aolofsson/oh/emesh/README.md

EMESH: Various emesh interface circuits
==========================================
