aolofsson/oh/parallella/README.md

PARALLELLA: FPGA logic for the parallella boards
=================================================
