aolofsson/oh/emailbox/README.md

The embox is a fifo style mailbox with an interrupt output signal
