aolofsson/oh/elink/docs/elink.pdf

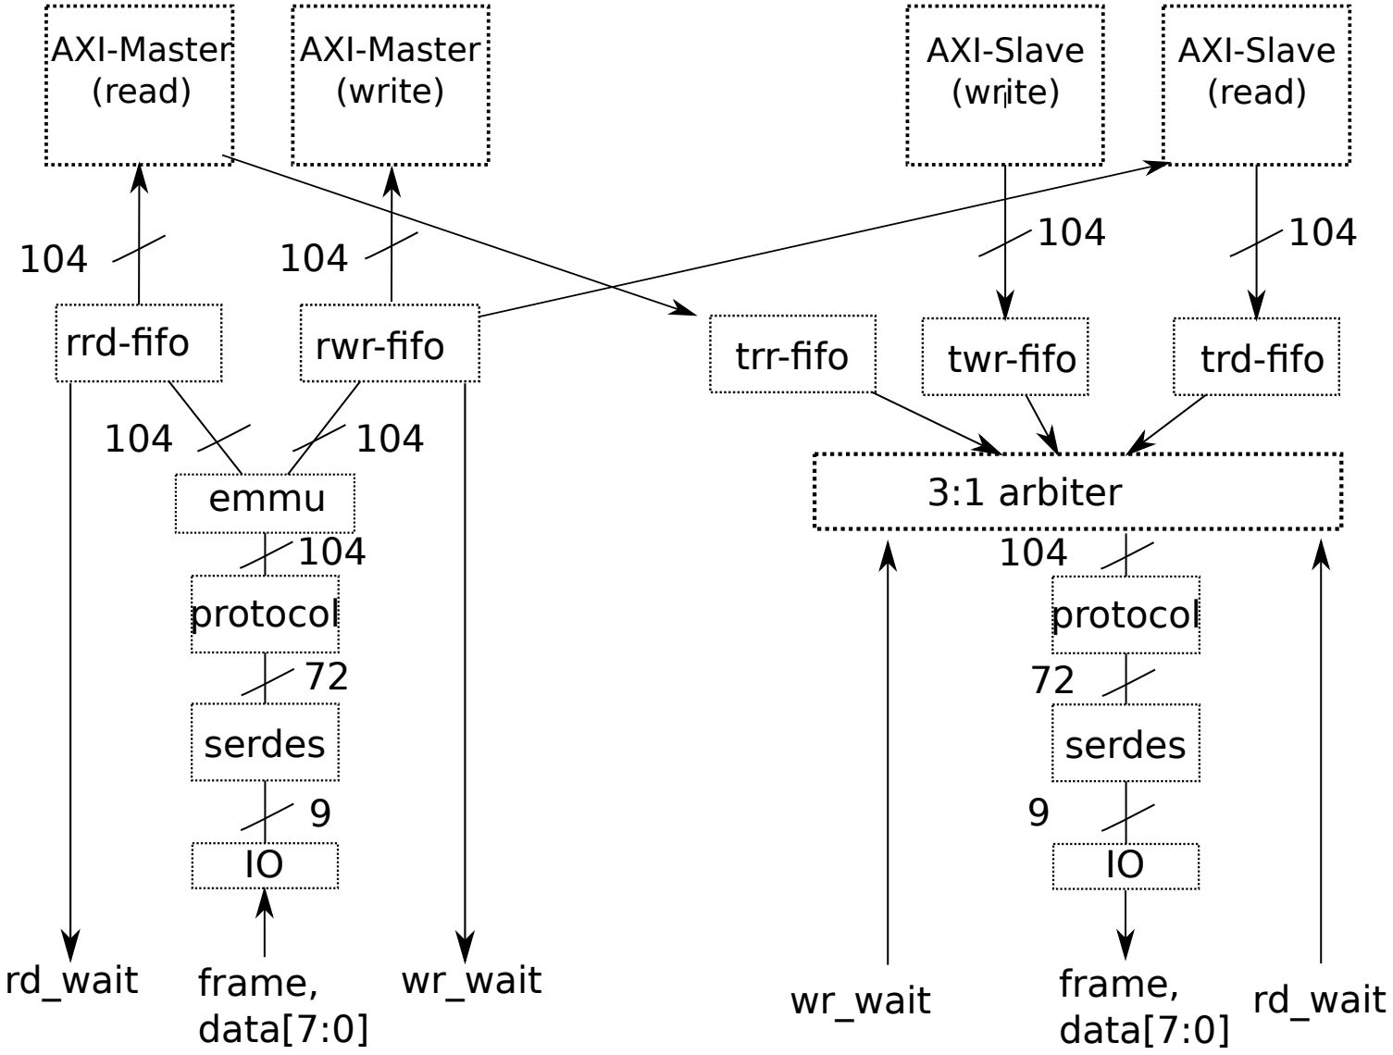
[picture p2: figure]
rrd-fifo; rwr-fifo; AXI-Master (write); AXI-Master (read); rd_wait; frame,; wr_wait; data[7:0]; serdes; protocol; emmu; AXI-Slave (write); AXI-Slave (read); frame, data[7:0]; 3:1 arbiter; trr-fifo; twr-fifo; trd-fifo

RX | TX
