aolofsson/oh/elink/docs/clocking.pdf

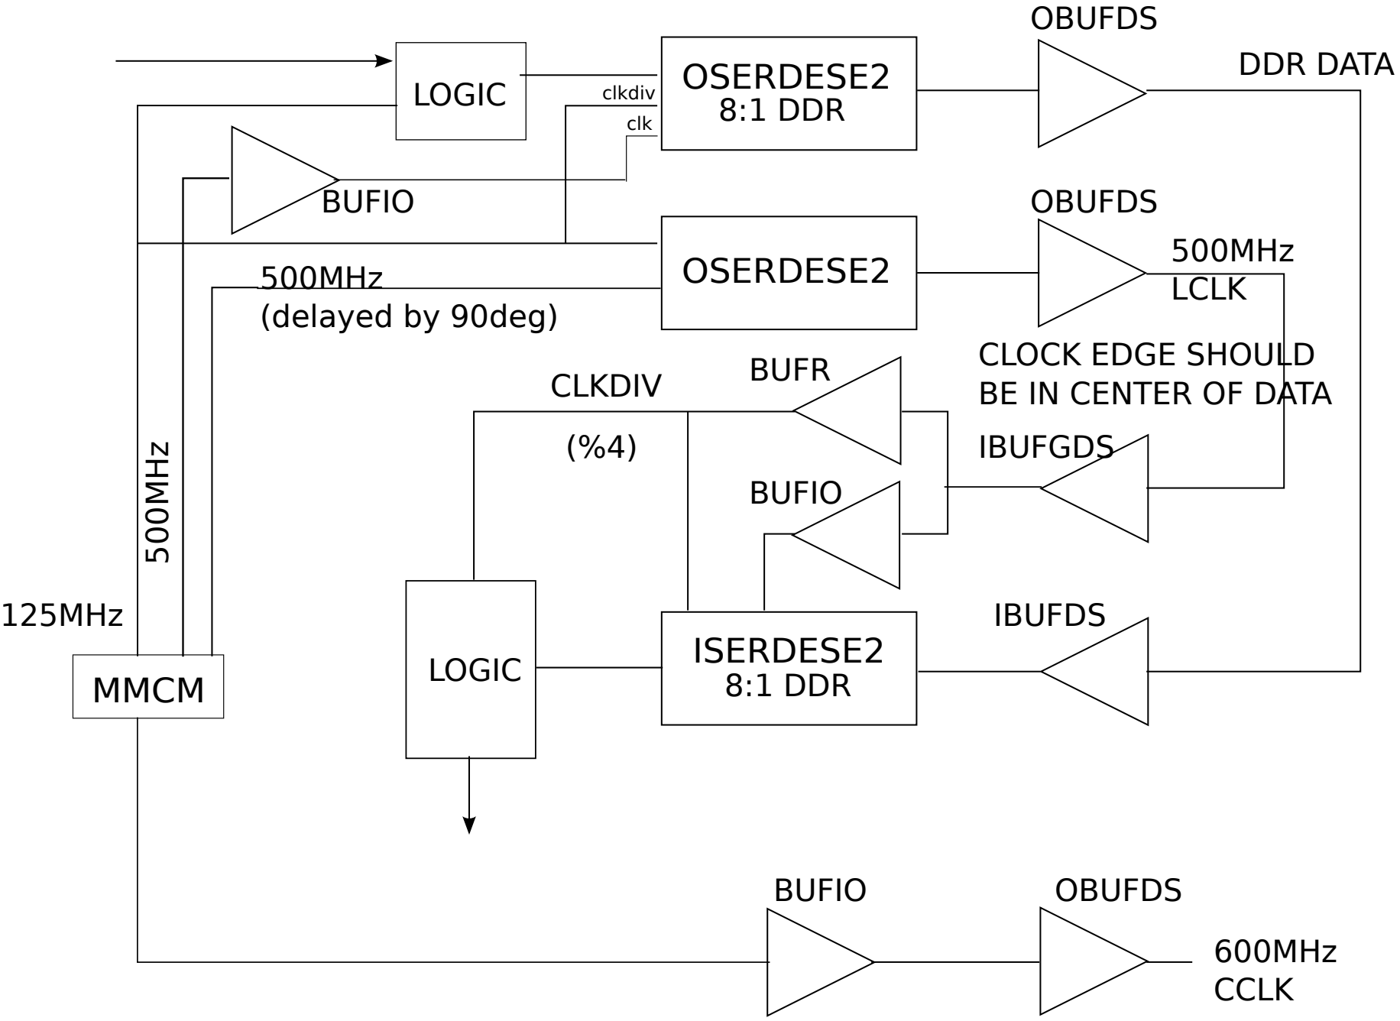
[picture p6: figure]
8:1 DDR; OSERDESE2; ISERDESE2; MMCM; 500MHz LCLK; 600MHz CCLK; OBUFDS; CLOCK EDGE SHOULD BE IN CENTER OF DATA; BUFIO; LOGIC; BUFR; CLKDIV; DDR DATA; 125MHz; 500MHz; clkdiv clk; IBUFGDS; IBUFDS; 500MHz (delayed by 90deg)
