aolofsson/oh/elink/sw/mailbox-test2/README.md

# mailbox tests

Requires the devel version of the redesigned epiphany driver, which can be
found on this branch:

https://github.com/parallella/parallella-linux/tree/ola-devel
