aolofsson/oh/(threads)

Thread 18 (2015-11-11):

streaming and dma doesn't work

olajep, 2015-11-11:
as per fred-test

olajep, 2015-11-11:
Both tests write and read from external ram, i.e., they need remapping to work.

aolofsson, 2015-12-04:
Working

Closed 2015-12-04.

Thread 19 (2015-11-11):

writes to fpga regs during reset can get lost

olajep, 2015-11-11:
1. assert reset bit
2. deassert reset bit
3. write something to RXCFG register
= write gets lost ( RXCFG = 0)

1. assert reset bit
2. deassert reset bit
3. usleep(1000)
4. write something to RXCFG register
= write gets through

Isn't there a AXI wait signal (WREADY?) we can use?

Alternatively can we do a read loop in sw over the reset register until the reset bit reads back as de-asserted?

or make it mandatory to sleep after the reset bit has been deasserted

aolofsson, 2015-11-11:
There is a tx_active signal. Let's see if we can tie this back to make write wait....
In the meantime, usleep(1000)..

olajep, 2015-11-11:
Posting again as github screwed up the formatting in the first try.

#### Case 1
1. assert reset bit
2. deassert reset bit
3. write something to RXCFG register

= write gets lost ( RXCFG = 0)

#### Case 2
1. assert reset bit
2. deassert reset bit
3. usleep(1000)
4. write something to RXCFG register

= write gets through

Isn't there a AXI wait signal (WREADY?) we can use?

Alternatively can we do a read loop in sw over the reset register until the reset bit reads back as de-asserted?

or make it mandatory to sleep after the reset bit has been deasserted

Thread 20 (2015-11-15):

mailbox read timing issue

peteasa, 2015-11-15:
I created an axi mailbox dut and tried out the same read test I tried earlier and still found the same problems
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

Description:  erx_cfgif raises mi_match correctly and mi_cfg_en is raised so that the mailbox read cycle is started, however the mailbox fifo only outputs the data on the rising edge of erx_mailbox.rd_clk and at the same time the erx_mailbox.mailbox_fifo_data with the old content gets sampled and sent to mi_dout.  This can be seen in the attached diagram because the mailbox_fifo_data to the left of the marker gets sampled in the rising edge of the clock and output on mi_dout, however on the next clock cycle the correct data is available on mailbox_fifo_data.

Potential fix is to create a erx_mailbox valid signal emailbox_access_out that must then delay erx_cfgif.access_out so that the correct mailbox data gets delivered to the rxrr fifo.  Last time I tried this fix the simulations failed because changing ecfg_if to take account of the emailbox_access_out affects the etx_cfgif block also. So it is a large change.  Perhaps now it is time to introduce this valid signal for all the ecfg_if.mi_doutX channels?

peteasa, 2015-11-15:
provided pull request that creates what might turn out to be a quick fix.  worried about the delays introduced by the various mux components in the timing chain.. may not work after synthesis

peteasa, 2015-11-28:
Now that the fpga can be loaded into the parallella board I have been trying to continue to get the mailbox working with little success so far.  I will go back to simulation in a while.. but perhaps you can tell me if I am wrong with the following:

I have an e_mailbox.c file that gets built and loaded onto the Epiphany cores.  Just like the Hello_World example.  In the Epiphany I think that I should be able to read the axi_elink registers using:

```C
#define ELINK_BASE	0x81000000
#define E_MAILBOXLO	0xF0310
...
	// Write coreid to the mailbox
	e_coreid_t * dst;
	dst = (e_coreid_t *)(ELINK_BASE | E_MAILBOXLO);
	*dst = coreid;
```
From Epiphany I should be able to read the ERX_CFG register and others as well.

This does not seem to work just yet.

Oh the host side I should be able to read the ELINK_MAILBOXHI, then the ELINK_MAILBOXLO should contain the value I stored in the Epiphany code
```C
	unsigned int mailboxEntry;
	e_debug_read(ELINK_MAILBOXHI, &mailboxEntry);
	printf("HI: 0x%x: 0x%x;  ", ELINK_MAILBOXHI, mailboxEntry);
	e_debug_read(ELINK_MAILBOXLO, &mailboxEntry);
	printf("LO: 0x%x: 0x%x\n", ELINK_MAILBOXLO, mailboxEntry);
```

I can read the registers on the host side and for example I can read the TXCFG register and get 0x1 but when I read this from the Epiphany side I just get 0x0...

Is there something wrong with my software?

aolofsson, 2015-11-29:
Sorry, you can't read the ELINK registers from the Epiphany. They are only accessible from the host. Only the mailbox is writeable (but not readable) from the  Epiphany.

It would have complicated the design and I felt that it wasn't a must have feature.

aolofsson, 2015-11-29:
Fixed the zero order bug on the readback. Once everything else is working, this is a quick fix. (fix is very similiar to 2nd pull request you made). I did not take the pull request as is for style reasons. Hope that's OK, it's just a few lines of code.

Also, there is a silly conceptual bug that I missed. (realized it when I started testing). There is no way to reach 810f0310 from the Epiphany (since this would be routing to the west). I will fix this tomorrow.

peteasa, 2015-11-29:
Not very interested in mailbox readback from epiphany core.

Sounds like my software should have worked so I will try it out with the latest mailbox hdl later this week.  I put the example software in https://github.com/peteasa/examples/tree/parallella-oh/epiphany/mailbox only slight change from the hello world code for now.  But I am guessing that e-lib will change at some point to add specific api for access to the mailbox, plus some small changes to the epiphany driver code to add interrupt handling.

It was fun to see the hello_world test working with the new oh fpga.

peteasa, 2015-11-29:
Puzzled about the comment about routing to the west...  If the Node address is 0x808 ie col 8 row 32 and the destination is 0x810 ie col 16 row 32 then I would have expected routing east to get closer to the higher col number....  back to the typo in the architecture spec.. I believe the diagrams not the words or the table.

aolofsson, 2015-11-29:
Sorry about confusion. Was tired last night...the problem was in the remap
circuit. About to check in working mailbox..reads have been verified.
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

peteasa, 2015-11-30:
It works a treat for me also!  Well done!  Each core is reporting its ID via the mailbox with my test app...
# /usr/epiphany/bin/mailbox
main: rows,cols: ( 4, 4)
main:   0: Message from eCore 0x808 ( 0, 0): main: Error in e_load 37056
"Hello World from core 0x808!"
PRE_STAT=00000001 POST_STAT=00000000 LO=00000808 HI=810f0320
PRE_STAT=00000000 POST_STAT=00000000 LO=00000808 HI=810f0320
main:   1: Message from eCore 0x809 ( 0, 1): main: Error in e_load 37056
"Hello World from core 0x809!"
PRE_STAT=00000001 POST_STAT=00000000 LO=00000809 HI=810f0320
PRE_STAT=00000000 POST_STAT=00000000 LO=00000809 HI=810f0320
main:   2: Message from eCore 0x80a ( 0, 2): main: Error in e_load 37056
"Hello World from core 0x80a!"
PRE_STAT=00000001 POST_STAT=00000000 LO=0000080a HI=810f0320
PRE_STAT=00000000 POST_STAT=00000000 LO=0000080a HI=810f0320

Closed 2015-11-30.

Thread 23 (2015-11-29):

System hangs when mailbox interrupt is enabled

aolofsson, 2015-11-29:
I have wired up the mailbox interrupt to the PS system to core0_nFIQ, but when I enable the interrupt he system hangs. To enable the interrupt, set bit [28] of RXCFG to 1. Assuming that we have to install an ISR in calling software from host or something?

An example of mailbox (with polling) can be found in elink/sw/mailbox

Would love to see this work finally:-))

cc @olajep  @peteasa

peteasa, 2015-12-12:
Proof that the system works with interrupts (apart from the slight problem of having to reset the epiphany after each interrupt!)

```
# /usr/epiphany/bin/mailbox
InitialEpiphany(): rows,cols: ( 4, 4)
main(): devfd 6, epollfd 5, kernelEventfd 7, cancelfd 8
RunTest():   0: Message from eCore 0x808 ( 0, 0): "Hello World from core 0x808!"
main(): PRE_STAT=00000001 POST_STAT=00000000 LO=00000808 HI=810f0320
RunTest():   1: Message from eCore 0x809 ( 0, 1): "Hello World from core 0x809!"
main(): PRE_STAT=00000001 POST_STAT=00000000 LO=00000809 HI=810f0320
RunTest():   2: Message from eCore 0x80a ( 0, 2): "Hello World from core 0x80a!"
main(): PRE_STAT=00000001 POST_STAT=00000000 LO=0000080a HI=810f0320
RunTest():   3: Message from eCore 0x80b ( 0, 3): "Hello World from core 0x80b!"
main(): PRE_STAT=00000001 POST_STAT=00000000 LO=0000080b HI=810f0320
RunTest():   4: Message from eCore 0x848 ( 1, 0): "Hello World from core 0x848!"
main(): PRE_STAT=00000001 POST_STAT=00000000 LO=00000848 HI=810f0320
RunTest():   5: Message from eCore 0x849 ( 1, 1): "Hello World from core 0x849!"
main(): PRE_STAT=00000001 POST_STAT=00000000 LO=00000849 HI=810f0320
RunTest():   6: Message from eCore 0x84a ( 1, 2): "Hello World from core 0x84a!"
main(): PRE_STAT=00000001 POST_STAT=00000000 LO=0000084a HI=810f0320
RunTest():   7: Message from eCore 0x84b ( 1, 3): "Hello World from core 0x84b!"
main(): PRE_STAT=00000001 POST_STAT=00000000 LO=0000084b HI=810f0320
RunTest():   8: Message from eCore 0x888 ( 2, 0): "Hello World from core 0x888!"
main(): PRE_STAT=00000001 POST_STAT=00000000 LO=00000888 HI=810f0320
RunTest():   9: Message from eCore 0x889 ( 2, 1): "Hello World from core 0x889!"
main(): PRE_STAT=00000001 POST_STAT=00000000 LO=00000889 HI=810f0320
RunTest():  10: Message from eCore 0x88a ( 2, 2): "Hello World from core 0x88a!"
main(): PRE_STAT=00000001 POST_STAT=00000000 LO=0000088a HI=810f0320
RunTest():  11: Message from eCore 0x88b ( 2, 3): "Hello World from core 0x88b!"
main(): PRE_STAT=00000001 POST_STAT=00000000 LO=0000088b HI=810f0320
RunTest():  12: Message from eCore 0x8c8 ( 3, 0): "Hello World from core 0x8c8!"
main(): PRE_STAT=00000001 POST_STAT=00000000 LO=000008c8 HI=810f0320
RunTest():  13: Message from eCore 0x8c9 ( 3, 1): "Hello World from core 0x8c9!"
main(): PRE_STAT=00000001 POST_STAT=00000000 LO=000008c9 HI=810f0320
RunTest():  14: Message from eCore 0x8ca ( 3, 2): "Hello World from core 0x8ca!"
main(): PRE_STAT=00000001 POST_STAT=00000000 LO=000008ca HI=810f0320
RunTest():  15: Message from eCore 0x8cb ( 3, 3): "Hello World from core 0x8cb!"
main(): PRE_STAT=00000001 POST_STAT=00000000 LO=000008cb HI=810f0320
main(): wait for SleepThenCancel thread to terminate
```

Closed 2016-01-25.

Thread 24 (2015-12-03):

latest fails to build

peteasa, 2015-12-03:
ERROR: [Synth 8-439] module 'dsync' not found - sources_1/ipshared/www.parallella.org/parallella_base_v1_0/258848fc/src/emaxi.v:424]
ERROR: [Synth 8-285] failed synthesizing module 'emaxi'
ERROR: [Synth 8-285] failed synthesizing module 'axi_elink'
ERROR: [Synth 8-285] failed synthesizing module 'parallella_base'
ERROR: [Synth 8-285] failed synthesizing module 'system_parallella_base_0_0'
ERROR: [Synth 8-285] failed synthesizing module 'system'
ERROR: [Synth 8-285] failed synthesizing module 'system_wrapper'

aolofsson, 2015-12-04:
I am not seeing that? (even did a clean co to verify).  However, I did just check in a couple of small fixes that popped up. (I am using the "common" folder for some other stuff, and managed to break something). Changes settling down this week...

peteasa, 2015-12-04:
synth working again with latest catchup.

./build.sh works with latest catchup

./build_axi_elink.sh fails:

./build_axi_elink.sh
../../axi/hdl/esaxi.v:21: warning: macro EGROUP_RR undefined (and assumed null) at this point.
../../axi/hdl/esaxi.v:21: syntax error
../../axi/hdl/esaxi.v:21: error: syntax error in parameter list.
../../axi/hdl/esaxi.v:449: error: Unable to bind wire/reg/memory `RETURN_ADDR' in `dv_top.dut.elink1.esaxi'
../../axi/hdl/esaxi.v:449: error: Unable to bind wire/reg/memory `RETURN_ADDR' in `dv_top.dut.esaxi'
2 error(s) during elaboration.

different issue so I will close this

Closed 2015-12-04.

Thread 25 (2015-12-06):

interrupt handling

peteasa, 2015-12-06:
Ok I know this is not likely to be hardware ... but I now have an updated epiphany driver running in my kernel that handles the interrupts from the mailbox.  https://github.com/peteasa/examples/tree/parallella-oh/epiphany/mailbox

Right now I have a strange problem when using it:
I visit each core in the Epiphany chip and from that core write to the mailbox the core id of the core.
In the driver I map the ERX_CFG registers with devm_ioremap_resource() and in the interrupt handler I simply disable the interrupt in ERX_CFG.  In the near future I would like a sysfile with the number of messages pending, but for now I keep it simple and from the command line monitor how many interrupts I have seen using the contents of /proc/interrupts.
Before visiting each core I enable the interrupt in the host application using a new ioctl call to the driver.  After the core has sent the message back via the mailbox I read the number of messages with a call to ee_read_esys() and read the message to clear the source of the interrupt.
After the first core it seems that something goes wrong with the loading of the epiphany code.  So I stopped reading the messages till the end of the run and this is what I get:
```C
			int mbox_lo     = ee_read_esys(ELINK_MAILBOXLO);
			int mbox_hi     = ee_read_esys(ELINK_MAILBOXHI);
			int post_stat   = ee_read_esys(ELINK_MAILBOXSTAT);
			printf ("main(): PRE_STAT=%08x POST_STAT=%08x LO=%08x HI=%08x\n", pre_stat, post_stat, mbox_lo, mbox_hi);
```
/usr/epiphany/bin/mailbox
main: rows,cols: ( 4, 4)
main:   0: Message from eCore 0x808 ( 0, 0): main: Error in e_load 35476
"Hello World from core 0x808!"
main:   1: Message from eCore 0x809 ( 0, 1): main: Error in e_load 35476
"Hello World from core 0x809!"
main:   2: Message from eCore 0x80a ( 0, 2): main: Error in e_load 35476
...
main(): PRE_STAT=00000001 POST_STAT=00000001 LO=00000808 HI=810f0320
main(): PRE_STAT=00000001 POST_STAT=00000001 LO=00000809 HI=810f0320
main(): PRE_STAT=00000001 POST_STAT=00000001 LO=0000080a HI=810f0320
main(): PRE_STAT=00000001 POST_STAT=00000001 LO=0000080b HI=810f0320
main(): PRE_STAT=00000001 POST_STAT=00000001 LO=00000848 HI=810f0320
main(): PRE_STAT=00000001 POST_STAT=00000001 LO=00000849 HI=810f0320
main(): PRE_STAT=00000001 POST_STAT=00000001 LO=0000084a HI=810f0320
main(): PRE_STAT=00000001 POST_STAT=00000001 LO=0000084b HI=810f0320
...

So for each of the cores I get a message via the mailbox and I also get a good collection of interrupts (actually 17 because I enable the interrupt before checking if I have visited each core)

So this proves that the interrupt handler correctly disables the interrupt and does not affect the user side memory mapping used to read the messages from the cores.

Not sure why when attempting to read the mailbox inside the loop after visiting each core results in failure:

/usr/epiphany/bin/mailbox
main: rows,cols: ( 4, 4)
main(): About to enable interrupt, RxCFG=03e0fe04
[   95.915738] enable mailbox irq
[   95.918780] enable_mailbox_irq: state: 0 rxcfg: 3e0fe04
[   95.924109] enable_mailbox_irq: state: 0 rxcfg after: 13e0fe04
main(): After enable RxCFG=13e0fe04
main:   0: Message from eCore 0x808 ( 0, 0): "Hello World from core 0x808!"
main(): After Interrupt RxCFG=03e0fe04
main(): PRE_STAT=00000001 POST_STAT=00000000 LO=00000808 HI=810f0320
main(): Abo[   96.109023] enable mailbox irq
ut to enable interrupt, RxCFG=03e0fe0c
[   96.117587] enable_mailbox_irq: state: 0 rxcfg: 3e0fe0c
[   96.126361] enable_mailbox_irq: state: 0 rxcfg after: 13e0fe0c
main(): After enable RxCFG=13e0fe0c
main:   1: Message from eCore 0x809 ( 0, 1): ""
main(): After Interrupt RxCFG=13e0fe0c
main(): ERROR: mailbox txfer stopped!

Notice that for some reason I dont get the error in e_load, but also the second e_load does not seem to work because the second core 0x809 does not get a chance to send a mailbox message...  The only thing changed between these two runs is adding the ee_read_esys() for Mailbox Lo and Mailbox Hi at the end after all cores have been visited or after visiting each core.

Just to show how odd this problem is I have created a second version of the mailbox host program using ee_read_esys / ee_write_esys to enable the interrupts and now I get two complete cycles of my hello world loop before the e_load fails:

/usr/epiphany/bin/mailbox
main: rows,cols: ( 4, 4)
main:   0: Message from eCore 0x808 ( 0, 0): "Hello World from core 0x808!"
main(): PRE_STAT=00000001 POST_STAT=00000000 LO=00000808 HI=810f0320
main:   1: Message from eCore 0x809 ( 0, 1): "Hello World from core 0x809!"
main(): PRE_STAT=00000001 POST_STAT=00000000 LO=00000809 HI=810f0320
main:   2: Message from eCore 0x80a ( 0, 2): ""
main(): ERROR: mailbox txfer stopped!

Any ideas welcome!

peteasa, 2015-12-06:
By the way the number of messages in the mailbox queue might be of use.

aolofsson, 2015-12-06:
From the printout it seems that all the cores are printing back Hello
World. Is the concern "Error in e_load 35476"?
Can you send a pointer to the example code?

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

--
----------------------------------------------------------------
Andreas Olofsson, CEO/Founder at Adapteva
Cell: +1 781 325 6688
Twitter: @adapteva
Web: adapteva.com
Linkedin: linkedin.com/in/andreasolofsson
----------------------------------------------------------------
<http://www.adapteva.com/>

peteasa, 2015-12-07:
All code is avialable at https://github.com/peteasa/examples/tree/parallella-oh/epiphany/mailbox
New driver see - https://github.com/peteasa/examples/blob/parallella-oh/epiphany/mailbox/kernel/epiphany.c

I guess this driver already answers the earlier issue you have about crashing when the interrupts are switched on!

New test code see - https://github.com/peteasa/examples/blob/parallella-oh/epiphany/mailbox/host/mailbox.c

I am not too worried about the Error in e_load.. more about the failure of the sequence:
```
ee_write_esys(ELINK_RXCFG, rxcfg | (0x1 << 28))
e_load("/usr/epiphany/bin/e_mailbox.srec", &dev, 0, 0, E_TRUE);
** interrupt occurs and in the handler - cfg = reg_read(&mailbox, ERX_CFG); 	reg_write(&mailbox, ERX_CFG, cfg & ~MAILBOX_ENABLE);
int items = ee_read_esys(ELINK_MAILBOXSTAT);
ee_read_esys(ELINK_MAILBOXLO);
ee_write_esys(ELINK_RXCFG, rxcfg | (0x1 << 28))
e_load("/usr/epiphany/bin/e_mailbox.srec", &dev, 0, 0, E_TRUE);
***** Hmm.. the core load seems to fail at this point ******
***** so no interrupt and no data ****
xx int items = ee_read_esys(ELINK_MAILBOXSTAT);
xx ee_read_esys(ELINK_MAILBOXLO);
```
The following sequence works just fine:
```
ee_write_esys(ELINK_RXCFG, rxcfg | (0x1 << 28))
e_load("/usr/epiphany/bin/e_mailbox.srec", &dev, 0, 0, E_TRUE);
** interrupt occurs and in the handler - cfg = reg_read(&mailbox, ERX_CFG); 	reg_write(&mailbox, ERX_CFG, cfg & ~MAILBOX_ENABLE);
e_load("/usr/epiphany/bin/e_mailbox.srec", &dev, 0, 0, E_TRUE);
ee_write_esys(ELINK_RXCFG, rxcfg | (0x1 << 28))
e_load("/usr/epiphany/bin/e_mailbox.srec", &dev, 0, 0, E_TRUE);
** interrupt occurs and in the handler - cfg = reg_read(&mailbox, ERX_CFG); 	reg_write(&mailbox, ERX_CFG, cfg & ~MAILBOX_ENABLE);
e_load("/usr/epiphany/bin/e_mailbox.srec", &dev, 0, 0, E_TRUE);
....
int items = ee_read_esys(ELINK_MAILBOXSTAT);
ee_read_esys(ELINK_MAILBOXLO);
```

aolofsson, 2015-12-09:
Just to make sure..the MAILBOXSTAT currently only returns not_empty. I see that you read it into "items". The indicator is binary, you will have to poll between every read to see if it's empty. We can change this. Just wanted to make sure there is no spec confusion.

peteasa, 2015-12-09:
That realization led me to comment "By the way the number of messages in the mailbox queue might be of use."  Anyway I have almost got the epoll event thing working now and I dont think that it depends on a change in entry.  What should happen is that epoll_wait returns when it sees that there is a chance to read a new entry... not sure if it works yet but if not there is a way because commands like tail -f /var/log/messages keep printing the new stuff just added at the end of a file.. same mechanism will allow user side code to see when the interrupt handler has updated the new sysfs file /sys/class/epiphany/epiphany/mailbox_state... more once I have got this going.

aolofsson, 2015-12-10:
Yes, the concept of having fifo count as a readable quantity is great. Less interrupts to service from host side means more messages / sec once we have this working.:-)

peteasa, 2015-12-12:
My driver is now working well and the interrupt from the kernel is working... but I still cant get the e_load to work after the mailbox register has been read.  For now I have commented out the code in the interrupt handler that reads the mailbox.. that way, provided you dont read the mailbox on the user side at least you get the interrupt.  The mailbox host program demos the most odd case:
```
e_load,
enable interrupt,
interrupt
disable interrupt,
read lo / hi
e_load
enable interrupt,
interrupt
disable interrupt,
read lo / hi
e_load .... at this point e_load does not seem to work!!
enable interrupt...
timeout.
```

```
# /usr/epiphany/bin/mailbox
InitialEpiphany(): rows,cols: ( 4, 4)
main(): devfd 6, epollfd 5, kernelEventfd 7, cancelfd 8
RunTest():   0: Message from eCore 0x808 ( 0, 0): RunTest(): pre_stat: 1
RunTest(): mbox_lo: 808
RunTest(): mbox_hi: 810f0320
RunTest(): post_stat: 0
"Hello World from core 0x808!"
RunTest():   1: Message from eCore 0x809 ( 0, 1): RunTest(): pre_stat: 1
RunTest(): mbox_lo: 809
RunTest(): mbox_hi: 810f0320
RunTest(): post_stat: 0
"Hello World from core 0x809!"
RunTest():   2: Message from eCore 0x80a ( 0, 2): RunTest(): pre_stat: 0
RunTest(): mbox_lo: 809
RunTest(): mbox_hi: 810f0320
RunTest(): post_stat: 0

INFO: SleepThenCancel(): Cancelling!
```

peteasa, 2015-12-12:
And I have just found a work round!... Not very pleasant but it works
```
e_reset_system()
e_load,
enable interrupt,
interrupt
disable interrupt,
read lo / hi
e_reset_system()
e_load
enable interrupt,
interrupt
disable interrupt,
read lo / hi
e_reset_system()
e_load .. it continues to work
enable interrupt...
timeout.
```

Not good to have to reset the system but at least it works!

peteasa, 2015-12-12:
And now that I am looking at the hdl I find a potential issue....
```
# /usr/epiphany/bin/mailbox
InitialEpiphany(): rows,cols: ( 4, 4)
main(): devfd 6, epollfd 5, kernelEventfd 7, cancelfd 8
RunTest():   0: Message from eCore 0x808 ( 0, 0): "Hello World from core 0x808!"
RunTest(): PRE_STAT=00000001 POST_STAT=00000000 LO=00000808 HI=810f0320
RunTest(): etx_status: f8, erx_status: 808
RunTest():   1: Message from eCore 0x809 ( 0, 1): "Hello World from core 0x809!"
RunTest(): PRE_STAT=00000001 POST_STAT=00000000 LO=00000809 HI=810f0320
RunTest(): etx_status: f8, erx_status: 809
RunTest():   2: Message from eCore 0x80a ( 0, 2):
INFO: SleepThenCancel(): Cancelling!
INFO: WaitForMailboxNotifier(): Cancelled!
""
RunTest(): etx_status: f8, erx_status: 809
```

In my failing case I find that erx_status is 0x809 ie rxwr_wait is active.. not that can not be good!  This seems to be why I have to reset the system to get things going again.

peteasa, 2015-12-12:
Now instead of resetting the system I set the first value I read
```
ee_write_esys(ELINK_RXCFG, 0x3e0fe04))
```
and it all works!

So this does seem to be a problem where the ERX_CFG register gets corrupted..

```
# /usr/epiphany/bin/mailbox
InitialEpiphany(): rows,cols: ( 4, 4)
main(): devfd 6, epollfd 5, kernelEventfd 7, cancelfd 8
RunTest(): rxcfg register 0x3e0fe04 0x3e0fe04 0x3e0fe04
RunTest():   0: Message from eCore 0x808 ( 0, 0): "Hello World from core 0x808!"
RunTest(): PRE_STAT=00000001 POST_STAT=00000000 LO=00000808 HI=810f0320
RunTest(): etx_status: 0xf8, etx_config: 0x1, erx_status: 0x808, erx_config: 0x3e0fe0c
RunTest(): rxcfg register 0x3e0fe0c 0x3e0fe0c 0x3e0fe0c
RunTest():   1: Message from eCore 0x809 ( 0, 1): "Hello World from core 0x809!"
RunTest(): PRE_STAT=00000001 POST_STAT=00000000 LO=00000809 HI=810f0320
RunTest(): etx_status: 0xf8, etx_config: 0x1, erx_status: 0x809, erx_config: 0x3e0fe0d
RunTest(): rxcfg register 0x3e0fe0d 0x3e0fe0d 0x3e0fe0d
RunTest():   2: Message from eCore 0x80a ( 0, 2): "Hello World from core 0x80a!"
RunTest(): PRE_STAT=00000001 POST_STAT=00000000 LO=0000080a HI=810f0320
RunTest(): etx_status: 0xf8, etx_config: 0x1, erx_status: 0x80a, erx_config: 0x3e0fe0f
RunTest(): rxcfg register 0x3e0fe0f 0x3e0fe0e 0x3e0fe0e
RunTest():   3: Message from eCore 0x80b ( 0, 3): "Hello World from core 0x80b!"
RunTest(): PRE_STAT=00000001 POST_STAT=00000000 LO=0000080b HI=810f0320
RunTest(): etx_status: 0xf8, etx_config: 0x1, erx_status: 0x80b, erx_config: 0x3e0fe0f
RunTest(): rxcfg register 0x3e0fe0f 0x3e0fe0f 0x3e0fe0f
RunTest():   4: Message from eCore 0x848 ( 1, 0): "Hello World from core 0x848!"
RunTest(): PRE_STAT=00000001 POST_STAT=00000000 LO=00000848 HI=810f0320
RunTest(): etx_status: 0xf8, etx_config: 0x1, erx_status: 0x848, erx_config: 0x3e0fe4f
RunTest(): rxcfg register 0x3e0fe4f 0x3e0fe4c 0x3e0fe4c
RunTest():   5: Message from eCore 0x849 ( 1, 1): "Hello World from core 0x849!"
RunTest(): PRE_STAT=00000001 POST_STAT=00000000 LO=00000849 HI=810f0320
RunTest(): etx_status: 0xf8, etx_config: 0x1, erx_status: 0x849, erx_config: 0x3e0fe4d
RunTest(): rxcfg register 0x3e0fe4d 0x3e0fe4d 0x3e0fe4d
RunTest():   6: Message from eCore 0x84a ( 1, 2): "Hello World from core 0x84a!"
RunTest(): PRE_STAT=00000001 POST_STAT=00000000 LO=0000084a HI=810f0320
RunTest(): etx_status: 0xf8, etx_config: 0x1, erx_status: 0x84a, erx_config: 0x3e0fe4f
RunTest(): rxcfg register 0x3e0fe4f 0x3e0fe4e 0x3e0fe4e
RunTest():   7: Message from eCore 0x84b ( 1, 3): "Hello World from core 0x84b!"
RunTest(): PRE_STAT=00000001 POST_STAT=00000000 LO=0000084b HI=810f0320
RunTest(): etx_status: 0xf8, etx_config: 0x1, erx_status: 0x84b, erx_config: 0x3e0fe4f
RunTest(): rxcfg register 0x3e0fe4f 0x3e0fe4f 0x3e0fe4f
RunTest():   8: Message from eCore 0x888 ( 2, 0): "Hello World from core 0x888!"
RunTest(): PRE_STAT=00000001 POST_STAT=00000000 LO=00000888 HI=810f0320
RunTest(): etx_status: 0xf8, etx_config: 0x1, erx_status: 0x888, erx_config: 0x3e0fecf
RunTest(): rxcfg register 0x3e0fecf 0x3e0fe8c 0x3e0fe8c
RunTest():   9: Message from eCore 0x889 ( 2, 1): "Hello World from core 0x889!"
RunTest(): PRE_STAT=00000001 POST_STAT=00000000 LO=00000889 HI=810f0320
RunTest(): etx_status: 0xf8, etx_config: 0x1, erx_status: 0x889, erx_config: 0x3e0fe8d
RunTest(): rxcfg register 0x3e0fe8d 0x3e0fe8d 0x3e0fe8d
RunTest():  10: Message from eCore 0x88a ( 2, 2): "Hello World from core 0x88a!"
RunTest(): PRE_STAT=00000001 POST_STAT=00000000 LO=0000088a HI=810f0320
RunTest(): etx_status: 0xf8, etx_config: 0x1, erx_status: 0x88a, erx_config: 0x3e0fe8f
RunTest(): rxcfg register 0x3e0fe8f 0x3e0fe8e 0x3e0fe8e
RunTest():  11: Message from eCore 0x88b ( 2, 3): "Hello World from core 0x88b!"
RunTest(): PRE_STAT=00000001 POST_STAT=00000000 LO=0000088b HI=810f0320
RunTest(): etx_status: 0xf8, etx_config: 0x1, erx_status: 0x88b, erx_config: 0x3e0fe8f
RunTest(): rxcfg register 0x3e0fe8f 0x3e0fe8f 0x3e0fe8f
RunTest():  12: Message from eCore 0x8c8 ( 3, 0): "Hello World from core 0x8c8!"
RunTest(): PRE_STAT=00000001 POST_STAT=00000000 LO=000008c8 HI=810f0320
RunTest(): etx_status: 0xf8, etx_config: 0x1, erx_status: 0x8c8, erx_config: 0x3e0fecf
RunTest(): rxcfg register 0x3e0fecf 0x3e0fecc 0x3e0fecc
RunTest():  13: Message from eCore 0x8c9 ( 3, 1): "Hello World from core 0x8c9!"
RunTest(): PRE_STAT=00000001 POST_STAT=00000000 LO=000008c9 HI=810f0320
RunTest(): etx_status: 0xf8, etx_config: 0x1, erx_status: 0x8c9, erx_config: 0x3e0fecd
RunTest(): rxcfg register 0x3e0fecd 0x3e0fecd 0x3e0fecd
RunTest():  14: Message from eCore 0x8ca ( 3, 2): "Hello World from core 0x8ca!"
RunTest(): PRE_STAT=00000001 POST_STAT=00000000 LO=000008ca HI=810f0320
RunTest(): etx_status: 0xf8, etx_config: 0x1, erx_status: 0x8ca, erx_config: 0x3e0fecf
RunTest(): rxcfg register 0x3e0fecf 0x3e0fece 0x3e0fece
RunTest():  15: Message from eCore 0x8cb ( 3, 3): "Hello World from core 0x8cb!"
RunTest(): PRE_STAT=00000001 POST_STAT=00000000 LO=000008cb HI=810f0320
RunTest(): etx_status: 0xf8, etx_config: 0x1, erx_status: 0x8cb, erx_config: 0x3e0fecf
RunTest(): rxcfg register 0x3e0fecf 0x3e0fecf 0x3e0fecf
main(): wait for SleepThenCancel thread to terminate
```

peteasa, 2015-12-19:
Ok so I have created a pull request for you to consider.  I have simulated this and will now try it out on hardware, but the logic is sound.  You may have an alternative way of providing a fix so I have created the pull request now for you to have a look at the proposed fix.

Notice that the OR of 000008cb | 0x3e0fe04 == 0x3e0fecf.. ie both config and emailbox data are active in the ecfg_if.v mi_dout_mux...  My fix filters out the mailbox data thus in the simulation at least fixing the apparent corruption in the register read.

The kernel driver that I have written uses the config register read to do a read modify write to enable / disable the interrupts.  Thus with this bug my kernel driver reads the wrong value from the config register and then writes this whenever the enable / disable of the interrupt is attempted.  This then causes the whole interface to stop functioning... oops!

peteasa, 2015-12-19:
This fix works with hardware also...  I have now found the next issue to investigate.. The new problem occurs without interrupts.  I made a slight modification to your mailbox test where I loop round multiple times rather than just load one core.  In this problem the e-loader fails during e_start(dev, irow, icol).  The board just locks up and no access is possible.. more later when I have had time to investigate this different problem.

aolofsson, 2015-12-19:
Thats great! I will review pr tonight. In regards to lockup, just want to
make sure we are in sync on reser sequence. In order to get thw rx readback
to work reliably, you have yo set the idelay to 7. I dont think this is is
in the regular elib yet. I will send an example.
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

peteasa, 2015-12-20:
Added a pull request with my changes to the elink/sw/mailbox test.  Also added the driver that I am using today so that anyone can try this out.  The e-main.c file will compile and run with or without the interrupt enabled kernel changes.  The new failure occurs with or without the new interrupt enabled kernel.  To enable interrupts replace the kernel epiphany.c / epiphany.h and rebuild, make sure epiphany.h is in the include path for the e-main.c build and build but change UseInterrupts = 1 in e-main.c and the test will not use a usleep delay but will use interrupts. .. hmm also the device tree needs update adding
<pre>
		elink2_esaxi_0: esaxi@80000000 {
			compatible = "xlnx,parallella-base-1.0";
			interrupt-parent = <&ps7_scugic_0>;
			interrupts = <0 57 4>;
			reg = <0x80000000 0x40000000>;
			xlnx,read-tag-addr = <0x810>;
</pre>

peteasa, 2015-12-21:
closing this issue because it is fixed and the new problem is unrelated to the fix or this issue.

Closed 2015-12-21.

Thread 28 (2015-12-21):

messages from epiphany -> mailbox are limited.

peteasa, 2015-12-21:
This is the new issue that I am hoping to sort.  Very odd because even without interrupts enabled the number of messages back from a core seem to be limited.  I changed the e-task.c file:
<pre>
int main(void){
  int *mailbox= (int *) MAILBOX_ADDR;
  long long message = 0xfedcba9876543210;
  e_memcopy(mailbox, &message, sizeof(message))
  message++;
  e_memcopy(mailbox, &message, sizeof(message));
}
</pre>
and the e-main process hangs after about 5 loops, with only one write the e-main process hangs after about 9 loops.  I looked again at the simulations of the emailbox and can not see why this might happen.  It is also possible to run as many other non-mailbox tests between the mailbox test runs.. still you get the same behaviour where on about the 8 or 9th mailbox write from the epiphany core the linux system just hangs with no additional log output and only reboot will fix.
<pre> ./test.sh
INFO: loopcount: 0, row: 0, col: 0
main(0,0): Load core
main(0,0): Core Loaded
PRE_STAT=00000001 POST_STAT=00000001 LO=76543210 HI=fedcba98
PRE_STAT=00000001 POST_STAT=00000000 LO=76543211 HI=fedcba98
INFO: etx_status: 0xf8, etx_config: 0x1, erx_status: 0x8, erx_config: 0x300f004
INFO: erx_idelay0: 0x0, erx_idelay1: 0x0
/home/root/sw/mailbox/test.sh PASSED

 ./test.sh
INFO: loopcount: 0, row: 0, col: 0
main(0,0): Load core
main(0,0): Core Loaded
PRE_STAT=00000001 POST_STAT=00000001 LO=76543210 HI=fedcba98
PRE_STAT=00000001 POST_STAT=00000000 LO=76543211 HI=fedcba98
INFO: etx_status: 0xf8, etx_config: 0x1, erx_status: 0x8, erx_config: 0x300f004
INFO: erx_idelay0: 0x0, erx_idelay1: 0x0
/home/root/sw/mailbox/test.sh PASSED
</pre>
... two more times then on the fifth run ->
<pre>
./test.sh
INFO: loopcount: 0, row: 0, col: 0
main(0,0): Load core
main(0,0): Core Loaded
PRE_STAT=00000001 POST_STAT=00000001 LO=76543210 HI=fedcba98
PRE_STAT=00000001 POST_STAT=00000000 LO=76543211 HI=fedcba98
INFO: etx_status: 0xf8, etx_config: 0x1, erx_status: 0x8, erx_config: 0x300f004
INFO: erx_idelay0: 0x0, erx_idelay1: 0x0
/home/root/sw/mailbox/test.sh PASSED
root@parallella-hdmi:~/sw/mailbox# ./test.sh
INFO: loopcount: 0, row: 0, col: 0
main(0,0): Load core
</pre>
it hangs up... reboot needed to recover

Tried sending two messages from each of 5 cores and the same behaviour occurs when the 5th core is loaded the system hangs with no log messages and you have to reboot to recover.

As mentioned running any of the tests (hello_world, idelay etc) after the 4th run has no effect.  Next time you run the mailbox test and send messages from any core to the mailbox the system hangs up.

peteasa, 2015-12-23:
This problem seems to have been introduced in commit ddfeebd33ff8e6c72bf7a313b146fa45d5a88510 - Cleaning up read response logic

peteasa, 2016-01-03:
Updated the test code to use WAIT and can see several places where the access freeze can occur.  One has been committed that makes a lot of difference to this issue.  https://github.com/parallella/oh/pull/30

peteasa, 2016-01-09:
Well the simulations work ok now, but the latest simulation fix is not good enough to fix the fpga.  Still works with simple hello world but as soon as you start to use the mailbox the receive config register gets corrupted, every now an then, with what appears to be contents of the mailbox... odd because this also occurs when not using the interrupt and just polling for messages... about 20% of the time my test runs without any problems and completes without any bus errors and all memory checks seem to work... but about 10% of the time I get the hanging problem and 70% of the time the test runs and you get a bus error.  The bus error is best because then you can read the registers with simple memory accesses and each time I see the contents of the mailbox in the config register. When the test hangs there is nothing to do but reboot the board so you loose any logging or chance of investigation.

peteasa, 2016-01-10:
I sorted out the mess in #30 and created a single simple pull request for the fixes so far for this issue.  See https://github.com/parallella/oh/pull/32.  This new pull request replaces https://github.com/parallella/oh/pull/30 that ended up as a bit of a mess because it was always work in progress!

The comments in the hdl and the commit should explain the fixes.  As far as I can tell this is complete and should stop corruption during and after applying wait.... except that somehow my software test of the fpga still results in ERX_CFG getting corrupted about 70% of the time.  Now looking else where for corruption and or using the onboard logic analyser to see exactly what is happening in the fpga when corruption occurs!

peteasa, 2016-01-24:
Just tried out the very latest and it seems like this is now working.  I have not tried out all the tests yet but so far so good!  Well done!

Closed 2016-01-24.

Thread 35 (2016-01-18):

ELINK_MAILBOXSTAT always zero

olajep, 2016-01-18:
not empty flag is never updated

aolofsson, 2016-01-18:
How do you know if the register readback is broken/times out?

On Mon, Jan 18, 2016 at 8:57 AM, Ola Jeppsson <notifications@github.com>
wrote:

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

--
----------------------------------------------------------------
Andreas Olofsson, CEO/Founder at Adapteva
Cell: +1 781 325 6688
Twitter: @adapteva
Web: adapteva.com
Linkedin: linkedin.com/in/andreasolofsson
----------------------------------------------------------------
<http://www.adapteva.com/>

olajep, 2016-01-18:
```
$ dmesg
...
Unhandled fault: external abort on non-linefetch (0x1018) at 0xb6984210
```

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

--
Phone: +46.733208642
Skype: olajep
Email: ola@adapteva.com

olajep, 2016-01-18:
... and the program gets aborted with a  bus error signal

olajep, 2016-01-18:
Might be a hint:

https://github.com/parallella/oh/blob/master/emailbox/hdl/emailbox.v#L125
```verilog
//TODO: check that high bits stay high
```

aolofsson, 2016-01-18:
My point was that if the readback is broken, then everything is broken
(including readback from mailbox).

On Mon, Jan 18, 2016 at 9:30 AM, Ola Jeppsson <notifications@github.com>
wrote:

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

--
----------------------------------------------------------------
Andreas Olofsson, CEO/Founder at Adapteva
Cell: +1 781 325 6688
Twitter: @adapteva
Web: adapteva.com
Linkedin: linkedin.com/in/andreasolofsson
----------------------------------------------------------------
<http://www.adapteva.com/>

olajep, 2016-01-18:
I can do a 64-bit write to E_MAILBOXLO from Epiphany and then read out the value from ARM via E_MAILBOXLO / E_MAILBOXHI.

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

--
Phone: +46.733208642
Skype: olajep
Email: ola@adapteva.com

aolofsson, 2016-01-18:
That seems very unlikely based on current bug...but I will keep checking.

On Mon, Jan 18, 2016 at 9:46 AM, Ola Jeppsson <notifications@github.com>
wrote:

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

--
----------------------------------------------------------------
Andreas Olofsson, CEO/Founder at Adapteva
Cell: +1 781 325 6688
Twitter: @adapteva
Web: adapteva.com
Linkedin: linkedin.com/in/andreasolofsson
----------------------------------------------------------------
<http://www.adapteva.com/>

aolofsson, 2016-01-24:
fixed

Closed 2016-01-24.

Thread 37 (2016-01-19):

mailbox: Writes dissapear

olajep, 2016-01-19:
I need to insert nops between writes to the mailbox from Epiphany.

aolofsson, 2016-01-19:
Can you try the following:
-run two scenarios, one with 0 noops inserted and one with 16 nops inserted
-for each scenario, try twoo addresses, 1.) write to mailboxlo, 2) write to
some address in memory

what do you get?

On Tue, Jan 19, 2016 at 2:27 PM, Ola Jeppsson <notifications@github.com>
wrote:

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

--
----------------------------------------------------------------
Andreas Olofsson, CEO/Founder at Adapteva
Cell: +1 781 325 6688
Twitter: @adapteva
Web: adapteva.com
Linkedin: linkedin.com/in/andreasolofsson
----------------------------------------------------------------
<http://www.adapteva.com/>

olajep, 2016-01-19:
Do you want:
1) Write to mailbox
2) Write to DRAM
3) nops / no nops

or

1) Write to mailbox
2) nops / no nops
3) Write to DRAM
4) nops / no nops

// Ola

aolofsson, 2016-01-19:
I want to see what happens with the exact same Epiphany code with the only
difference being the addressing being written to. My theory is that you
happened on a corner case that affects all writes from Epiphany to FPGA.
The reason we may not have see this is that you wrote a tight assembly
loop. Our other tests either use DMA (streaming) or slow C code loops. (in
other words our elink test regression still needs major work!) Would ftest,
matmul, etc code have the same sequence that you wrote in assembly for
mailbox test?

(a fix has tested and checked in)

On Tue, Jan 19, 2016 at 3:57 PM, Ola Jeppsson <notifications@github.com>
wrote:

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

--
----------------------------------------------------------------
Andreas Olofsson, CEO/Founder at Adapteva
Cell: +1 781 325 6688
Twitter: @adapteva
Web: adapteva.com
Linkedin: linkedin.com/in/andreasolofsson
----------------------------------------------------------------
<http://www.adapteva.com/>

olajep, 2016-01-19:
Without nops but with an added `str` to 0x8f100000 all ten writes to the mailbox arrives. The ARM side reads until  E_MAILBOXSTATUS == 0.

```asm
00000660 <_main>:
 660:   4a0b 0552       mov r2,0x5550
 664:   754b 0aa2       mov r3,0xaaaa
 668:   060b 4072       mov r16,0x730
 66c:   4aab 1552       movt r2,0x5555
 670:   754b 1aa2       movt r3,0xaaaa
 674:   01eb 5812       movt r16,0x810f
 678:   200b 0002       mov r1,0x0
 67c:   800b 2502       mov r12,0x5000
 680:   407c 0800       strd r2,[r16]
 684:   220b 18f2       movt r1,0x8f10
 688:   954b 3aa2       movt r12,0xaaaa
 68c:   845c 2000       str r12,[r1]
 690:   407c 0800       strd r2,[r16]
 694:   845c 2000       str r12,[r1]
 698:   407c 0800       strd r2,[r16]
 69c:   845c 2000       str r12,[r1]
 6a0:   407c 0800       strd r2,[r16]
 6a4:   845c 2000       str r12,[r1]
 6a8:   407c 0800       strd r2,[r16]
 6ac:   845c 2000       str r12,[r1]
 6b0:   407c 0800       strd r2,[r16]
 6b4:   845c 2000       str r12,[r1]
 6b8:   407c 0800       strd r2,[r16]
 6bc:   845c 2000       str r12,[r1]
 6c0:   407c 0800       strd r2,[r16]
 6c4:   845c 2000       str r12,[r1]
 6c8:   407c 0800       strd r2,[r16]
 6cc:   845c 2000       str r12,[r1]
 6d0:   407c 0800       strd r2,[r16]
 6d4:   845c 2000       str r12,[r1]
 6d8:   194f 0402       rts
 6dc:   0000            beq 6dc <_main+0x7c>
        ...
```

olajep, 2016-01-19:
Bug is still present in e86567241deabc8f070b61becf07be175394a980
Running through epiphany examples now ...

olajep, 2016-01-19:
(examples still work)

The magic number with e865672 is 10 cycles (no stalls AFAIK) between each `strd`

I.e., this works:
```asm
00000660 <_main>:
 660:   0a0b 0552       mov r0,0x5550
 664:   354b 0aa2       mov r1,0xaaaa
 668:   460b 0072       mov r2,0x730
 66c:   0aab 1552       movt r0,0x5555
 670:   354b 1aa2       movt r1,0xaaaa
 674:   41eb 1812       movt r2,0x810f
 678:   0874            strd r0,[r2]
 67a:   01a2            nop
 67c:   01a2            nop
 67e:   01a2            nop
 680:   01a2            nop
 682:   01a2            nop
 684:   01a2            nop
 686:   0a0b 0552       mov r0,0x5550
 68a:   354b 0aa2       mov r1,0xaaaa
 68e:   0aab 1552       movt r0,0x5555
 692:   354b 1aa2       movt r1,0xaaaa
 696:   0874            strd r0,[r2]
 698:   01a2            nop
...
```
Remove one nop and things break (only 6 entries in fifo)

olajep, 2016-01-19:
@aolofsson

Which are the right values for ELINK_RXDELAY0 and ELINK_RXDELAY1 ?

aolofsson, 2016-01-19:
The following should work:

idelay0=0xaaaaaaaa
idleya1=0x0000000a

On Tue, Jan 19, 2016 at 5:00 PM, Ola Jeppsson <notifications@github.com>
wrote:

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

--
----------------------------------------------------------------
Andreas Olofsson, CEO/Founder at Adapteva
Cell: +1 781 325 6688
Twitter: @adapteva
Web: adapteva.com
Linkedin: linkedin.com/in/andreasolofsson
----------------------------------------------------------------
<http://www.adapteva.com/>

olajep, 2016-01-19:
thanks, as expected it doesn't fix this issue but I had to test

// Ola

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

aolofsson, 2016-01-19:
Does the following break?

00000660 <_main>:
 660:   0a0b 0552       mov r0,0x5550
 664:   354b 0aa2       mov r1,0xaaaa
* 668:   460b 0072       mov r2,0x0000*
 66c:   0aab 1552       movt r0,0x5555
 670:   354b 1aa2       movt r1,0xaaaa
* 674:   41eb 1812       movt r2,0x8f10*
 678:   0874            strd r0,[r2]
 67a:   01a2            nop
 67c:   01a2            nop
 67e:   01a2            nop
 680:   01a2            nop
 682:   01a2            nop
 684:   01a2            nop
 686:   0a0b 0552       mov r0,0x5550
 68a:   354b 0aa2       mov r1,0xaaaa
 68e:   0aab 1552       movt r0,0x5555
 692:   354b 1aa2       movt r1,0xaaaa
 696:   0874            strd r0,[r2]
 698:   01a2            nop
...

On Tue, Jan 19, 2016 at 6:13 PM, Ola Jeppsson <notifications@github.com>
wrote:

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

--
----------------------------------------------------------------
Andreas Olofsson, CEO/Founder at Adapteva
Cell: +1 781 325 6688
Twitter: @adapteva
Web: adapteva.com
Linkedin: linkedin.com/in/andreasolofsson
----------------------------------------------------------------
<http://www.adapteva.com/>

olajep, 2016-01-19:
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

This works (will check in complete test tomorrow)
```asm
FUNC(etest)
.global SYM(etest)
.align 3
SYM(etest):
	mov	r20, %low(EXPECTED_0)
	movt	r20, %high(EXPECTED_0)
	mov	r21, %low(EXPECTED_1)
	movt	r21, %high(EXPECTED_1)
	mov	r22, %low(EXPECTED_2)
	movt	r22, %high(EXPECTED_2)
	mov	r23, %low(EXPECTED_3)
	movt	r23, %high(EXPECTED_3)
	mov	r24, %low(EXPECTED_4)
	movt	r24, %high(EXPECTED_4)
	mov	r25, %low(EXPECTED_5)
	movt	r25, %high(EXPECTED_5)
	mov	r26, %low(EXPECTED_6)
	movt	r26, %high(EXPECTED_6)
	mov	r27, %low(EXPECTED_7)
	movt	r27, %high(EXPECTED_7)

	mov	r30, %low(RESULT_ADDR)
	movt	r30, %high(RESULT_ADDR)

	str	r20,[r30],+1
	str	r21,[r30],+1
	str	r22,[r30],+1
	str	r23,[r30],+1
	str	r24,[r30],+1
	str	r25,[r30],+1
	str	r26,[r30],+1
	str	r27,[r30],+1

	;; repeat w/ 64-bit writes
	strd	r20,[r30],+1
	strd	r22,[r30],+1
	strd	r24,[r30],+1
	strd	r26,[r30],+1

	rts
```

olajep, 2016-01-19:
(result_addr is in DRAM)

aolofsson, 2016-01-20:
Found the bug!! NASTY!!!!!

Remembered that we have a long forgotten mode in the epiphany chip elink
(not impemented in the fpga elink) that creates bursts when you write
doubles to the same address. (F**K!)
So the writes were likely coming in as bursts.
Looks like the mailbox works fine when you write in "int"s (I tested it on
the board with consecutive)
(see "mailbox_test" in elink/sw0)

Should not be a big deal to implement burst with increment set to 0 instead
of 8, for now let's work with ints.

Please verify.

On Tue, Jan 19, 2016 at 6:38 PM, Ola Jeppsson <notifications@github.com>
wrote:

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

--
----------------------------------------------------------------
Andreas Olofsson, CEO/Founder at Adapteva
Cell: +1 781 325 6688
Twitter: @adapteva
Web: adapteva.com
Linkedin: linkedin.com/in/andreasolofsson
----------------------------------------------------------------
<http://www.adapteva.com/>

olajep, 2016-01-20:
32-bit (str) writes work with 1f42630f1cf0a17fe14e9f847669598a8734fa79

Thread 38 (2016-01-20):

mailbox: Drop writes when FIFO is full

olajep, 2016-01-20:
(read on github)

Writes to mailbox when mailbox is full is destructive. Internal write pointer overflows?
I suggest we just drop writes to the mailbox when `mailbox_full` is asserted (that signal seems to work). Add a sticky (write to clear) overflow bit to `E_MAILBOXSTATUS` to detect. Might also need a `mailbox_half_full` interrupt. Driver can maintain a larger FIFO in RAM (if we need it).

FIFO depth = 32

Ignore 'hi'

32 x `str` = 32 entries can be read back from mailbox until `status.not_empty == 0`
As expected.
```
status: 0x00000003 lo: 00000000 hi: 0x00000660
status: 0x00000001 lo: 0x00000001 hi: 0x810f0730
status: 0x00000001 lo: 0x00000002 hi: 0x00007ff0
status: 0x00000001 lo: 0x00000003 hi: 0x00000003
...
status: 0x00000001 lo: 0x0000001e hi: 0x5555001e
status: 0x00000001 lo: 0x0000001f hi: 0x810f0730
```

33 x `str` = 33 entries read back from mailbox until `status.not_empty == 0`
As can be seen first entry (`lo: 0x00000000`) is overwritten by the last write. Also mailbox_full bit in status is set **after** first readout.
```
status: 0x00000001 lo: 0x00000020 hi: 0x810f0730
status: 0x00000003 lo: 0x00000001 hi: 0xffffffe0
status: 0x00000001 lo: 0x00000002 hi: 0x00000002
status: 0x00000001 lo: 0x00000003 hi: 0x00007ff0
status: 0x00000001 lo: 0x00000004 hi: 0x00000019
status: 0x00000001 lo: 0x00000005 hi: 0x00000005
status: 0x00000001 lo: 0x00000006 hi: 0x00000007
status: 0x00000001 lo: 0x00000007 hi: 0x00000007
status: 0x00000001 lo: 0x00000008 hi: 0x810f0730
status: 0x00000001 lo: 0x00000009 hi: 0xffffffe8
status: 0x00000001 lo: 0x0000000a hi: 0x0000000a
status: 0x00000001 lo: 0x0000000b hi: 0x00007ff0
status: 0x00000001 lo: 0x0000000c hi: 0x00000005
status: 0x00000001 lo: 0x0000000d hi: 0x0000000d
status: 0x00000001 lo: 0x0000000e hi: 0x0000000f
status: 0x00000001 lo: 0x0000000f hi: 0x0000000f
status: 0x00000001 lo: 0x00000010 hi: 0x810f0730
status: 0x00000001 lo: 0x00000011 hi: 0xfffffff0
status: 0x00000001 lo: 0x00000012 hi: 0x00000012
status: 0x00000001 lo: 0x00000013 hi: 0x00007ff0
status: 0x00000001 lo: 0x00000014 hi: 0x0000000d
status: 0x00000001 lo: 0x00000015 hi: 0x00000015
status: 0x00000001 lo: 0x00000016 hi: 0x00000017
status: 0x00000001 lo: 0x00000017 hi: 0x00000017
status: 0x00000001 lo: 0x00000018 hi: 0x810f0730
status: 0x00000001 lo: 0x00000019 hi: 0xfffffff8
status: 0x00000001 lo: 0x0000001a hi: 0x0000001a
status: 0x00000001 lo: 0x0000001b hi: 0x00007ff0
status: 0x00000001 lo: 0x0000001c hi: 0x00000015
status: 0x00000001 lo: 0x0000001d hi: 0x0000001d
status: 0x00000001 lo: 0x0000001e hi: 0x0000001f
status: 0x00000001 lo: 0x0000001f hi: 0x0000001f
status: 0x00000001 lo: 0x00000020 hi: 0x810f0730
```

63 x `str` = 63 entries read back from mailbox until `status.not_empty == 0`
First 31 entries (0x0-0x1e) is overwritten by the last 31 writes (0x20-0x3e)
```
status: 0x00000001 lo: 0x00000020 hi: 0x00000020
status: 0x00000001 lo: 0x00000021 hi: 0x00007ff0
status: 0x00000001 lo: 0x00000022 hi: 0x00000022
status: 0x00000001 lo: 0x00000023 hi: 0x0000001a
status: 0x00000001 lo: 0x00000024 hi: 0x00000024
status: 0x00000001 lo: 0x00000025 hi: 0x0000001c
status: 0x00000001 lo: 0x00000026 hi: 0x00000026
status: 0x00000001 lo: 0x00000027 hi: 0x0000001e
status: 0x00000001 lo: 0x00000028 hi: 0x00000028
status: 0x00000001 lo: 0x00000029 hi: 0x0000002a
status: 0x00000001 lo: 0x0000002a hi: 0x0000002a
status: 0x00000001 lo: 0x0000002b hi: 0x00007ff0
status: 0x00000001 lo: 0x0000002c hi: 0x0000002c
status: 0x00000001 lo: 0x0000002d hi: 0x00000024
status: 0x00000001 lo: 0x0000002e hi: 0x0000002e
status: 0x00000001 lo: 0x0000002f hi: 0x00000026
status: 0x00000001 lo: 0x00000030 hi: 0x00000030
status: 0x00000001 lo: 0x00000031 hi: 0x00000028
status: 0x00000001 lo: 0x00000032 hi: 0x00000032
status: 0x00000001 lo: 0x00000033 hi: 0x00000034
status: 0x00000001 lo: 0x00000034 hi: 0x00000034
status: 0x00000001 lo: 0x00000035 hi: 0x00007ff0
status: 0x00000001 lo: 0x00000036 hi: 0x00000036
status: 0x00000001 lo: 0x00000037 hi: 0x0000002e
status: 0x00000001 lo: 0x00000038 hi: 0x00000038
status: 0x00000001 lo: 0x00000039 hi: 0x00000030
status: 0x00000001 lo: 0x0000003a hi: 0x0000003a
status: 0x00000001 lo: 0x0000003b hi: 0x00000032
status: 0x00000001 lo: 0x0000003c hi: 0x0000003c
status: 0x00000001 lo: 0x0000003d hi: 0x0000003e
status: 0x00000001 lo: 0x0000003e hi: 0x0000003e
status: 0x00000003 lo: 0x0000001f hi: 0x00000020
status: 0x00000001 lo: 0x00000020 hi: 0x00000020
status: 0x00000001 lo: 0x00000021 hi: 0x00007ff0
status: 0x00000001 lo: 0x00000022 hi: 0x00000022
status: 0x00000001 lo: 0x00000023 hi: 0x0000001a
status: 0x00000001 lo: 0x00000024 hi: 0x00000024
status: 0x00000001 lo: 0x00000025 hi: 0x0000001c
status: 0x00000001 lo: 0x00000026 hi: 0x00000026
status: 0x00000001 lo: 0x00000027 hi: 0x0000001e
status: 0x00000001 lo: 0x00000028 hi: 0x00000028
status: 0x00000001 lo: 0x00000029 hi: 0x0000002a
status: 0x00000001 lo: 0x0000002a hi: 0x0000002a
status: 0x00000001 lo: 0x0000002b hi: 0x00007ff0
status: 0x00000001 lo: 0x0000002c hi: 0x0000002c
status: 0x00000001 lo: 0x0000002d hi: 0x00000024
status: 0x00000001 lo: 0x0000002e hi: 0x0000002e
status: 0x00000001 lo: 0x0000002f hi: 0x00000026
status: 0x00000001 lo: 0x00000030 hi: 0x00000030
status: 0x00000001 lo: 0x00000031 hi: 0x00000028
status: 0x00000001 lo: 0x00000032 hi: 0x00000032
status: 0x00000001 lo: 0x00000033 hi: 0x00000034
status: 0x00000001 lo: 0x00000034 hi: 0x00000034
status: 0x00000001 lo: 0x00000035 hi: 0x00007ff0
status: 0x00000001 lo: 0x00000036 hi: 0x00000036
status: 0x00000001 lo: 0x00000037 hi: 0x0000002e
status: 0x00000001 lo: 0x00000038 hi: 0x00000038
status: 0x00000001 lo: 0x00000039 hi: 0x00000030
status: 0x00000001 lo: 0x0000003a hi: 0x0000003a
status: 0x00000001 lo: 0x0000003b hi: 0x00000032
status: 0x00000001 lo: 0x0000003c hi: 0x0000003c
status: 0x00000001 lo: 0x0000003d hi: 0x0000003e
status: 0x00000001 lo: 0x0000003e hi: 0x0000003e
```

64 x `str` = 0 entries read back from mailbox until `status.not_empty == 0`
96 x `str` = 32 entries (0x40-0x5f) read back from mailbox until `status.not_empty == 0`
...

aolofsson, 2016-01-20:
Yes, will add a safeguard on full and agree in regards to making prog_full another possible interrupt_source, but this still needs to be solved in HW by some agreement/API at the end of the day.
(unless I am missing something).

Initial thought was to have one entry per core and then have dual sided communication whereby the host would send an ACK (through e_write) back to each core it received a message from. The core ID would be embedded in the message received by the host. The core would not be allowed to send another message until it has received an ACK from host that message has received.

So yes, having fifo full stopping writes is nice, but it doesn't solve the problem.

If we add pushback on fifo full, then yes we could keep pushing data, but if not properly used, this would flood the network quickly....will implement that now.

aolofsson, 2016-01-24:
implemented

Closed 2016-01-24.

Thread 45 (2016-01-30):

fpga for 7010 device may need reworking

peteasa, 2016-01-30:
ERROR: [Place 30-640] Place Check : This design requires more MMCME2_ADV cells than are available in the target device. This design requires 3 of such cell types but only 2 compatible sites are available in the target device. Please analyze your synthesis results and constraints to ensure the design is mapped to Xilinx primitives as expected. If so, please consider targeting a larger device.

The above error was seen when attempting to build the hdmi version of the fpga for the xc7z010clg400-1 part.  Note I have added in the ADI hdmi modules so this error is unlikely to be seen when building a headless version.

peteasa, 2016-01-31:
Just to let you know I have just completed a quick test, using hdmi to display a good image on the screen, running the speaker-test to listen to a rather high pitched left / right speaker test PLUS running my interrupt driven emailbox / memory test...

and it all works (kind of).. the corruption on the sound is no doubt because I am using the wrong reference clock speed.  I will experiment a bit but it looks good on a xc7z020clg400-1 part and I have every hope that the xc7z010clg400-1 will also work.

The following output shows the interrupts  f8003000.ps7-dma is I guess sound, 80000000.esaxi is the elink mailbox, hdmi interrupt although wired in is not in the device tree and seems not be be used by the ADI drivers at present and I am not sure why the video dma interrupt is not showing  count but then perhaps I have got something else not quite right or perhaps it is only used with video rather than still images.. anyway a bit of a success thanks to your hard work!

<pre>cat /proc/interrupts
           CPU0       CPU1
 16:          0          0       GIC  27  gt
 17:      13249       8061       GIC  29  twd
 18:          0          0       GIC  43  ttc_clockevent
 22:          0          0       GIC  35  f800c000.ps7-ocmc
 25:          0          0       GIC  45  f8003000.ps7-dma
 26:         37          0       GIC  46  f8003000.ps7-dma
 27:          0          0       GIC  47  f8003000.ps7-dma
 28:          0          0       GIC  48  f8003000.ps7-dma
 29:          0          0       GIC  49  f8003000.ps7-dma
 30:          0          0       GIC  72  f8003000.ps7-dma
 31:          0          0       GIC  73  f8003000.ps7-dma
 32:          0          0       GIC  74  f8003000.ps7-dma
 33:          0          0       GIC  75  f8003000.ps7-dma
 34:          0          0       GIC  40  f8007000.ps7-dev-cfg
 35:      29942          0       GIC  54  eth0
160:       7776          0       GIC  79  mmc0
167:        989          0       GIC  82  xuartps
168:        445          0       GIC  57  cdns-i2c
172:        167          0       GIC  53  e0002000.ps7-usb
174:         43          0       GIC  39  f8007100.ps7-xadc
175:          0          0       GIC  91  xilinx-dma-controller
176:        100          0       GIC  89  80000000.esaxi
IPI1:          0          0  Timer broadcast interrupts
IPI2:       3661       9596  Rescheduling interrupts
IPI3:          0          0  Function call interrupts
IPI4:         24         30  Single function call interrupts
IPI5:          0          0  CPU stop interrupts
IPI6:          0          0  IRQ work interrupts
IPI7:          0          0  completion interrupts
Err:          0
</pre>

aolofsson, 2016-02-01:
Very cool! I am looking into clocking to see if we can use 1 less pll.
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

peteasa, 2016-02-05:
Perhaps scarce resource should be outside the main block so that a user may use other outputs from the same clocking source?

peteasa, 2016-02-07:
Sound on 7010 - Snookered!  I dont want to change the boot loader so I am stuck with the FSBL configured clock speeds.  Never mind.  At least the 7010 board hdmi has a chance of working now that the oh fpga builds for that.

Thread 47 (2016-02-02):

RX: Dynamic mapping issues

olajep, 2016-02-02:
With this commit:
https://github.com/parallella/oh/commit/5dc9375ebb5f41a890e10d23dbe25ec4ccc6c85e

### Setup

```
ELINK_RXCFG = { .mmu_enable = 1, .remap_mode = 2} = 0xA
```

Memory mappings written to :ELINK_RXMMU table
```

ERAM [0x8e000000-90000000] --> [0x3e000000-0x40000000]
addr=0x810ec700 val=0x000003e0
addr=0x810ec704 val=0x00000000
addr=0x810ec708 val=0x000003e1
addr=0x810ec70c val=0x00000000
addr=0x810ec710 val=0x000003e2
addr=0x810ec714 val=0x00000000
...
addr=0x810ec7f0 val=0x000003fe
addr=0x810ec7f4 val=0x00000000
addr=0x810ec7f8 val=0x000003ff
addr=0x810ec7fc val=0x00000000

FPGA ELINK (so Epiphany can access mailbox regs)
addr=0x810ec080 val=0x00000810
addr=0x810ec084 val=0x00000000
```

### What happens

Writes from Epiphany to ERAM does not work.
Reads from Epiphany to ERAM returns something (not random, different value from different addresses), but the wrong data.
Writes to ELINK_MAILBOXLO does work, **iff** the FPGA elink is present in the RX MMU table. In fact if I change the FPGA elink entry in the MMU table to an ERAM address then writes from Epiphany to ELINK_MAILBOXLO.is written to ERAM
NB: Entries in ELINK_RXMMU not cleared on reset via ELINK_RESET (which is fine, can do that in S/W)

olajep, 2016-02-03:
Ok found it, guess I should read the RTFM first!
https://github.com/parallella/oh/blob/master/elink/hdl/erx_remap.v#L55-L58
```verilog
   //more complex compresssed map
   assign dynamic_remap[31:0] = addr_in[31:0]    //input
			     - (colid << 20)     //subtracing elink (start at 0)
			     + remap_base[31:0]  //adding back base
                             - (addr_in[31:26]<<$clog2(colid));
```
... and then this is fed into erx_mmu.

But please explain what's the idea here, don't get it?

aolofsson, 2016-02-03:
What does this have to do with the MMU?

On Tue, Feb 2, 2016 at 7:08 PM, Ola Jeppsson <notifications@github.com>
wrote:

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

--
----------------------------------------------------------------
Andreas Olofsson, CEO/Founder at Adapteva
Cell: +1 781 325 6688
Twitter: @adapteva
Web: adapteva.com
Linkedin: linkedin.com/in/andreasolofsson
----------------------------------------------------------------
<http://www.adapteva.com/>

olajep, 2016-02-03:
emesh_remap_packet is input to erx_mmu
https://github.com/parallella/oh/blob/master/elink/hdl/erx_core.v#L163

olajep, 2016-02-03:
Wrong:
ELINK_RXCFG = { .mmu_enable = 1, .remap_mode = 2} = 0xA

Right
ELINK_RXCFG = { .mmu_enable = 1, .remap_mode = 0} = 0X2

Ok, got it

olajep, 2016-02-04:
Seems to work :) . Switched to mmu mapping on my driver devel branch.

Closed 2016-02-04.

Thread 48 (2016-02-12):

txmmu/rxmmu: Need valid bit in page table entries

olajep, 2016-02-12:
After I switched RX path to MMU from static remap, I started to see sporadic external fetch abort errors when running the mailbox test. (The only test that requires reading from the FPGA elink regs)
I think one error source was a flaky VDD_DSP so I took a step back and left the regulator always on, but there were still issues.
I've been all over the place but in the end I think it boils down to this one **stupid** line in the mailbox example. DOH!
Running exhaust test now, knock on wood.

```c
e_open(&dev, 0, 0, platform.rows, platform.cols);
e_load_group("emain.elf", &dev, 0, 0, 1, 1, E_FALSE);
e_start_group(&dev);
```

```c
e_open(&dev, 0, 0, 1, 1);
e_load_group("emain.elf", &dev, 0, 0, 1, 1, E_FALSE);
e_start_group(&dev);
```

So I loaded the program to core (0,0), but started all cores. Random SRAM data == random instructions == random off-chip access to an invalid address that causes the AXI slave to time out.
This wasn't visible with static remapping since all accesses was forced to [0x8e000000-0x90000000] by the mask.

At any rate, an invalid off-chip access from Epiphany should never bring down the entire system. It's an easy programming error, even I can do it ;)
("External Fetch Abort" in kernel when locks are held requires reboot)

// Ola

Thread 66 (2016-04-15):

master branch parallella bitstreams broken

olajep, 2016-04-15:
Tested with this commit:
53dea826bc6813ee5e2c400dee93a012f03100c0

At least Epiphany DMA read from ERAM seems broken. Seems to get stuck and then if ARM reads from Epiphany the timeout circuitry kicks in and kills the program with an external abort exception.

Thread 84 (2016-05-24):

spi: master doesn't transfer 2 MSB in data byte

olajep, 2016-05-24:
Test case:
fclk0 = 25 MHz clkdiv=254 sclk = 100 kHz
1. Master writes 0xff to SPI_USER0
2. Master reads data from SPI_USER0

As seen in the waveform capture master does not transfer the two most significant bits in the data byte.
This does not seem to happen in simulation.

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

[waveform.vcd.txt](https://github.com/parallella/oh/files/280196/waveform.vcd.txt)

olajep, 2016-05-24:
It also drops the 2 MSB in the command byte.

Thread 103 (2017-04-28):

Error when building accelerator example

KukyNekoi, 2017-04-28:
Vivado version: 2015.4
Branch used: stable (the error persists on master)
OS: Centos 7.2

Details: When running the file `oh/accelerator/fpga/build.sh` a fatal error occurs whenthe command `vivado -mode batch -source run.tcl` is executed. As far as I know, `system_i` causes the error since vivado assumes that it is a blackbox.

I'm new to FPGAs and to Vivado SDK so I don't know what to do to reference that source and get rid of the error.

The error:
```
*** Running vivado
    with args -log system_wrapper.vdi -applog -m64 -messageDb vivado.pb -mode batch -source system_wrapper.tcl -notrace

****** Vivado v2015.4 (64-bit)
  **** SW Build 1412921 on Wed Nov 18 09:44:32 MST 2015
  **** IP Build 1412160 on Tue Nov 17 13:47:24 MST 2015
    ** Copyright 1986-2015 Xilinx, Inc. All Rights Reserved.

source system_wrapper.tcl -notrace
Design is defaulting to srcset: sources_1
Design is defaulting to constrset: constrs_1
INFO: [Project 1-479] Netlist was created with Vivado 2015.4
INFO: [Device 21-403] Loading part xc7z020clg400-1
INFO: [Project 1-570] Preparing netlist for logic optimization
INFO: [Opt 31-138] Pushed 0 inverter(s) to 0 load pin(s).
CRITICAL WARNING: [Project 1-486] Could not resolve non-primitive black box cell 'system' instantiated as 'system_i' [/home/kuky_nekoi/Desktop/oh/accelerator/fpga/system.srcs/sources_1/bd/system/hdl/system_wrapper.v:16]
INFO: [Project 1-111] Unisim Transformation Summary:
No Unisim elements were transformed.

link_design: Time (s): cpu = 00:00:06 ; elapsed = 00:00:06 . Memory (MB): peak = 1215.844 ; gain = 214.250 ; free physical = 675 ; free virtual = 12216
Command: opt_design
Attempting to get a license for feature 'Implementation' and/or device 'xc7z020'
INFO: [Common 17-349] Got license for feature 'Implementation' and/or device 'xc7z020'
Running DRC as a precondition to command opt_design

Starting DRC Task
INFO: [DRC 23-27] Running DRC with 2 threads
ERROR: [DRC 23-20] Rule violation (INBB-3) Black Box Instances - Cell 'system_i' of type 'system_i/system' has undefined contents and is considered a black box.  The contents of this cell must be defined for opt_design to complete successfully.
INFO: [Project 1-461] DRC finished with 1 Errors
INFO: [Project 1-462] Please refer to the DRC report (report_drc) for more information.
ERROR: [Vivado_Tcl 4-78] Error(s) found during DRC. Opt_design not run.

Time (s): cpu = 00:00:00.08 ; elapsed = 00:00:00.09 . Memory (MB): peak = 1245.855 ; gain = 22.008 ; free physical = 669 ; free virtual = 12210
INFO: [Common 17-83] Releasing license: Implementation
10 Infos, 0 Warnings, 1 Critical Warnings and 2 Errors encountered.
opt_design failed
ERROR: [Common 17-39] 'opt_design' failed due to earlier errors.

INFO: [Common 17-206] Exiting Vivado at Mon May  8 17:47:04 2017...
[Mon May  8 17:47:08 2017] impl_1 finished
wait_on_run: Time (s): cpu = 00:00:00.18 ; elapsed = 00:00:22 . Memory (MB): peak = 1101.141 ; gain = 0.000 ; free physical = 1032 ; free virtual = 12572
## launch_runs impl_1 -to_step write_bitstream
[Mon May  8 17:47:08 2017] Launched impl_1...
Run output will be captured here: /home/kuky_nekoi/Desktop/oh/accelerator/fpga/system.runs/impl_1/runme.log
## wait_on_run impl_1
[Mon May  8 17:47:08 2017] Waiting for impl_1 to finish...
[Mon May  8 17:47:08 2017] impl_1 finished
INFO: [Common 17-206] Exiting Vivado at Mon May  8 17:47:08 2017...
[ERROR]  : Bitstream parsing error !!!           Unsupported BIT file
```

KukyNekoi, 2017-04-30:
Forget it, I managed to make it work by doing the following

1. Cloning the stable branch.
2. Find all references to vivado version and updating them to the version that I was using. (you can use `find . | grep system_bd.tcl` to find such files and then change the line `set scripts_vivado_version 2015.2` accordingly. This is needed to create the nets (idk why).
3. Use the instructions provided here https://github.com/parallella/oh/tree/stable/accelerator (note that the `./run.sh tests/hello.emf` file is actually `./run.sh tests/hello_world.emf`

I didn't managed to make the master version to work. 😢

Closed 2017-04-30.
