aolofsson/oh/elink/dv/elink_e16_model.v

`define CFG_FAKECLK   1      /*stupid verilator doesn't get clock gating*/
`define CFG_MDW       32     /*Width of mesh network*/
`define CFG_DW        32     /*Width of datapath*/
`define CFG_AW        32     /*Width of address space*/
`define CFG_LW        8      /*Link port width*/
`define CFG_NW        13     /*Number of bytes in the transmission*/


module e16_arbiter_priority(/*AUTOARG*/
   // Outputs
   grant, arb_wait,
   // Inputs
   clk, clk_en, reset, hold, request
   );
   
   parameter ARW=99;
   
   input            clk;
   input            clk_en;
   input            reset;

   input            hold;      
   input  [ARW-1:0] request;

   output [ARW-1:0] grant;
   output [ARW-1:0] arb_wait;


   //wires
   wire [ARW-1:0] grant_mask;
   wire [ARW-1:0] request_mask;
   
   //regs
   reg [ARW-1:0]  grant_hold;

   //hold circuit
   always @ (posedge clk or posedge reset)
     if(reset)
       grant_hold[ARW-1:0] <= {(ARW){1'b0}};
     else if(clk_en)       
       grant_hold[ARW-1:0] <= grant[ARW-1:0] & {(ARW){hold}};

   //request blocking based on held previous requests
   genvar i;
   generate              
      for(i=0;i<ARW-1;i=i+1) begin : gen_block
         assign request_mask[i]=request[i] & ~(|grant_hold[ARW-1:i+1]);	 
      end
      assign request_mask[ARW-1]=request[ARW-1];//awlays on, loses on priority 
   endgenerate
   
   genvar j;
   assign grant_mask[0]   = 1'b0;   
   generate for (j=ARW-1; j>=1; j=j-1) begin : gen_arbiter     
      assign grant_mask[j] = |request_mask[j-1:0];
   end
   endgenerate
        
   //grant circuit
   assign grant[ARW-1:0] = request_mask[ARW-1:0] & ~grant_mask[ARW-1:0];

   //wait circuit  
   assign arb_wait[ARW-1:0] = request[ARW-1:0] & ({(ARW){hold}} | ~grant[ARW-1:0]);


   //makes sure we hold request one cycle after wait is gone!!!
   // synthesis translate_off
   always @*
     if((|(grant_hold[ARW-1:0] & ~request[ARW-1:0])) & ~reset  & $time> 0)
       begin
	  $display("ERROR>>Request not held steady in cell %m at time %0d", $time);
       end
   // synthesis translate_on
   
endmodule // arbiter_priority

   
     
module e16_arbiter_roundrobin(/*AUTOARG*/
   // Outputs
   grants,
   // Inputs
   clk, clk_en, reset, en_rotate, requests
   );

   /************************************************************/
   /*PARAMETERS                                                */
   /************************************************************/   
   parameter ARW  = 5;


   /************************************************************/
   /*BASIC INTERFACE                                           */
   /****I*******************************************************/
   input            clk;
   input            clk_en;  //2nd level manual clock gater   
   input            reset;

   /************************************************************/
   /*ARBITRATION INTERFACE                                     */
   /****I*******************************************************/
   input            en_rotate;//enable mask rotation, makes arbiter more flexible
                              //in mesh there should be a way to control freq of rotation 

   input  [ARW-1:0] requests; 
   output [ARW-1:0] grants;   

   //loop variable
   integer m;    

   //Masks
   reg  [ARW-1:0]   request_mask; //rotating mask


   //Wires
   reg [2*ARW-1:0]  grants_rotate_buffer;   
   reg [ARW-1:0]    grants;         //output grants      
   wire [ARW-1:0]   shifted_requests[ARW-1:0];
   wire [ARW-1:0]   shifted_grants[ARW-1:0];
   wire [2*ARW-1:0] requests_rotate_buffer;
   
   /********************************************************************/
   /*Rotating Mask Pointer On Every Clock Cycle                        */
   /********************************************************************/
   //request vector[7:0]-->regular
   //hold vector[7:0]   -->sets the priority to the request when it wins
   //                      there can be multiple bits set
   //                      the only one active is the one where the
   //                      mask is currently located.
   //                      en_rotate=~(hold_vec[7:0] & requeste_mask[7:0])

   //every request should also be able to send a "start/stop" signal
   //instead of having an en_rotate signal, we have
   //if then en-rotate signal is low
  
   always @ ( posedge clk or posedge reset)
     if(reset)
       request_mask[ARW-1:0] <= {{(ARW-1){1'b0}},1'b1};   
     else if(clk_en)
       if(en_rotate)
	 request_mask[ARW-1:0] <= {request_mask[ARW-2:0],request_mask[ARW-1]};
   
   /********************************************************************/
   /*Creating Shifted Request Vectors                                  */
   /********************************************************************/
   assign requests_rotate_buffer[2*ARW-1:0]={requests[ARW-1:0],requests[ARW-1:0]};

   genvar i;
   generate
      for (i=0;i<ARW;i=i+1) begin: gen_requests	
	 assign shifted_requests[i]=requests_rotate_buffer[ARW-1+i:i];      
      end
   endgenerate

   /********************************************************************/
   /*Priority Encoders For Each Vector                                 */
   /********************************************************************/
   //Priority Encoders For Each Vector   
   genvar k;   
   generate
      for (k=0;k<ARW;k=k+1) begin: gen_arbiter
	   e16_arbiter_priority #(.ARW(ARW)) simple_arbiter(
                                                        .clk       (clk),
					                .clk_en    (clk_en),
					                .reset     (reset),                                     
					                .hold      (1'b0),				 
					                .request   (shifted_requests[k]),                         
                                                        .arb_wait  (),
					                .grant     (shifted_grants[k])
					                );      
      end
   endgenerate   

   /********************************************************************/
   /*One Hot Mux                                                       */
   /********************************************************************/
   //Note that grants have to be rotate back to their right positiona again.
   always @*
     begin	
	grants[ARW-1:0]      = {(ARW){1'b0}};
	for(m=0;m<ARW;m=m+1)
	  begin
	     grants_rotate_buffer[2*ARW-1:0]={shifted_grants[m],shifted_grants[m]};	
	     grants[ARW-1:0]                =grants[ARW-1:0] |
	                                     ({(ARW){request_mask[m]}} & 
					      grants_rotate_buffer[2*ARW-1-m-:ARW]
					      );
	  end
     end
     
   /********************************************************************/
   /*Checkers                                                          */
   /********************************************************************/
/*
   
   // synthesis translate_off
   always @*     
     begin
	if((|(grants[ARW-1:0]&~requests[ARW-1:0])) & $time>0)
	  $display("ERROR>>Grant granted with out request in cell %m at time %0d",$time);
	if((~(|grants[ARW-1:0]) & (|requests[ARW-1:0])) & $time>0)
	  $display("ERROR>>Zero granted when there was a request in cell %m at time %0d",$time);	
     end   
   // synthesis translate_on
*/
   	    
endmodule // arbiter_roundrobin
// ###############################################################
// # FUNCTION: Synchronous clock divider that divides by integer
// #  NOTE:     Combinatorial output becomes new clock
// ############################################################### 

module e16_clock_divider(/*AUTOARG*/
   // Outputs
   clk_out, clk_out90,
   // Inputs
   clk_in, reset, div_cfg
   );


   input       clk_in;    // Input clock
   input       reset;
   input [3:0] div_cfg;   // Divide factor
   
   output      clk_out;   // Divided clock phase aligned with clk_in 
   output      clk_out90; // Divided clock with 90deg phase shift with clk_out


   reg        clk_out_reg;
   //reg        clk_out90_reg;
   //reg        clk90_div2_reg;
   reg [5:0]  counter;   
   reg [5:0]  div_cfg_dec;

   wire div2_sel;   
   wire posedge_match;
   wire negedge_match;  
   wire posedge90_match;
   wire negedge90_match; 
    
   wire clk_out90_div2;
   wire clk_out90_div4;
   wire clk_out90_div2_in;
   wire clk_out90_div4_in;
   // ###################
   // # Decode div_cfg
   // ###################

   always @ (div_cfg[3:0])
     begin
	casez (div_cfg[3:0])
	  4'b0000 : div_cfg_dec[5:0] = 6'b000010;  // Divide by 2
	  4'b0001 : div_cfg_dec[5:0] = 6'b000100;  // Divide by 4
	  4'b0010 : div_cfg_dec[5:0] = 6'b001000;  // Divide by 8
	  4'b0011 : div_cfg_dec[5:0] = 6'b010000;  // Divide by 16
	  4'b01?? : div_cfg_dec[5:0] = 6'b100000;  // A lof of different ratios
          4'b1??? : div_cfg_dec[5:0] = 6'b100000;  // Divide by 32
	  default : div_cfg_dec[5:0] = 6'b000000;
	endcase // casez (div_cfg[3:0])
     end // always @ (div_cfg[3:0])

   assign div2_sel = div_cfg[3:0]==4'b0;
    

   //Counter For Generating Toggling Edges
   //always @ (posedge clk_in or posedge reset)
   //if(reset)
   //counter[5:0] <= 6'b000001;// Reset value

   always @ (posedge clk_in or posedge reset)
     if (reset)
       counter[5:0] <= 6'b000001;   
     else if(posedge_match)
       counter[5:0] <= 6'b000001;// Self resetting
     else
       counter[5:0] <= (counter[5:0]+6'b000001);
   
   assign posedge_match    = (counter[5:0]==div_cfg_dec[5:0]);
   assign negedge_match    = (counter[5:0]=={1'b0,div_cfg_dec[5:1]}); 
   assign posedge90_match  = (counter[5:0]==({2'b00,div_cfg_dec[5:2]}));
   assign negedge90_match  = (counter[5:0]==({2'b00,div_cfg_dec[5:2]}+{1'b0,div_cfg_dec[5:1]})); 
			      
   //Divided clock
   //always @ (posedge clk_in or posedge reset)
   //if(reset)
   //clk_out_reg <= 1'b0;   
   always @ (posedge clk_in)
     if(posedge_match)
       clk_out_reg <= 1'b1;
     else if(negedge_match)
       clk_out_reg <= 1'b0;
  
   assign clk_out    = clk_out_reg;

   /**********************************************************************/
   /*Divide by 2 Clock
   /**********************************************************************/
   //always @ (posedge clk_in or posedge reset)     
   //if(reset)
   //clk_out90_reg <= 1'b0;   
   //always @ (posedge clk_in)     
   //  if(posedge90_match)
   //    clk_out90_reg <= 1'b1;
   //  else if(negedge90_match)
   //    clk_out90_reg <= 1'b0;

   assign clk_out90_div4_in = posedge90_match ? 1'b1 :
                              negedge90_match ? 1'b0 :
			                        clk_out90_div4;

   DFFQX4A12TR clk90_flop     (.CK(clk_in), 
			       .D(clk_out90_div4_in), 
			       .Q(clk_out90_div4) 
			       );
   
   //always @ (negedge clk_in)
   //  if(negedge_match)
   //    clk90_div2_reg <= 1'b1;
   //  else if(posedge_match)
   //    clk90_div2_reg <= 1'b0;

   assign clk_out90_div2_in = negedge_match ? 1'b1 :
                              posedge_match ? 1'b0 :
			                      clk_out90_div2;
   
  
   
   DFFNQX3A12TR clk90_div2_flop (.CKN(clk_in), 
	 			 .D(clk_out90_div2_in), 
				 .Q(clk_out90_div2) 
				);
   

   //assign clk_out90  = div2_sel ? clk90_div2_reg : clk_out90_reg;
   MX2X4A12TR clk90_mux2      (.A(clk_out90_div4), 
			       .B(clk_out90_div2), 
			       .S0(div2_sel),
			       .Y(clk_out90)
			       );


   
   
endmodule // clock_divider



     
module e16_mesh_interface(/*AUTOARG*/
   // Outputs
   wait_out, access_out, write_out, datamode_out, ctrlmode_out,
   data_out, dstaddr_out, srcaddr_out, access_reg, write_reg,
   datamode_reg, ctrlmode_reg, data_reg, dstaddr_reg, srcaddr_reg,
   // Inputs
   clk, clk_en, reset, wait_in, access_in, write_in, datamode_in,
   ctrlmode_in, data_in, dstaddr_in, srcaddr_in, wait_int, access,
   write, datamode, ctrlmode, data, dstaddr, srcaddr
   );

   parameter DW = `CFG_DW;
   parameter AW = `CFG_AW;
   
   //###########
   //# INPUTS
   //###########
   input            clk;
   input            clk_en;  //2nd level manual clock gater   
   input 	    reset;  

   //# from the mesh
   input 	    wait_in;
   input 	    access_in;
   input 	    write_in;
   input [1:0]      datamode_in;
   input [3:0]      ctrlmode_in;   		    
   input [DW-1:0]   data_in;
   input [AW-1:0]   dstaddr_in;
   input [AW-1:0]   srcaddr_in;   

   //# from the internal control
   input 	    wait_int;
   input 	    access;
   input 	    write;
   input [1:0]      datamode;
   input [3:0]      ctrlmode;   		    
   input [DW-1:0]   data;
   input [AW-1:0]   dstaddr;
   input [AW-1:0]   srcaddr;   

   //###########
   //# OUTPUTS
   //###########

   //# to the mesh
   output 	    wait_out;
   output 	    access_out;
   output 	    write_out;
   output [1:0]     datamode_out;
   output [3:0]     ctrlmode_out;   		    
   output [DW-1:0]  data_out;
   output [AW-1:0]  dstaddr_out;
   output [AW-1:0]  srcaddr_out;  

   //# to the internal control
   output 	    access_reg;
   output 	    write_reg;
   output [1:0]     datamode_reg;
   output [3:0]     ctrlmode_reg;   		    
   output [DW-1:0]  data_reg;
   output [AW-1:0]  dstaddr_reg;
   output [AW-1:0]  srcaddr_reg;  

   /*AUTOINPUT*/
   /*AUTOWIRE*/

   //#########
   //# REGS
   //#########
   reg          wait_out;
   reg 		access_out;
   reg 		write_out;
   reg [1:0] 	datamode_out;
   reg [3:0] 	ctrlmode_out;   		    
   reg [DW-1:0] data_out;
   reg [AW-1:0] dstaddr_out;
   reg [AW-1:0] srcaddr_out;  

   reg 		access_reg;
   reg 		write_reg;
   reg [1:0] 	datamode_reg;
   reg [3:0] 	ctrlmode_reg;   		    
   reg [DW-1:0] data_reg;
   reg [AW-1:0] dstaddr_reg;
   reg [AW-1:0] srcaddr_reg;  

   //#########
   //# WIRES
   //#########

   //##########################
   //# mesh input busses
   //##########################

   always @ (posedge clk or posedge reset)
     if(reset)
       access_reg <= 1'b0;
     else if(clk_en)
       if(~wait_int)
	 access_reg <= access_in;
      
   always @ (posedge clk)
     if(clk_en)
       if(~wait_int & access_in)
	 begin
	    write_reg           <= write_in;
	    datamode_reg[1:0]   <= datamode_in[1:0];
	    ctrlmode_reg[3:0]   <= ctrlmode_in[3:0];
	    data_reg[DW-1:0]    <= data_in[DW-1:0];
	    dstaddr_reg[AW-1:0] <= dstaddr_in[AW-1:0];
	    srcaddr_reg[AW-1:0] <= srcaddr_in[AW-1:0];
	 end

   //##########################
   //# mesh output busses  
   //##########################

   always @ (posedge clk or posedge reset)
     if(reset)
       access_out <= 1'b0;
     else if(clk_en)
       if(!wait_in)
	 access_out <= access;

   always @ (posedge clk)
     if (clk_en)
       if(!wait_in & access)
	 begin
	    srcaddr_out[AW-1:0] <= srcaddr[AW-1:0];
	    data_out[DW-1:0]    <= data[DW-1:0];
	    write_out           <= write;
	    datamode_out[1:0]   <= datamode[1:0]; 
	    dstaddr_out[AW-1:0] <= dstaddr[AW-1:0];
	    ctrlmode_out[3:0]   <= ctrlmode[3:0];
	 end
 
   //#####################
   //# Wait out control
   //#####################
   always @ (posedge clk or posedge reset)
     if(reset)
       wait_out <= 1'b0;
     else if(clk_en)
       wait_out <= wait_int;
   
endmodule // mesh_interface



module e16_mux7(/*AUTOARG*/
   // Outputs
   out,
   // Inputs
   in0, in1, in2, in3, in4, in5, in6, sel0, sel1, sel2, sel3, sel4,
   sel5, sel6
   );

   parameter DW=99;
   

   //data inputs
   input [DW-1:0]  in0;
   input [DW-1:0]  in1;
   input [DW-1:0]  in2;
   input [DW-1:0]  in3;
   input [DW-1:0]  in4;
   input [DW-1:0]  in5;
   input [DW-1:0]  in6;
   
   //select inputs
   input 	   sel0;
   input 	   sel1;
   input 	   sel2;
   input 	   sel3;
   input 	   sel4;
   input 	   sel5;
   input 	   sel6;


   output [DW-1:0] out;
   
  
   assign out[DW-1:0] = ({(DW){sel0}} & in0[DW-1:0] |
			 {(DW){sel1}} & in1[DW-1:0] |
			 {(DW){sel2}} & in2[DW-1:0] |
			 {(DW){sel3}} & in3[DW-1:0] |
			 {(DW){sel4}} & in4[DW-1:0] |
			 {(DW){sel5}} & in5[DW-1:0] |
			 {(DW){sel6}} & in6[DW-1:0]);
   

   // synthesis translate_off
   always @*
     if((sel0+sel1+sel2+sel3+sel4+sel5+sel6>1) & $time>0)
       $display("ERROR>>Arbitration failure in cell %m");
   // synthesis translate_on
   
   
endmodule // mux7

module e16_pulse2pulse(/*AUTOARG*/
   // Outputs
   out,
   // Inputs
   inclk, outclk, in, reset
   );

   
   //clocks
   input  inclk; 
   input  outclk;  

   
   input  in;   
   output out;

   //reset
   input  reset;  //do we need this???



   wire   intoggle;
   wire   insync;
   
   
   //pulse to toggle
   pulse2toggle    pulse2toggle(
				// Outputs
				.out		(intoggle),
				// Inputs
				.clk		(inclk),
				.in		(in),
				.reset		(reset));
   
   //metastability synchronizer
   synchronizer #(1) synchronizer(
				  // Outputs
				  .out			(insync),
				  // Inputs
				  .in			(intoggle),
				  .clk			(outclk),
				  .reset		(reset));
   
   
   //toogle to pulse
   toggle2pulse toggle2pulse(
			     // Outputs
			     .out		(out),
			     // Inputs
			     .clk		(outclk),
			     .in		(insync),
			     .reset		(reset));
   

   
endmodule // pulse2pulse



module e16_pulse2toggle(/*AUTOARG*/
   // Outputs
   out,
   // Inputs
   clk, in, reset
   );

   
   //clocks
   input  clk; 
   
   input  in;   
   output out;

   //reset
   input  reset;  //do we need this???


   reg 	  out;
   wire   toggle;
   
   //if input goes high, toggle output
   //note1: input can only be high for one clock cycle
   //note2: be careful with clock gating

   assign toggle = in ? ~out :
		         out;
   

   always @ (posedge clk or posedge reset)
     if(reset)
       out <= 1'b0;
     else
       out <= toggle;
   
endmodule // pulse2toggle




module e16_synchronizer #(parameter DW=32) (/*AUTOARG*/
   // Outputs
   out,
   // Inputs
   in, clk, reset
   );


   //Input Side   
   input  [DW-1:0] in;   
   input           clk;      
   input           reset;//asynchronous signal
   
   
   //Output Side
   output [DW-1:0] out;

   reg [DW-1:0] sync_reg0;
   reg [DW-1:0] sync_reg1;
   reg [DW-1:0] out;
     
   //Synchronization between clock domain
   //We use two flip-flops for metastability improvement
   always @ (posedge clk or posedge reset)
     if(reset)
       begin
	  sync_reg0[DW-1:0] <= {(DW){1'b0}};
	  sync_reg1[DW-1:0] <= {(DW){1'b0}};
	  out[DW-1:0]       <= {(DW){1'b0}};
       end
     else
       begin
	  sync_reg0[DW-1:0] <= in[DW-1:0];
	  sync_reg1[DW-1:0] <= sync_reg0[DW-1:0];
	  out[DW-1:0]       <= sync_reg1[DW-1:0];
       end
   


   
   
     

endmodule // clock_synchronizer

//goes high for one clock cycle on every input transition
module e16_toggle2pulse(/*AUTOARG*/
   // Outputs
   out,
   // Inputs
   clk, in, reset
   );

   
   //clocks
   input  clk; 
   
   input  in;   
   output out;

   //reset
   input  reset;
   reg 	  out_reg;
         
   always @ (posedge clk or posedge reset)
     if(reset)
       out_reg <= 1'b0;
     else
       out_reg <= in;
      
   assign out = in ^ out_reg;

endmodule 





module elink_e16 (/*AUTOARG*/
   // Outputs
   rxi_rd_wait, rxi_wr_wait, txo_data, txo_lclk, txo_frame,
   c0_mesh_access_out, c0_mesh_write_out, c0_mesh_dstaddr_out,
   c0_mesh_srcaddr_out, c0_mesh_data_out, c0_mesh_datamode_out,
   c0_mesh_ctrlmode_out, c0_emesh_wait_out, c0_mesh_wait_out,
   // Inputs
   reset, c0_clk_in, c1_clk_in, c2_clk_in, c3_clk_in, rxi_data,
   rxi_lclk, rxi_frame, txo_rd_wait, txo_wr_wait, c0_mesh_access_in,
   c0_mesh_write_in, c0_mesh_dstaddr_in, c0_mesh_srcaddr_in,
   c0_mesh_data_in, c0_mesh_datamode_in, c0_mesh_ctrlmode_in,
   c0_mesh_wait_in
   );
   
   parameter DW   = `CFG_DW  ;//data width  
   parameter AW   = `CFG_AW  ;//address width
   parameter LW   = `CFG_LW  ;//lvds tranceiver pairs per side

 
   
   //Reset/core clock
   input             reset; 
   input 	     c0_clk_in;
   input 	     c1_clk_in;
   input 	     c2_clk_in;
   input 	     c3_clk_in;
   

   // # IO Signals
   input   [LW-1:0]  rxi_data;      // Byte word
   input             rxi_lclk;      // receive clock (adjusted)
   input             rxi_frame;     // indicates new transmission
   input             txo_rd_wait;   // wait indicator on read transactions   
   input             txo_wr_wait;   // wait indicator on write transactions  
   output 	     rxi_rd_wait;   // wait indicator on read transaction  
   output 	     rxi_wr_wait;   // wait indicator on write transaction  
   output  [LW-1:0]  txo_data;      // Byte word
   output            txo_lclk;      // transmit clock
   output            txo_frame;     // indicates new transmission 

   

   // # MESH 
   // # core0 (external corners and multicast)
   input 	    c0_mesh_access_in;  // access control from the mesh
   input 	    c0_mesh_write_in;   // write control from the mesh
   input [AW-1:0]   c0_mesh_dstaddr_in; // destination address from the mesh
   input [AW-1:0]   c0_mesh_srcaddr_in; // source address from the mesh
   input [DW-1:0]   c0_mesh_data_in;    // data from the mesh
   input [1:0] 	    c0_mesh_datamode_in;// data mode from the mesh 
   input [3:0] 	    c0_mesh_ctrlmode_in;// ctrl mode from the mesh
   input 	    c0_mesh_wait_in;   // wait



   // ##############
   // # Outputs
   // ##############

   
   // # MESH (write transactions internal and external corners)
   // # core0 
   output 	     c0_mesh_access_out;  // access control to the mesh
   output 	     c0_mesh_write_out;   // write control to the mesh
   output [AW-1:0]   c0_mesh_dstaddr_out; // destination address to the mesh
   output [AW-1:0]   c0_mesh_srcaddr_out; // source address to the mesh
   output [DW-1:0]   c0_mesh_data_out;    // data to the mesh
   output [1:0]      c0_mesh_datamode_out;// data mode to the mesh 
   output [3:0]      c0_mesh_ctrlmode_out;// ctrl mode to the mesh
  

   // # Waits
   output 	     c0_emesh_wait_out; // wait to the emesh   
   output 	     c0_mesh_wait_out;  // wait to the mesh 


   //TODO: NOTRE FIXED COORDINATE
   wire [3:0] 	     ext_yid_k=4'h8;   
   wire [3:0] 	     ext_xid_k=4'h2;   
   wire 	     vertical_k=1'b1; // specifies if block is vertical or horizontal
   wire [3:0] 	     who_am_i=4'b0100;   // (north,east,south,west)
   wire 	     cfg_extcomp_dis=1'b0;// Disable external coordinates comparison

   /*AUTOINPUT*/
   /*AUTOWIRE*/
   // Beginning of automatic wires (for undeclared instantiated-module outputs)
   wire			c0_emesh_frame_out;	// From link_port of link_port.v
   wire [2*LW-1:0]	c0_emesh_tran_out;	// From link_port of link_port.v
   wire			c0_rdmesh_frame_out;	// From link_port of link_port.v
   wire [2*LW-1:0]	c0_rdmesh_tran_out;	// From link_port of link_port.v
   wire			c0_rdmesh_wait_out;	// From link_port of link_port.v
   wire			c1_emesh_wait_out;	// From link_port of link_port.v
   wire			c1_rdmesh_frame_out;	// From link_port of link_port.v
   wire [2*LW-1:0]	c1_rdmesh_tran_out;	// From link_port of link_port.v
   wire			c1_rdmesh_wait_out;	// From link_port of link_port.v
   wire			c2_emesh_wait_out;	// From link_port of link_port.v
   wire			c2_rdmesh_frame_out;	// From link_port of link_port.v
   wire [2*LW-1:0]	c2_rdmesh_tran_out;	// From link_port of link_port.v
   wire			c2_rdmesh_wait_out;	// From link_port of link_port.v
   wire			c3_emesh_frame_out;	// From link_port of link_port.v
   wire [2*LW-1:0]	c3_emesh_tran_out;	// From link_port of link_port.v
   wire			c3_emesh_wait_out;	// From link_port of link_port.v
   wire			c3_mesh_access_out;	// From link_port of link_port.v
   wire [3:0]		c3_mesh_ctrlmode_out;	// From link_port of link_port.v
   wire [DW-1:0]	c3_mesh_data_out;	// From link_port of link_port.v
   wire [1:0]		c3_mesh_datamode_out;	// From link_port of link_port.v
   wire [AW-1:0]	c3_mesh_dstaddr_out;	// From link_port of link_port.v
   wire [AW-1:0]	c3_mesh_srcaddr_out;	// From link_port of link_port.v
   wire			c3_mesh_wait_out;	// From link_port of link_port.v
   wire			c3_mesh_write_out;	// From link_port of link_port.v
   wire			c3_rdmesh_frame_out;	// From link_port of link_port.v
   wire [2*LW-1:0]	c3_rdmesh_tran_out;	// From link_port of link_port.v
   wire			c3_rdmesh_wait_out;	// From link_port of link_port.v
   // End of automatics

   /* link_port AUTO_TEMPLATE  (.\(.*\)_rdmesh_tran_in (16'b0),
                                .\(.*\)_rdmesh_frame_in (1'b0),
                                .\(.*\)_emesh_tran_in (16'b0),
                                .\(.*\)_emesh_frame_in (1'b0),
    );
    */
   

   wire		c0_emesh_wait_in=1'b0;
   wire		c0_rdmesh_wait_in=1'b0;
   wire		c1_rdmesh_wait_in=1'b0;
   wire		c2_rdmesh_wait_in=1'b0;
   wire		c3_emesh_wait_in=1'b0;
   wire		c3_mesh_wait_in=1'b0;
   wire		c3_rdmesh_wait_in=1'b0;
   wire [5:0] 	txo_cfg_reg=6'b0;
   

   link_port link_port (.c3_mesh_access_in(1'b0),
			.c3_mesh_write_in(1'b0),
			.c3_mesh_dstaddr_in(32'b0),
			.c3_mesh_srcaddr_in(32'b0),
			.c3_mesh_data_in(32'b0),
			.c3_mesh_datamode_in(2'b0),
			.c3_mesh_ctrlmode_in(4'b0),
			/*AUTOINST*/
			// Outputs
			.rxi_rd_wait	(rxi_rd_wait),
			.rxi_wr_wait	(rxi_wr_wait),
			.txo_data	(txo_data[LW-1:0]),
			.txo_lclk	(txo_lclk),
			.txo_frame	(txo_frame),
			.c0_emesh_frame_out(c0_emesh_frame_out),
			.c0_emesh_tran_out(c0_emesh_tran_out[2*LW-1:0]),
			.c3_emesh_frame_out(c3_emesh_frame_out),
			.c3_emesh_tran_out(c3_emesh_tran_out[2*LW-1:0]),
			.c0_rdmesh_frame_out(c0_rdmesh_frame_out),
			.c0_rdmesh_tran_out(c0_rdmesh_tran_out[2*LW-1:0]),
			.c1_rdmesh_frame_out(c1_rdmesh_frame_out),
			.c1_rdmesh_tran_out(c1_rdmesh_tran_out[2*LW-1:0]),
			.c2_rdmesh_frame_out(c2_rdmesh_frame_out),
			.c2_rdmesh_tran_out(c2_rdmesh_tran_out[2*LW-1:0]),
			.c3_rdmesh_frame_out(c3_rdmesh_frame_out),
			.c3_rdmesh_tran_out(c3_rdmesh_tran_out[2*LW-1:0]),
			.c0_mesh_access_out(c0_mesh_access_out),
			.c0_mesh_write_out(c0_mesh_write_out),
			.c0_mesh_dstaddr_out(c0_mesh_dstaddr_out[AW-1:0]),
			.c0_mesh_srcaddr_out(c0_mesh_srcaddr_out[AW-1:0]),
			.c0_mesh_data_out(c0_mesh_data_out[DW-1:0]),
			.c0_mesh_datamode_out(c0_mesh_datamode_out[1:0]),
			.c0_mesh_ctrlmode_out(c0_mesh_ctrlmode_out[3:0]),
			.c3_mesh_access_out(c3_mesh_access_out),
			.c3_mesh_write_out(c3_mesh_write_out),
			.c3_mesh_dstaddr_out(c3_mesh_dstaddr_out[AW-1:0]),
			.c3_mesh_srcaddr_out(c3_mesh_srcaddr_out[AW-1:0]),
			.c3_mesh_data_out(c3_mesh_data_out[DW-1:0]),
			.c3_mesh_datamode_out(c3_mesh_datamode_out[1:0]),
			.c3_mesh_ctrlmode_out(c3_mesh_ctrlmode_out[3:0]),
			.c0_emesh_wait_out(c0_emesh_wait_out),
			.c1_emesh_wait_out(c1_emesh_wait_out),
			.c2_emesh_wait_out(c2_emesh_wait_out),
			.c3_emesh_wait_out(c3_emesh_wait_out),
			.c0_rdmesh_wait_out(c0_rdmesh_wait_out),
			.c1_rdmesh_wait_out(c1_rdmesh_wait_out),
			.c2_rdmesh_wait_out(c2_rdmesh_wait_out),
			.c3_rdmesh_wait_out(c3_rdmesh_wait_out),
			.c0_mesh_wait_out(c0_mesh_wait_out),
			.c3_mesh_wait_out(c3_mesh_wait_out),
			// Inputs
			.reset		(reset),
			.ext_yid_k	(ext_yid_k[3:0]),
			.ext_xid_k	(ext_xid_k[3:0]),
			.txo_cfg_reg	(txo_cfg_reg[5:0]),
			.vertical_k	(vertical_k),
			.who_am_i	(who_am_i[3:0]),
			.cfg_extcomp_dis(cfg_extcomp_dis),
			.rxi_data	(rxi_data[LW-1:0]),
			.rxi_lclk	(rxi_lclk),
			.rxi_frame	(rxi_frame),
			.txo_rd_wait	(txo_rd_wait),
			.txo_wr_wait	(txo_wr_wait),
			.c0_clk_in	(c0_clk_in),
			.c1_clk_in	(c1_clk_in),
			.c2_clk_in	(c2_clk_in),
			.c3_clk_in	(c3_clk_in),
			.c0_emesh_tran_in(16'b0),		 // Templated
			.c0_emesh_frame_in(1'b0),		 // Templated
			.c1_emesh_tran_in(16'b0),		 // Templated
			.c1_emesh_frame_in(1'b0),		 // Templated
			.c2_emesh_tran_in(16'b0),		 // Templated
			.c2_emesh_frame_in(1'b0),		 // Templated
			.c3_emesh_tran_in(16'b0),		 // Templated
			.c3_emesh_frame_in(1'b0),		 // Templated
			.c0_rdmesh_tran_in(16'b0),		 // Templated
			.c0_rdmesh_frame_in(1'b0),		 // Templated
			.c1_rdmesh_tran_in(16'b0),		 // Templated
			.c1_rdmesh_frame_in(1'b0),		 // Templated
			.c2_rdmesh_tran_in(16'b0),		 // Templated
			.c2_rdmesh_frame_in(1'b0),		 // Templated
			.c3_rdmesh_tran_in(16'b0),		 // Templated
			.c3_rdmesh_frame_in(1'b0),		 // Templated
			.c0_mesh_access_in(c0_mesh_access_in),
			.c0_mesh_write_in(c0_mesh_write_in),
			.c0_mesh_dstaddr_in(c0_mesh_dstaddr_in[AW-1:0]),
			.c0_mesh_srcaddr_in(c0_mesh_srcaddr_in[AW-1:0]),
			.c0_mesh_data_in(c0_mesh_data_in[DW-1:0]),
			.c0_mesh_datamode_in(c0_mesh_datamode_in[1:0]),
			.c0_mesh_ctrlmode_in(c0_mesh_ctrlmode_in[3:0]),
			.c0_emesh_wait_in(c0_emesh_wait_in),
			.c3_emesh_wait_in(c3_emesh_wait_in),
			.c0_mesh_wait_in(c0_mesh_wait_in),
			.c3_mesh_wait_in(c3_mesh_wait_in),
			.c0_rdmesh_wait_in(c0_rdmesh_wait_in),
			.c1_rdmesh_wait_in(c1_rdmesh_wait_in),
			.c2_rdmesh_wait_in(c2_rdmesh_wait_in),
			.c3_rdmesh_wait_in(c3_rdmesh_wait_in));
      
endmodule // elink_e16

module link_port(/*AUTOARG*/
   // Outputs
   rxi_rd_wait, rxi_wr_wait, txo_data, txo_lclk, txo_frame,
   c0_emesh_frame_out, c0_emesh_tran_out, c3_emesh_frame_out,
   c3_emesh_tran_out, c0_rdmesh_frame_out, c0_rdmesh_tran_out,
   c1_rdmesh_frame_out, c1_rdmesh_tran_out, c2_rdmesh_frame_out,
   c2_rdmesh_tran_out, c3_rdmesh_frame_out, c3_rdmesh_tran_out,
   c0_mesh_access_out, c0_mesh_write_out, c0_mesh_dstaddr_out,
   c0_mesh_srcaddr_out, c0_mesh_data_out, c0_mesh_datamode_out,
   c0_mesh_ctrlmode_out, c3_mesh_access_out, c3_mesh_write_out,
   c3_mesh_dstaddr_out, c3_mesh_srcaddr_out, c3_mesh_data_out,
   c3_mesh_datamode_out, c3_mesh_ctrlmode_out, c0_emesh_wait_out,
   c1_emesh_wait_out, c2_emesh_wait_out, c3_emesh_wait_out,
   c0_rdmesh_wait_out, c1_rdmesh_wait_out, c2_rdmesh_wait_out,
   c3_rdmesh_wait_out, c0_mesh_wait_out, c3_mesh_wait_out,
   // Inputs
   reset, ext_yid_k, ext_xid_k, txo_cfg_reg, vertical_k, who_am_i,
   cfg_extcomp_dis, rxi_data, rxi_lclk, rxi_frame, txo_rd_wait,
   txo_wr_wait, c0_clk_in, c1_clk_in, c2_clk_in, c3_clk_in,
   c0_emesh_tran_in, c0_emesh_frame_in, c1_emesh_tran_in,
   c1_emesh_frame_in, c2_emesh_tran_in, c2_emesh_frame_in,
   c3_emesh_tran_in, c3_emesh_frame_in, c0_rdmesh_tran_in,
   c0_rdmesh_frame_in, c1_rdmesh_tran_in, c1_rdmesh_frame_in,
   c2_rdmesh_tran_in, c2_rdmesh_frame_in, c3_rdmesh_tran_in,
   c3_rdmesh_frame_in, c0_mesh_access_in, c0_mesh_write_in,
   c0_mesh_dstaddr_in, c0_mesh_srcaddr_in, c0_mesh_data_in,
   c0_mesh_datamode_in, c0_mesh_ctrlmode_in, c3_mesh_access_in,
   c3_mesh_write_in, c3_mesh_dstaddr_in, c3_mesh_srcaddr_in,
   c3_mesh_data_in, c3_mesh_datamode_in, c3_mesh_ctrlmode_in,
   c0_emesh_wait_in, c3_emesh_wait_in, c0_mesh_wait_in,
   c3_mesh_wait_in, c0_rdmesh_wait_in, c1_rdmesh_wait_in,
   c2_rdmesh_wait_in, c3_rdmesh_wait_in
   );

   parameter DW   = `CFG_DW  ;//data width  
   parameter AW   = `CFG_AW  ;//address width
   parameter LW   = `CFG_LW  ;//lvds tranceiver pairs per side

   // #########
   // # Inputs
   // #########
   
   input             reset;     //reset input
   input [3:0] 	     ext_yid_k; //external y-id 
   input [3:0] 	     ext_xid_k; //external x-id

   input [5:0] 	     txo_cfg_reg;// Link configuration register
   input             vertical_k; // specifies if block is vertical or horizontal
   input [3:0] 	     who_am_i;   // specifies what link is that (north,east,south,west)
   input 	     cfg_extcomp_dis;// Disable external coordinates comparison
                                     // Every input transaction is received by the chip
   // # Vertical_k usage:
   // # West/East link port is "vertical", i.e. sends transactions to the cores
   // # horizontally, according to the row_k[2:0] index
   // # North/South link port is "horizontal", i.e. sends transactions to the cores
   // # vertically, according to the col_k[2:0] index
   // # In order to distinguish between West/East and North/South,
   // # vertical_k index is used.

   // # Receiver
   input   [LW-1:0]  rxi_data;        // Byte word
   input             rxi_lclk;        // receive clock (adjusted to the frame/data)
   input             rxi_frame;       // indicates new transmission

   // # Transmitter
   input             txo_rd_wait;     // wait indicator on read transactions   
   input             txo_wr_wait;     // wait indicator on write transactions  

   // # Clocks
   input 	    c0_clk_in;         // clock of the core  
   input 	    c1_clk_in;         // clock of the core  
   input 	    c2_clk_in;         // clock of the core  
   input 	    c3_clk_in;         // clock of the core  

   // # EMESH
   input [2*LW-1:0] c0_emesh_tran_in;  // serialized transaction
   input 	    c0_emesh_frame_in; // transaction frame
   input [2*LW-1:0] c1_emesh_tran_in;  // serialized transaction
   input 	    c1_emesh_frame_in; // transaction frame
   input [2*LW-1:0] c2_emesh_tran_in;  // serialized transaction
   input 	    c2_emesh_frame_in; // transaction frame
   input [2*LW-1:0] c3_emesh_tran_in;  // serialized transaction
   input 	    c3_emesh_frame_in; // transaction frame
   // # RDMESH
   input [2*LW-1:0] c0_rdmesh_tran_in;  // serialized transaction
   input 	    c0_rdmesh_frame_in; // transaction frame
   input [2*LW-1:0] c1_rdmesh_tran_in;  // serialized transaction
   input 	    c1_rdmesh_frame_in; // transaction frame
   input [2*LW-1:0] c2_rdmesh_tran_in;  // serialized transaction
   input 	    c2_rdmesh_frame_in; // transaction frame
   input [2*LW-1:0] c3_rdmesh_tran_in;  // serialized transaction
   input 	    c3_rdmesh_frame_in; // transaction frame
   // # MESH 
   // # core0 (external corners and multicast)
   input 	    c0_mesh_access_in;  // access control from the mesh
   input 	    c0_mesh_write_in;   // write control from the mesh
   input [AW-1:0]   c0_mesh_dstaddr_in; // destination address from the mesh
   input [AW-1:0]   c0_mesh_srcaddr_in; // source address from the mesh
   input [DW-1:0]   c0_mesh_data_in;    // data from the mesh
   input [1:0] 	    c0_mesh_datamode_in;// data mode from the mesh 
   input [3:0] 	    c0_mesh_ctrlmode_in;// ctrl mode from the mesh
   // # core3 (external corners only)
   input 	    c3_mesh_access_in;  // access control from the mesh
   input 	    c3_mesh_write_in;   // write control from the mesh
   input [AW-1:0]   c3_mesh_dstaddr_in; // destination address from the mesh
   input [AW-1:0]   c3_mesh_srcaddr_in; // source address from the mesh
   input [DW-1:0]   c3_mesh_data_in;    // data from the mesh
   input [1:0] 	    c3_mesh_datamode_in;// data mode from the mesh 
   input [3:0] 	    c3_mesh_ctrlmode_in;// ctrl mode from the mesh

   //# Waits
   input 	    c0_emesh_wait_in;  // wait
   input 	    c3_emesh_wait_in;  // wait
   input 	    c0_mesh_wait_in;   // wait
   input 	    c3_mesh_wait_in;   // wait
   input 	    c0_rdmesh_wait_in; // wait
   input 	    c1_rdmesh_wait_in; // wait
   input 	    c2_rdmesh_wait_in; // wait
   input 	    c3_rdmesh_wait_in; // wait

   // ##############
   // # Outputs
   // ##############

   // # Receiver
   output 	     rxi_rd_wait;      // wait indicator on read transaction  
   output 	     rxi_wr_wait;      // wait indicator on write transaction  

   // # Transmitter
   output  [LW-1:0]  txo_data;      // Byte word
   output            txo_lclk;      // transmit clock (adjusted to the frame/data)
   output            txo_frame;     // indicates new transmission 

   //# EMESH (write transactions with the off chip destination)
   output            c0_emesh_frame_out; // transaction frame
   output [2*LW-1:0] c0_emesh_tran_out;  // serialized transaction
   output            c3_emesh_frame_out; // transaction frame
   output [2*LW-1:0] c3_emesh_tran_out;  // serialized transaction
   // # RDMESH (any read transaction)
   output            c0_rdmesh_frame_out; // transaction frame
   output [2*LW-1:0] c0_rdmesh_tran_out;  // serialized transaction
   output            c1_rdmesh_frame_out; // transaction frame
   output [2*LW-1:0] c1_rdmesh_tran_out;  // serialized transaction
   output            c2_rdmesh_frame_out; // transaction frame
   output [2*LW-1:0] c2_rdmesh_tran_out;  // serialized transaction
   output            c3_rdmesh_frame_out; // transaction frame
   output [2*LW-1:0] c3_rdmesh_tran_out;  // serialized transaction
   // # MESH (write transactions internal and external corners)
   // # core0 
   output 	     c0_mesh_access_out;  // access control to the mesh
   output 	     c0_mesh_write_out;   // write control to the mesh
   output [AW-1:0]   c0_mesh_dstaddr_out; // destination address to the mesh
   output [AW-1:0]   c0_mesh_srcaddr_out; // source address to the mesh
   output [DW-1:0]   c0_mesh_data_out;    // data to the mesh
   output [1:0]      c0_mesh_datamode_out;// data mode to the mesh 
   output [3:0]      c0_mesh_ctrlmode_out;// ctrl mode to the mesh
   // # core3 
   output 	     c3_mesh_access_out;  // access control to the mesh
   output 	     c3_mesh_write_out;   // write control to the mesh
   output [AW-1:0]   c3_mesh_dstaddr_out; // destination address to the mesh
   output [AW-1:0]   c3_mesh_srcaddr_out; // source address to the mesh
   output [DW-1:0]   c3_mesh_data_out;    // data to the mesh
   output [1:0]      c3_mesh_datamode_out;// data mode to the mesh 
   output [3:0]      c3_mesh_ctrlmode_out;// ctrl mode to the mesh

   // # Waits
   output 	     c0_emesh_wait_out; // wait to the emesh   
   output 	     c1_emesh_wait_out; // wait to the emesh   
   output 	     c2_emesh_wait_out; // wait to the emesh   
   output 	     c3_emesh_wait_out; // wait to the emesh   

   output 	     c0_rdmesh_wait_out; // wait to the rdmesh   
   output 	     c1_rdmesh_wait_out; // wait to the rdmesh   
   output 	     c2_rdmesh_wait_out; // wait to the rdmesh   
   output 	     c3_rdmesh_wait_out; // wait to the rdmesh   

   output 	     c0_mesh_wait_out;  // wait to the mesh 
   output 	     c3_mesh_wait_out;  // wait to the mesh 
     
   /*AUTOINPUT*/
   /*AUTOWIRE*/
 
   // #########################
   // # Receiver instantiation
   // #########################
  
   link_receiver  link_receiver(/*AUTOINST*/
				// Outputs
				.rxi_wr_wait	(rxi_wr_wait),
				.rxi_rd_wait	(rxi_rd_wait),
				.c0_emesh_frame_out(c0_emesh_frame_out),
				.c0_emesh_tran_out(c0_emesh_tran_out[2*LW-1:0]),
				.c3_emesh_frame_out(c3_emesh_frame_out),
				.c3_emesh_tran_out(c3_emesh_tran_out[2*LW-1:0]),
				.c0_rdmesh_frame_out(c0_rdmesh_frame_out),
				.c0_rdmesh_tran_out(c0_rdmesh_tran_out[2*LW-1:0]),
				.c1_rdmesh_frame_out(c1_rdmesh_frame_out),
				.c1_rdmesh_tran_out(c1_rdmesh_tran_out[2*LW-1:0]),
				.c2_rdmesh_frame_out(c2_rdmesh_frame_out),
				.c2_rdmesh_tran_out(c2_rdmesh_tran_out[2*LW-1:0]),
				.c3_rdmesh_frame_out(c3_rdmesh_frame_out),
				.c3_rdmesh_tran_out(c3_rdmesh_tran_out[2*LW-1:0]),
				.c0_mesh_access_out(c0_mesh_access_out),
				.c0_mesh_write_out(c0_mesh_write_out),
				.c0_mesh_dstaddr_out(c0_mesh_dstaddr_out[AW-1:0]),
				.c0_mesh_srcaddr_out(c0_mesh_srcaddr_out[AW-1:0]),
				.c0_mesh_data_out(c0_mesh_data_out[DW-1:0]),
				.c0_mesh_datamode_out(c0_mesh_datamode_out[1:0]),
				.c0_mesh_ctrlmode_out(c0_mesh_ctrlmode_out[3:0]),
				.c3_mesh_access_out(c3_mesh_access_out),
				.c3_mesh_write_out(c3_mesh_write_out),
				.c3_mesh_dstaddr_out(c3_mesh_dstaddr_out[AW-1:0]),
				.c3_mesh_srcaddr_out(c3_mesh_srcaddr_out[AW-1:0]),
				.c3_mesh_data_out(c3_mesh_data_out[DW-1:0]),
				.c3_mesh_datamode_out(c3_mesh_datamode_out[1:0]),
				.c3_mesh_ctrlmode_out(c3_mesh_ctrlmode_out[3:0]),
				// Inputs
				.reset		(reset),
				.ext_yid_k	(ext_yid_k[3:0]),
				.ext_xid_k	(ext_xid_k[3:0]),
				.vertical_k	(vertical_k),
				.who_am_i	(who_am_i[3:0]),
				.cfg_extcomp_dis(cfg_extcomp_dis),
				.rxi_data	(rxi_data[LW-1:0]),
				.rxi_lclk	(rxi_lclk),
				.rxi_frame	(rxi_frame),
				.c0_clk_in	(c0_clk_in),
				.c1_clk_in	(c1_clk_in),
				.c2_clk_in	(c2_clk_in),
				.c3_clk_in	(c3_clk_in),
				.c0_emesh_wait_in(c0_emesh_wait_in),
				.c3_emesh_wait_in(c3_emesh_wait_in),
				.c0_mesh_wait_in(c0_mesh_wait_in),
				.c3_mesh_wait_in(c3_mesh_wait_in),
				.c0_rdmesh_wait_in(c0_rdmesh_wait_in),
				.c1_rdmesh_wait_in(c1_rdmesh_wait_in),
				.c2_rdmesh_wait_in(c2_rdmesh_wait_in),
				.c3_rdmesh_wait_in(c3_rdmesh_wait_in));
   

   // ############################
   // # Transmitter instantiation
   // ############################

   link_transmitter  link_transmitter(.txo_lclk90	(txo_lclk),
				      /*AUTOINST*/
				      // Outputs
				      .txo_data		(txo_data[LW-1:0]),
				      .txo_frame	(txo_frame),
				      .c0_emesh_wait_out(c0_emesh_wait_out),
				      .c1_emesh_wait_out(c1_emesh_wait_out),
				      .c2_emesh_wait_out(c2_emesh_wait_out),
				      .c3_emesh_wait_out(c3_emesh_wait_out),
				      .c0_rdmesh_wait_out(c0_rdmesh_wait_out),
				      .c1_rdmesh_wait_out(c1_rdmesh_wait_out),
				      .c2_rdmesh_wait_out(c2_rdmesh_wait_out),
				      .c3_rdmesh_wait_out(c3_rdmesh_wait_out),
				      .c0_mesh_wait_out	(c0_mesh_wait_out),
				      .c3_mesh_wait_out	(c3_mesh_wait_out),
				      // Inputs
				      .reset		(reset),
				      .ext_yid_k	(ext_yid_k[3:0]),
				      .ext_xid_k	(ext_xid_k[3:0]),
				      .who_am_i		(who_am_i[3:0]),
				      .txo_cfg_reg	(txo_cfg_reg[5:0]),
				      .txo_wr_wait	(txo_wr_wait),
				      .txo_rd_wait	(txo_rd_wait),
				      .c0_clk_in	(c0_clk_in),
				      .c1_clk_in	(c1_clk_in),
				      .c2_clk_in	(c2_clk_in),
				      .c3_clk_in	(c3_clk_in),
				      .c0_mesh_access_in(c0_mesh_access_in),
				      .c0_mesh_write_in	(c0_mesh_write_in),
				      .c0_mesh_dstaddr_in(c0_mesh_dstaddr_in[AW-1:0]),
				      .c0_mesh_srcaddr_in(c0_mesh_srcaddr_in[AW-1:0]),
				      .c0_mesh_data_in	(c0_mesh_data_in[DW-1:0]),
				      .c0_mesh_datamode_in(c0_mesh_datamode_in[1:0]),
				      .c0_mesh_ctrlmode_in(c0_mesh_ctrlmode_in[3:0]),
				      .c3_mesh_access_in(c3_mesh_access_in),
				      .c3_mesh_write_in	(c3_mesh_write_in),
				      .c3_mesh_dstaddr_in(c3_mesh_dstaddr_in[AW-1:0]),
				      .c3_mesh_srcaddr_in(c3_mesh_srcaddr_in[AW-1:0]),
				      .c3_mesh_data_in	(c3_mesh_data_in[DW-1:0]),
				      .c3_mesh_datamode_in(c3_mesh_datamode_in[1:0]),
				      .c3_mesh_ctrlmode_in(c3_mesh_ctrlmode_in[3:0]));
      
endmodule // link_port


module link_receiver(/*AUTOARG*/
   // Outputs
   rxi_wr_wait, rxi_rd_wait, c0_emesh_frame_out, c0_emesh_tran_out,
   c3_emesh_frame_out, c3_emesh_tran_out, c0_rdmesh_frame_out,
   c0_rdmesh_tran_out, c1_rdmesh_frame_out, c1_rdmesh_tran_out,
   c2_rdmesh_frame_out, c2_rdmesh_tran_out, c3_rdmesh_frame_out,
   c3_rdmesh_tran_out, c0_mesh_access_out, c0_mesh_write_out,
   c0_mesh_dstaddr_out, c0_mesh_srcaddr_out, c0_mesh_data_out,
   c0_mesh_datamode_out, c0_mesh_ctrlmode_out, c3_mesh_access_out,
   c3_mesh_write_out, c3_mesh_dstaddr_out, c3_mesh_srcaddr_out,
   c3_mesh_data_out, c3_mesh_datamode_out, c3_mesh_ctrlmode_out,
   // Inputs
   reset, ext_yid_k, ext_xid_k, vertical_k, who_am_i, cfg_extcomp_dis,
   rxi_data, rxi_lclk, rxi_frame, c0_clk_in, c1_clk_in, c2_clk_in,
   c3_clk_in, c0_emesh_wait_in, c3_emesh_wait_in, c0_mesh_wait_in,
   c3_mesh_wait_in, c0_rdmesh_wait_in, c1_rdmesh_wait_in,
   c2_rdmesh_wait_in, c3_rdmesh_wait_in
   );

   parameter LW   = `CFG_LW;//lvds tranceiver pairs per side
   parameter DW   = `CFG_DW;//data width  
   parameter AW   = `CFG_AW;//address width
		     
   // #########
   // # Inputs
   // #########

   input             reset;     // reset input
   input [3:0] 	     ext_yid_k; // external y-id 
   input [3:0] 	     ext_xid_k; // external x-id
   input             vertical_k;// specifies if block is vertical or horizontal
   input [3:0] 	     who_am_i;  // specifies what link is that (north,east,south,west)
   input 	     cfg_extcomp_dis;// Disable external coordinates comparison
                                     // Every input transaction is received by the chip
  
   input [LW-1:0]    rxi_data;  // Byte word
   input             rxi_lclk;  // receive clock (adjusted to the frame/data)
   input             rxi_frame; // indicates new transmission

   // # Sync clocks
   input             c0_clk_in; // clock of the core
   input             c1_clk_in; // clock of the core
   input             c2_clk_in; // clock of the core
   input             c3_clk_in; // clock of the core

   // # Wait indicators
   input             c0_emesh_wait_in;  // wait
   input             c3_emesh_wait_in;  // wait
   input 	     c0_mesh_wait_in;   // wait
   input 	     c3_mesh_wait_in;   // wait
   input             c0_rdmesh_wait_in; // wait
   input             c1_rdmesh_wait_in; // wait
   input             c2_rdmesh_wait_in; // wait
   input             c3_rdmesh_wait_in; // wait

   // ##########
   // # Outputs
   // ##########

   output 	     rxi_wr_wait;  //wait indicator for write transactions
   output 	     rxi_rd_wait;  //wait indicator for read transactions 

   //# EMESH (write transactions with the off chip destination)
   output            c0_emesh_frame_out; // transaction frame
   output [2*LW-1:0] c0_emesh_tran_out;  // serialized transaction
   output            c3_emesh_frame_out; // transaction frame
   output [2*LW-1:0] c3_emesh_tran_out;  // serialized transaction
   // # RDMESH (any read transaction)
   output            c0_rdmesh_frame_out; // transaction frame
   output [2*LW-1:0] c0_rdmesh_tran_out;  // serialized transaction
   output            c1_rdmesh_frame_out; // transaction frame
   output [2*LW-1:0] c1_rdmesh_tran_out;  // serialized transaction
   output            c2_rdmesh_frame_out; // transaction frame
   output [2*LW-1:0] c2_rdmesh_tran_out;  // serialized transaction
   output            c3_rdmesh_frame_out; // transaction frame
   output [2*LW-1:0] c3_rdmesh_tran_out;  // serialized transaction
   // # MESH (write transactions internal and external corners)
   // # core0 
   output 	     c0_mesh_access_out;  // access control to the mesh
   output 	     c0_mesh_write_out;   // write control to the mesh
   output [AW-1:0]   c0_mesh_dstaddr_out; // destination address to the mesh
   output [AW-1:0]   c0_mesh_srcaddr_out; // source address to the mesh
   output [DW-1:0]   c0_mesh_data_out;    // data to the mesh
   output [1:0]      c0_mesh_datamode_out;// data mode to the mesh 
   output [3:0]      c0_mesh_ctrlmode_out;// ctrl mode to the mesh
   // # core3 
   output 	     c3_mesh_access_out;  // access control to the mesh
   output 	     c3_mesh_write_out;   // write control to the mesh
   output [AW-1:0]   c3_mesh_dstaddr_out; // destination address to the mesh
   output [AW-1:0]   c3_mesh_srcaddr_out; // source address to the mesh
   output [DW-1:0]   c3_mesh_data_out;    // data to the mesh
   output [1:0]      c3_mesh_datamode_out;// data mode to the mesh 
   output [3:0]      c3_mesh_ctrlmode_out;// ctrl mode to the mesh
  
   /*AUTOINPUT*/
   /*AUTOWIRE*/

   //#################################
   //# Write Transactions Receiver
   //#################################

   link_rxi_wr link_rxi_wr(/*AUTOINST*/
			   // Outputs
			   .rxi_wr_wait		(rxi_wr_wait),
			   .c0_emesh_frame_out	(c0_emesh_frame_out),
			   .c0_emesh_tran_out	(c0_emesh_tran_out[2*LW-1:0]),
			   .c3_emesh_frame_out	(c3_emesh_frame_out),
			   .c3_emesh_tran_out	(c3_emesh_tran_out[2*LW-1:0]),
			   .c0_mesh_access_out	(c0_mesh_access_out),
			   .c0_mesh_write_out	(c0_mesh_write_out),
			   .c0_mesh_dstaddr_out	(c0_mesh_dstaddr_out[AW-1:0]),
			   .c0_mesh_srcaddr_out	(c0_mesh_srcaddr_out[AW-1:0]),
			   .c0_mesh_data_out	(c0_mesh_data_out[DW-1:0]),
			   .c0_mesh_datamode_out(c0_mesh_datamode_out[1:0]),
			   .c0_mesh_ctrlmode_out(c0_mesh_ctrlmode_out[3:0]),
			   .c3_mesh_access_out	(c3_mesh_access_out),
			   .c3_mesh_write_out	(c3_mesh_write_out),
			   .c3_mesh_dstaddr_out	(c3_mesh_dstaddr_out[AW-1:0]),
			   .c3_mesh_srcaddr_out	(c3_mesh_srcaddr_out[AW-1:0]),
			   .c3_mesh_data_out	(c3_mesh_data_out[DW-1:0]),
			   .c3_mesh_datamode_out(c3_mesh_datamode_out[1:0]),
			   .c3_mesh_ctrlmode_out(c3_mesh_ctrlmode_out[3:0]),
			   // Inputs
			   .reset		(reset),
			   .ext_yid_k		(ext_yid_k[3:0]),
			   .ext_xid_k		(ext_xid_k[3:0]),
			   .vertical_k		(vertical_k),
			   .who_am_i		(who_am_i[3:0]),
			   .cfg_extcomp_dis	(cfg_extcomp_dis),
			   .rxi_data		(rxi_data[LW-1:0]),
			   .rxi_lclk		(rxi_lclk),
			   .rxi_frame		(rxi_frame),
			   .c0_clk_in		(c0_clk_in),
			   .c3_clk_in		(c3_clk_in),
			   .c0_emesh_wait_in	(c0_emesh_wait_in),
			   .c3_emesh_wait_in	(c3_emesh_wait_in),
			   .c0_mesh_wait_in	(c0_mesh_wait_in),
			   .c3_mesh_wait_in	(c3_mesh_wait_in));

   //#################################
   //# Read Transactions Receiver
   //#################################

   link_rxi_rd link_rxi_rd(/*AUTOINST*/
			   // Outputs
			   .rxi_rd_wait		(rxi_rd_wait),
			   .c0_rdmesh_frame_out	(c0_rdmesh_frame_out),
			   .c0_rdmesh_tran_out	(c0_rdmesh_tran_out[2*LW-1:0]),
			   .c1_rdmesh_frame_out	(c1_rdmesh_frame_out),
			   .c1_rdmesh_tran_out	(c1_rdmesh_tran_out[2*LW-1:0]),
			   .c2_rdmesh_frame_out	(c2_rdmesh_frame_out),
			   .c2_rdmesh_tran_out	(c2_rdmesh_tran_out[2*LW-1:0]),
			   .c3_rdmesh_frame_out	(c3_rdmesh_frame_out),
			   .c3_rdmesh_tran_out	(c3_rdmesh_tran_out[2*LW-1:0]),
			   // Inputs
			   .reset		(reset),
			   .ext_yid_k		(ext_yid_k[3:0]),
			   .ext_xid_k		(ext_xid_k[3:0]),
			   .vertical_k		(vertical_k),
			   .who_am_i		(who_am_i[3:0]),
			   .cfg_extcomp_dis	(cfg_extcomp_dis),
			   .rxi_data		(rxi_data[LW-1:0]),
			   .rxi_lclk		(rxi_lclk),
			   .rxi_frame		(rxi_frame),
			   .c0_clk_in		(c0_clk_in),
			   .c1_clk_in		(c1_clk_in),
			   .c2_clk_in		(c2_clk_in),
			   .c3_clk_in		(c3_clk_in),
			   .c0_rdmesh_wait_in	(c0_rdmesh_wait_in),
			   .c1_rdmesh_wait_in	(c1_rdmesh_wait_in),
			   .c2_rdmesh_wait_in	(c2_rdmesh_wait_in),
			   .c3_rdmesh_wait_in	(c3_rdmesh_wait_in));


 
endmodule // link_receiver

     //############################################################################
//# The input data stream is of the following structure:
//#
//#        ---     ---     ---     ---     ---     ---
//# lclk _|   |___|   |___|   |___|   |___|   |___|   |_
//#
//#              -------------------------------
//# frame ______/
//#              --- --- --- --- ---
//# data  XXXXXXX 0 X 1 X 2 X 3 X 4 X .....
//#              --- --- --- --- ---
//#
//# byte0 (the byte received on the rising edge of the clock the 
//# same cycle the frame's rising edge is detected) holds the 
//# information of the transmitted transaction.
//#
//#      byte0          | transaction type
//#   ----------------- | ----------------
//#  8'b??_??_?0_<cid>  | New transaction with incremental bursting address
//#  8'b??_??_?1_<cid>  | New transaction with the same bursting address
//#
//#  cid[1:0] - channel id (for now for debugging usage only) 
//#
//#  New transaction structure:
//#  -------------------------
//#   byte1  -> ctrlmode[3:0],dstaddr[31:28]
//#   byte2  -> dstaddr[27:20]
//#   byte3  -> dstaddr[19:12]
//#   byte4  -> dstaddr[11:4]
//#   byte5  -> dstaddr[3:0],datamode[1:0],write,access
//#   byte6  -> data[31:24] (or srcaddr[31:24] if read transaction)
//#   byte7  -> data[23:16] (or srcaddr[23:16] if read transaction)
//#   byte8  -> data[15:8]  (or srcaddr[15:8]  if read transaction)
//#  *byte9  -> data[7:0]   (or srcaddr[7:0]   if read transaction)
//#   byte10 -> data[63:56]  
//#   byte11 -> data[55:48]  
//#   byte12 -> data[47:40]  
//#   byte13 -> data[39:32]  
//# **byte14 -> data[31:24]  
//#    ...
//#    ...
//#    ...
//#
//#  * byte9 is the last byte of 32 bit write or read transaction 
//#   
//# ** if 64 bit write transaction, data of byte14 is the first data byte of
//#    bursting transaction
//# 
//# -- The data is transmitted MSB first but in 32bits resolution. If we want
//#    to transmit 64 bits it will be [31:0] (msb first) and then [63:32] (msb first)
//#
//# !!!
//# !!! According to the above scheme, any new transaction (burst or not)
//# !!! will take at least four cycles to be transmitted.
//# !!! There are some internal mechanisms in the transmitter-receiver logic
//# !!! which are implemented considering this assumption true.
//# !!! Any change to this assumption (transaction takes at least four cycles)
//# !!! should be carefully reviewed with its implications on the internal
//# !!! implementation
//# !!!
//# 
//#####################################################################
module link_rxi_assembler (/*AUTOARG*/
   // Outputs
   rxi_assembled_tran, rxi_c0_access, rxi_c1_access, rxi_c2_access,
   rxi_c3_access,
   // Inputs
   reset, rxi_lclk, vertical_k, ext_yid_k, ext_xid_k, fifo_data_reg,
   fifo_data_val, start_tran, cfg_extcomp_dis
   );

   parameter LW   = `CFG_LW  ;//lvds tranceiver pairs per side
   parameter DW   = `CFG_DW  ;//data width
   parameter AW   = `CFG_AW  ;//address width

   // #########
   // # INPUTS
   // #########
   input            reset;       //reset input
   input 	    rxi_lclk;    //receive clock (adjusted to the frame/data)

   input            vertical_k;  //specifies if block is vertical or horizontal
   input [3:0] 	    ext_yid_k;   //external y-id 
   input [3:0] 	    ext_xid_k;   //external x-id

   input [2*LW-1:0] fifo_data_reg;// output of the input receiver fifo
   input 	    fifo_data_val;// fifo_data_reg is valid
   input 	    start_tran;   // Start transaction bit

   input 	    cfg_extcomp_dis;// Disable external coordinates comparison
                                    // Every input transaction is received by the chip
   // ##########
   // # OUTPUTS
   // ##########
   output [14*LW-1:0] rxi_assembled_tran; // data to be transferred to secondary fifos
   output             rxi_c0_access; //transfering to c0_fifo
   output 	      rxi_c1_access; //transfering to c1_fifo
   output 	      rxi_c2_access; //transfering to c2_fifo
   output 	      rxi_c3_access; //transfering to c3_fifo  

   /*AUTOINPUT*/
   /*AUTOWIRE*/

   // #########
   // # REGS
   // #########
   reg [LW-1:0] tran_byte0;
   reg [2:0] 	rxi_assemble_cnt;
   reg [3:0] 	ctrlmode;
   reg [AW-1:0] dstaddr_int;
   reg [1:0] 	datamode;
   reg 		write;
   reg 		access;
   reg [DW-1:0] data;
   reg [AW-1:0] srcaddr;
   reg 		rxi_cx_access;

   // #########
   // # WIRES
   // #########
   wire          byte0_inc8; // Address of the burst transaction should be incremented
   wire 	 dstaddr_2712_en;
   wire 	 dstaddr_1100_en;
   wire 	 datamode_en;    
   wire 	 write_en;       
   wire 	 access_en;      
   wire 	 data_3116_en;   
   wire 	 data_1500_en;   
   wire 	 srcaddr_3116_en;
   wire 	 srcaddr_1500_en;
   wire [2:0] 	 rxi_assemble_cnt_next; // Next value of the assembly counter
   wire [2:0] 	 rxi_assemble_cnt_inc;  // Incremented value of the assembly counter
   wire 	 rxi_assemble_cnt_max;  // Maximum value of the counter 
   wire 	 burst_tran;            // detected burst transaction
   wire [AW-1:0] dstaddr_inc;           // Incremented value of burst transaction dstaddr
   wire [AW-1:0] dstaddr_in;            // Input to the next destination address FF
   wire 	 single_write;          // single write transaction
   wire 	 single_write_complete; // single write transaction is complete
   wire 	 read_jump;             // read transaction "jumps" over data part
   wire 	 tran_assembled;        // transaction is assembled
   wire [5:0] 	 comp_addr;
   wire [5:0] 	 chip_addr;
   wire [5:0] 	 comp_low;
   wire 	 carry_low;
   wire 	 zero_low;
   wire [5:0] 	 comp_high;
   wire 	 carry_high;
   wire 	 c0_match;
   wire 	 c1_match;
   wire 	 c2_match;
   wire 	 c3_match;
   wire 	 multicast_match;
   wire [AW-1:0] dstaddr;

   //##############################
   //# Assembled data and controls
   //##############################

   assign rxi_assembled_tran[14*LW-1:0]={
                                         srcaddr[7:0],{(LW){1'b0}},
				               srcaddr[23:8],
			                 data[7:0],srcaddr[31:24],
				                 data[23:8],
	                    dstaddr[3:0],datamode[1:0],write,access,data[31:24],
				                dstaddr[19:4],
			                 ctrlmode[3:0],dstaddr[31:20]
                                        };
 
   //####################
   //# Byte0 detection
   //####################

   always @ (posedge rxi_lclk)
     if(fifo_data_val & start_tran)
       begin
	  tran_byte0[LW-1:0]  <= fifo_data_reg[2*LW-1:LW]; 
	  ctrlmode[3:0]       <= fifo_data_reg[7:4];
       end

   //# byte0 decode
   //# bit[2] is the only one in use for now
   assign byte0_inc8   = ~tran_byte0[2];

   //##########################
   //# Transaction assembly
   //##########################

   //# destination address
   //# There is a special mode set in the Link Bypass Configuration Register
   //# which forces the chip to receive all of the transactions entering the chip
   //# In this case we just replace the external coordinates of the destination 
   //# address with the chip coordinates.
//   assign dstaddr[31:29] = cfg_extcomp_dis ? ext_yid_k[2:0] : dstaddr_int[31:29];
//   assign dstaddr[28:26] = cfg_extcomp_dis ? ext_xid_k[2:0] : dstaddr_int[28:26];
//   assign dstaddr[25:0]  = dstaddr_int[25:0];
   assign dstaddr[31:28] = cfg_extcomp_dis ? ext_yid_k[3:0] : dstaddr_int[31:28];
   assign dstaddr[25:22] = cfg_extcomp_dis ? ext_xid_k[3:0] : dstaddr_int[25:22];
   assign dstaddr[27:26] = dstaddr_int[27:26];
   assign dstaddr[21:0]  = dstaddr_int[21:0];

//   assign comp_addr[5:0]  = vertical_k ? {dstaddr[31:29],dstaddr[25:23]} : 
//                                         {dstaddr[28:26],dstaddr[22:20]} ;   

//   assign chip_addr[2:0]   = vertical_k ?  ext_yid_k[2:0] : ext_xid_k[2:0];
 
   //# destination address is updated on the beginning of burst transaction
   //# while datamode, write, access and control mode are unchanged
   assign dstaddr_inc[AW-1:0] = dstaddr[AW-1:0] + {{(AW-4){1'b0}},byte0_inc8,3'b000};

   assign dstaddr_in[31:28] = burst_tran ? dstaddr_inc[31:28] : fifo_data_reg[3:0];
   assign dstaddr_in[27:12] = burst_tran ? dstaddr_inc[27:12] : fifo_data_reg[2*LW-1:0];
   assign dstaddr_in[11:0]  = burst_tran ? dstaddr_inc[11:0]  : fifo_data_reg[2*LW-1:4];

   always @ (posedge rxi_lclk)
     if(fifo_data_val & (start_tran | burst_tran))
       dstaddr_int[31:28] <= dstaddr_in[31:28];

   always @ (posedge rxi_lclk)
     if(fifo_data_val & (dstaddr_2712_en | burst_tran))
       dstaddr_int[27:12] <= dstaddr_in[27:12];

   always @ (posedge rxi_lclk)
     if(fifo_data_val & (dstaddr_1100_en | burst_tran))
       dstaddr_int[11:0] <= dstaddr_in[11:0];
       
   //# data mode
   always @ (posedge rxi_lclk)
     if(fifo_data_val & datamode_en)
       datamode[1:0] <= fifo_data_reg[3:2];

   //# write
   always @ (posedge rxi_lclk)
     if(fifo_data_val & write_en)
       write <= fifo_data_reg[1];

   //# access
   always @ (posedge rxi_lclk)
     if(fifo_data_val & access_en)
       access <= fifo_data_reg[0];

   //# data
   always @ (posedge rxi_lclk)
     if(fifo_data_val & (data_3116_en | burst_tran))
       data[31:16] <= fifo_data_reg[2*LW-1:0];

   always @ (posedge rxi_lclk)
     if(fifo_data_val & data_1500_en)
       data[15:0] <= fifo_data_reg[2*LW-1:0];

   //# srcaddr
   always @ (posedge rxi_lclk)
     if(fifo_data_val & srcaddr_3116_en)
        srcaddr[31:16] <= fifo_data_reg[2*LW-1:0];

   always @ (posedge rxi_lclk)
     if(fifo_data_val & srcaddr_1500_en)
       srcaddr[15:0] <= fifo_data_reg[2*LW-1:0];
       

   //###################################################################
   //#            Order of the transaction fields in the fifo
   //#            -------------------------------------------
   //# Entry "n+6"                 srcaddr[15:0]
   //# Entry "n+5"		  srcaddr[31:16],
   //# Entry "n+4"                  data[15:0],
   //# Entry "n+3"                 data[31:16],
   //# Entry "n+2"  dstaddr[11:0],datamode[1:0],write,access,
   //# Entry "n+1"	          dstaddr[27:12],
   //# Entry "n"         byte0[7:0],ctrlmode[3:0],dstaddr[31:28],
   //#            --------------------------------------------
   //####################################################################

   assign dstaddr_2712_en  = (rxi_assemble_cnt[2:0] == 3'b001);
   assign dstaddr_1100_en  = (rxi_assemble_cnt[2:0] == 3'b010);
   assign datamode_en      = (rxi_assemble_cnt[2:0] == 3'b010);
   assign write_en         = (rxi_assemble_cnt[2:0] == 3'b010);
   assign access_en        = (rxi_assemble_cnt[2:0] == 3'b010);
   assign data_3116_en     = (rxi_assemble_cnt[2:0] == 3'b011);
   assign data_1500_en     = (rxi_assemble_cnt[2:0] == 3'b100);
   assign srcaddr_3116_en  = (rxi_assemble_cnt[2:0] == 3'b101);
   assign srcaddr_1500_en  = (rxi_assemble_cnt[2:0] == 3'b110);

   //# Assemble counter
   assign rxi_assemble_cnt_inc[2:0]  = rxi_assemble_cnt[2:0] + 3'b001;

   assign rxi_assemble_cnt_next[2:0] = burst_tran           ? 3'b100 :
				       tran_assembled       ? 3'b000 :
				       read_jump            ? 3'b101 :
				                              rxi_assemble_cnt_inc[2:0];
   always @ (posedge rxi_lclk or posedge reset)
     if (reset)
       rxi_assemble_cnt[2:0] <= 3'b000;
     else if(fifo_data_val)
       rxi_assemble_cnt[2:0] <= rxi_assemble_cnt_next[2:0];

   //# single write transaction completion
//   assign single_write = access & write & ~(&(datamode[1:0]));
   assign single_write = 1'b0; // no special treatment for single writes
   assign single_write_complete = single_write & (rxi_assemble_cnt[2:0] == 3'b100);

   //# read transaction "jumps" over data part of the counter
   //assign read_jump = ~fifo_data_reg[1] & (rxi_assemble_cnt[2:0] == 3'b010);
   //# read transaction "jump" feature is disabled because of the test-and-set inst
   assign read_jump = 1'b0;

   //# transaction completion
   assign rxi_assemble_cnt_max = (rxi_assemble_cnt[2:0] == 3'b110);
   assign tran_assembled = fifo_data_val & (single_write_complete | rxi_assemble_cnt_max);

   //# burst transaction detection
   assign burst_tran = (rxi_assemble_cnt[2:0] == 3'b000) & ~start_tran;

   //###########################################
   //# Secondary-FIFOs transaction distribution
   //###########################################

   always @ (posedge rxi_lclk or posedge reset)
     if(reset)
       rxi_cx_access <= 1'b0;
     else
       rxi_cx_access <= tran_assembled;

   assign rxi_c0_access   = (c0_match |  multicast_match) & rxi_cx_access;
   assign rxi_c1_access   = (c1_match & ~multicast_match) & rxi_cx_access;   
   assign rxi_c2_access   = (c2_match & ~multicast_match) & rxi_cx_access;   
   assign rxi_c3_access   = (c3_match & ~multicast_match) & rxi_cx_access;

   //# address preparation for comparison based on the links position (horiz or vert)
//   assign comp_addr[5:0]  = vertical_k ? {dstaddr[31:29],dstaddr[25:23]} : 
//                                         {dstaddr[28:26],dstaddr[22:20]} ;   
   assign comp_addr[5:0]  = vertical_k ? dstaddr[31:26] : dstaddr[25:20];   

//   assign chip_addr[2:0]   = vertical_k ?  ext_yid_k[2:0] : ext_xid_k[2:0];
   assign chip_addr[5:2] = vertical_k ?  ext_yid_k[3:0] : ext_xid_k[3:0];
   assign chip_addr[1:0] = 2'b11;
//   assign chip_addr_n[3:0] =~chip_addr[3:0];
   //# high comparison
//   assign {carry_high,comp_high[5:0]} = comp_addr[5:0] + {chip_addr_n[2:0],3'b101};
   assign {carry_high,comp_high[5:0]} = {1'b0,comp_addr[5:0]} - {1'b0,chip_addr[5:0]};
   //# channels matching
   assign c0_match =  carry_high; // chip addr is bigger
   assign c1_match =  (comp_addr[5:0] == {chip_addr[5:2],3'b01});//EQ   
   assign c2_match =  (comp_addr[5:0] == {chip_addr[5:2],3'b10});//EQ  
   assign c3_match = ~(c0_match | c1_match | c2_match);
   //# multicast tran detection
   assign multicast_match = write & 
			    (ctrlmode[1:0]==2'b11) & ~(datamode[1:0] == 2'b11);




endmodule // link_rxi_assembler
module link_rxi_buffer (/*AUTOARG*/
   // Outputs
   rxi_wait, rxi_assembled_tran, rxi_c0_access, rxi_c1_access,
   rxi_c2_access, rxi_c3_access,
   // Inputs
   reset, vertical_k, ext_yid_k, ext_xid_k, rxi_data, rxi_lclk,
   rxi_frame, rxi_rd, cfg_extcomp_dis, c0_fifo_full, c1_fifo_full,
   c2_fifo_full, c3_fifo_full
   );

   parameter LW   = `CFG_LW  ;//lvds tranceiver pairs per side
   parameter NC   = 32;// Number of cycles for save TXO-RXI "transaction interface"
   parameter FAD  = 5; // Number of bits to access all the entries (2^FAD + 1) > NC
   localparam MD = 1<<FAD;

   // #########
   // # INPUTS
   // #########

   input          reset;       //reset input
   input 	  vertical_k;  //specifies if block is vertical or horizontal
   input [3:0] 	  ext_yid_k;   //external y-id 
   input [3:0] 	  ext_xid_k;   //external x-id
   
   input [LW-1:0] rxi_data;      //Byte word
   input 	  rxi_lclk;      //receive clock (adjusted to the frame/data)
   input 	  rxi_frame;     //indicates new transmission
   
   input 	  rxi_rd;         // this is read transactions rxi_buffer
   input 	  cfg_extcomp_dis;// Disable external coordinates comparison
                                  // Every input transaction is received by the chip

   input 	  c0_fifo_full;
   input 	  c1_fifo_full;
   input 	  c2_fifo_full;
   input 	  c3_fifo_full;

   // ##########
   // # OUTPUTS
   // ##########

   output 	      rxi_wait;          //wait indicator   

   output [14*LW-1:0] rxi_assembled_tran; // data to be transferred to secondary fifos
   output             rxi_c0_access; //transfering to c0_fifo
   output 	      rxi_c1_access; //transfering to c1_fifo
   output 	      rxi_c2_access; //transfering to c2_fifo
   output 	      rxi_c3_access; //transfering to c3_fifo  
 
   /*AUTOINPUT*/
   /*AUTOWIRE*/

   // #########
   // # Regs
   // #########

   reg 		   rd_tran;
   reg [2*LW:0]    fifo_mem[MD-1:0];
   reg 		   frame_reg;
   reg 		   frame_reg_del;
   reg [LW-1:0]    data_even_reg;
   reg [LW-1:0]    data_odd_reg;
   reg [FAD:0] 	   wr_binary_pointer;
   reg [FAD:0] 	   rd_binary_pointer;
   reg 		   fifo_read;
   reg 		   rxi_wait;
   reg 		   start_tran;
   reg 		   fifo_data_val;
   reg [2*LW-1:0]  fifo_data_reg;

   // #########
   // # Wires
   // #########

   wire 	   my_tran;      // this transaction is dedicated to current rxi_buffer
   wire 	   new_tran;     // first cycle of the new transaction
   wire [2*LW:0]   fifo_data_in; // even and odd bytes combined into short words for fifo 
   wire [2*LW:0]   fifo_data_out;// output of the fifo
   wire [FAD:0]	   wr_binary_next; // next value of the write pointer
   wire [FAD:0]    rd_binary_next; // next value of the read pointer
   wire 	   fifo_write; // write into the fifo
   wire [FAD-1:0]  wr_addr; // write address of the fifo
   wire [FAD-1:0]  rd_addr; // read address of the fifo
   wire 	   fifo_empty; // indication of the empty fifo
   wire 	   stop_fifo_read; //one of the secondary fifos is full (stop reading)
   
   // ####################################################
   // #        Sample input transaction
   // # The positive edge FFs work all the time
   // # while the negative edge FFs can be disabled
   // # by the state of the detected frame (to save power)  
   // ####################################################     

   //# frame
   always @ (posedge rxi_lclk or posedge reset)
     if(reset)
       begin
	  frame_reg     <= 1'b0;
	  frame_reg_del <= 1'b0;
       end
     else
       begin
	  frame_reg     <= rxi_frame;
	  frame_reg_del <= frame_reg;
       end

   //# even bytes
   always @ (posedge rxi_lclk)
     data_even_reg[LW-1:0] <= rxi_data[LW-1:0];

   //# odd bytes
   always @ (negedge rxi_lclk)
     data_odd_reg[LW-1:0] <= rxi_data[LW-1:0];

   //##################################################
   //# We should differentiate between read and write
   //# transactions since link_rxi_buffer can accept
   //# the transactions of one type only.
   //# The indication of the type of the transaction
   //# is sent in the byte0 of the transaction.
   //##################################################

   assign my_tran = ~(rd_tran ^ rxi_rd);
   always @ (posedge rxi_lclk)
     if(~frame_reg)            //will stop sampling when byte0 is received
       rd_tran <= rxi_data[7];

   //# frame rising edge detection
   assign new_tran = my_tran & frame_reg & ~frame_reg_del;

   //# bytes packaging into short words + new transaction indication
   assign fifo_data_in[2*LW:0] = {new_tran,data_even_reg[LW-1:0],data_odd_reg[LW-1:0]};

   //###############################################################################
   //#          Wait indication to the transmitter
   //# When one of the secondary fifos becomes full we send wait indication 
   //# to the transmitter.
   //# There is some uncertainty regarding how long it will take for the wait 
   //# control to stop the transmitter (we have synchronization on the way, 
   //# which may cause +/-1 cycle of uncertainty).
   //# Our main fifo on the input port of the receiver is robust enough
   //# (has enough entries) to receive all of the transactions sent during the
   //# time of "wait traveling" without loosing any information.
   //# But the uncertainty mentioned above forces us to start from empty fifo
   //# every time after wait indication is raised in order to ensure that 
   //# the number of available entries won't be reduced.            
   //###############################################################################

   assign stop_fifo_read = c0_fifo_full | c1_fifo_full | c2_fifo_full | c3_fifo_full;

   always @ (posedge rxi_lclk or posedge reset)
     if(reset)
       rxi_wait <= 1'b0;
     else if(stop_fifo_read)
       rxi_wait <= 1'b1;
     else if(fifo_empty)
       rxi_wait <= 1'b0;

   //##################################
   //#   Input FIFO of the receiver
   //##################################

   always @ (posedge rxi_lclk)
     if (fifo_write)
       fifo_mem[wr_addr[FAD-1:0]] <= fifo_data_in[2*LW:0];

   //# Read from fifo
   assign fifo_data_out[2*LW:0] = fifo_mem[rd_addr[FAD-1:0]];

   //# Since the size of the FIFO is parametrized I prefer to sample the output
   //# data to prevent timing issues for the big number of entries (big mux on read)
   //# This shouldn't add any performance loss just latency increase

   always @ (posedge rxi_lclk or posedge reset)
     if(reset)
       start_tran  <= 1'b0;
     else if(fifo_read)
       start_tran  <= fifo_data_out[2*LW];
 
   always @ (posedge rxi_lclk)
     if(fifo_read)
       fifo_data_reg[2*LW-1:0] <= fifo_data_out[2*LW-1:0];

   always @ (posedge rxi_lclk or posedge reset)
     if(reset)
       fifo_data_val <= 1'b0;
     else
       fifo_data_val <= fifo_read;

   //#####################################################################
   //#                  FIFO Write State Machine
   //# !!!
   //# This FIFO will write the data in every time the FRAME IS HIGH and
   //# INDEPENDENT of the read out of the FIFO "frequency"
   //# !!!
   //# When the data cannot be read out of the FIFO, the indication will
   //# be sent to the transmitter to stop sending new transactions and the
   //# frame signal will be deasserted.
   //# The number of entries in the FIFO sould be big enough to receive
   //# all of the transactions sent by the transmitter in that case.
   //######################################################################

   assign fifo_write = my_tran & frame_reg;
   
   always @(posedge rxi_lclk or posedge reset)
     if(reset)
       wr_binary_pointer[FAD:0]     <= {(FAD+1){1'b0}};
     else if(fifo_write)
       wr_binary_pointer[FAD:0]     <= wr_binary_next[FAD:0];	  

   assign wr_addr[FAD-1:0]       = wr_binary_pointer[FAD-1:0];
   assign wr_binary_next[FAD:0]  = wr_binary_pointer[FAD:0] + {{(FAD){1'b0}},fifo_write};

   //#############################
   //# FIFO Read State Machine
   //#############################
   
   always @(posedge rxi_lclk or posedge reset)
     if(reset)
       fifo_read <= 1'b0;
     else
       fifo_read <= ~(fifo_empty | stop_fifo_read);

   always @(posedge rxi_lclk or posedge reset)
     if(reset)
       rd_binary_pointer[FAD:0]  <= {(FAD+1){1'b0}};
     else if(fifo_read)
       rd_binary_pointer[FAD:0]  <= rd_binary_next[FAD:0];	  

   assign rd_addr[FAD-1:0]       = rd_binary_pointer[FAD-1:0];
   assign rd_binary_next[FAD:0]  = rd_binary_pointer[FAD:0] + {{(FAD){1'b0}},fifo_read};

   assign fifo_empty = (rd_binary_next[FAD:0] == wr_binary_next[FAD:0]);

   //########################################
   //# Transaction assembly and distribution
   //########################################

   link_rxi_assembler link_rxi_assembler(/*AUTOINST*/
					 // Outputs
					 .rxi_assembled_tran	(rxi_assembled_tran[14*LW-1:0]),
					 .rxi_c0_access		(rxi_c0_access),
					 .rxi_c1_access		(rxi_c1_access),
					 .rxi_c2_access		(rxi_c2_access),
					 .rxi_c3_access		(rxi_c3_access),
					 // Inputs
					 .reset			(reset),
					 .rxi_lclk		(rxi_lclk),
					 .vertical_k		(vertical_k),
					 .ext_yid_k		(ext_yid_k[3:0]),
					 .ext_xid_k		(ext_xid_k[3:0]),
					 .fifo_data_reg		(fifo_data_reg[2*LW-1:0]),
					 .fifo_data_val		(fifo_data_val),
					 .start_tran		(start_tran),
					 .cfg_extcomp_dis	(cfg_extcomp_dis));

   
endmodule // link_rxi_buffer
module link_rxi_channel (/*AUTOARG*/
   // Outputs
   fifo_full_rlc, rdmesh_tran_out, rdmesh_frame_out,
   // Inputs
   reset, cclk, cclk_en, rxi_lclk, cfg_extcomp_dis,
   rxi_assembled_tran_rlc, fifo_access_rlc, rdmesh_wait_in
   );

   parameter LW    = `CFG_LW;//lvds tranceiver pairs per side
   
   //#########
   //# INPUTS
   //#########

   input             reset;   //reset input
   input 	     cclk;    //core clock
   input 	     cclk_en; // clock enable 
   input 	     rxi_lclk;//receiver link clock
   input 	     cfg_extcomp_dis;// Disable external coordinates comparison
                                     // Every input transaction is received by the chip

   input [14*LW-1:0] rxi_assembled_tran_rlc; // assembled data from the main fifo
   input 	     fifo_access_rlc;        // fifo is accessed

   input 	     rdmesh_wait_in; //wait indication from rdmesh
  
   //##########
   //# OUTPUTS
   //##########
   output 	  fifo_full_rlc;//fifo full push back indicator

   //# transaction to rdmesh
   output [2*LW-1:0] rdmesh_tran_out;  // transaction data
   output 	     rdmesh_frame_out; // core frame

   /*AUTOINPUT*/
   /*AUTOWIRE*/

  

endmodule // link_rxi_channel
module link_rxi_ctrl(/*AUTOARG*/
   // Outputs
   lclk,
   // Inputs
   io_lclk, rxi_cfg_reg
   );

   parameter DW = `CFG_DW;
   
   
   //Input clock
   input           io_lclk;    //link clock from IO
   input [DW-1:0]  rxi_cfg_reg;//used to deskew clock input

   //Should we have a monitor pin for locking the timing?
   
   
   //Delay Control word
   //1 for rise
   //1 for fall
   
   ///Output clocks to reciever block
  
   output  lclk;   //buffered clock without delay
   


   //Need to insert delay elements here
   //How to insert delay with cts?
   
   assign lclk   =  io_lclk;
  
   
   
endmodule // link_clock


//#############################################
//# This block is a "common" channel for both
//# mesh (multicast) and emesh transactions
//#############################################
module link_rxi_double_channel (/*AUTOARG*/
   // Outputs
   fifo_full_rlc, emesh_tran_out, emesh_frame_out, mesh_access_out,
   mesh_write_out, mesh_dstaddr_out, mesh_srcaddr_out, mesh_data_out,
   mesh_datamode_out, mesh_ctrlmode_out,
   // Inputs
   reset, cclk, cclk_en, ext_yid_k, ext_xid_k, rxi_lclk, who_am_i,
   cfg_extcomp_dis, rxi_assembled_tran_rlc, fifo_access_rlc,
   emesh_wait_in, mesh_wait_in
   );

   parameter LW   = `CFG_LW;//lvds tranceiver pairs per side
   parameter DW   = `CFG_DW;//data width  
   parameter AW   = `CFG_AW;//address width
  
   //#########
   //# INPUTS
   //#########

   input             reset;   //reset input
   input 	     cclk;    //core clock
   input 	     cclk_en; // clock enable 
   input [3:0] 	     ext_yid_k;//external y-id 
   input [3:0] 	     ext_xid_k;//external x-id
   input 	     rxi_lclk;//receiver link clock
   input [3:0] 	     who_am_i;// specifies what link is that (north,east,south,west)
   input 	     cfg_extcomp_dis;// Disable external coordinates comparison
                                     // Every input transaction is received by the chip

   input [14*LW-1:0] rxi_assembled_tran_rlc; // assembled data from the main fifo
   input 	     fifo_access_rlc;  // fifo is accessed 

   input 	     emesh_wait_in; //wait indication from emesh
   input 	     mesh_wait_in;  //wait indication from mesh

   //##########
   //# OUTPUTS
   //##########
   output 	     fifo_full_rlc;//fifo full push back indicator

   //# transaction to the emesh (transactions coming out off the chip)
   output [2*LW-1:0] emesh_tran_out;  // transaction data
   output 	     emesh_frame_out; // core frame

   //# transaction to the mesh 
   output 	     mesh_access_out;  // access control to the mesh
   output 	     mesh_write_out;   // write control to the mesh
   output [AW-1:0]   mesh_dstaddr_out; // destination address to the mesh
   output [AW-1:0]   mesh_srcaddr_out; // source address to the mesh
   output [DW-1:0]   mesh_data_out;    // data to the mesh
   output [1:0]      mesh_datamode_out;// data mode to the mesh 
   output [3:0]      mesh_ctrlmode_out;// ctrl mode to the mesh

   /*AUTOINPUT*/
   /*AUTOWIRE*/
   // Beginning of automatic wires (for undeclared instantiated-module outputs)
   wire			access;			// From link_rxi_mesh_launcher of link_rxi_mesh_launcher.v
   wire [3:0]		ctrlmode;		// From link_rxi_mesh_launcher of link_rxi_mesh_launcher.v
   wire [DW-1:0]	data;			// From link_rxi_mesh_launcher of link_rxi_mesh_launcher.v
   wire [1:0]		datamode;		// From link_rxi_mesh_launcher of link_rxi_mesh_launcher.v
   wire [AW-1:0]	dstaddr;		// From link_rxi_mesh_launcher of link_rxi_mesh_launcher.v
   wire			emesh_tran_dis;		// From link_rxi_mesh_launcher of link_rxi_mesh_launcher.v
   wire			fifo_empty;		// From link_rxi_fifo of link_rxi_fifo.v
   wire [14*LW-1:0]	fifo_tran_out;		// From link_rxi_fifo of link_rxi_fifo.v
   wire			mesh_fifo_read;		// From link_rxi_mesh_launcher of link_rxi_mesh_launcher.v
   wire [AW-1:0]	srcaddr;		// From link_rxi_mesh_launcher of link_rxi_mesh_launcher.v
   wire			write;			// From link_rxi_mesh_launcher of link_rxi_mesh_launcher.v
   // End of automatics

   // #########
   // # WIRES
   // #########
   wire     fifo_read;
   wire     emesh_fifo_empty;

   //#########
   //# FIFO
   //#########
   assign fifo_read       = mesh_fifo_read;
                         
   link_rxi_fifo link_rxi_fifo (/*AUTOINST*/
				// Outputs
				.fifo_full_rlc	(fifo_full_rlc),
				.fifo_tran_out	(fifo_tran_out[14*LW-1:0]),
				.fifo_empty	(fifo_empty),
				// Inputs
				.reset		(reset),
				.cclk		(cclk),
				.cclk_en	(cclk_en),
				.rxi_lclk	(rxi_lclk),
				.rxi_assembled_tran_rlc(rxi_assembled_tran_rlc[14*LW-1:0]),
				.fifo_access_rlc(fifo_access_rlc),
				.fifo_read	(fifo_read));

  
   //###################################
   //# Transaction Launcher to Mesh
   //###################################

   link_rxi_mesh_launcher link_rxi_mesh_launcher(/*AUTOINST*/
						 // Outputs
						 .mesh_fifo_read	(mesh_fifo_read),
						 .emesh_tran_dis	(emesh_tran_dis),
						 .access		(access),
						 .write			(write),
						 .datamode		(datamode[1:0]),
						 .ctrlmode		(ctrlmode[3:0]),
						 .data			(data[DW-1:0]),
						 .dstaddr		(dstaddr[AW-1:0]),
						 .srcaddr		(srcaddr[AW-1:0]),
						 // Inputs
						 .ext_yid_k		(ext_yid_k[3:0]),
						 .ext_xid_k		(ext_xid_k[3:0]),
						 .who_am_i		(who_am_i[3:0]),
						 .cfg_extcomp_dis	(cfg_extcomp_dis),
						 .fifo_tran_out		(fifo_tran_out[14*LW-1:0]),
						 .fifo_empty		(fifo_empty),
						 .mesh_wait_in		(mesh_wait_in));

 

   //##################################
   //#    Interface with mesh
   //# on output transactions only
   //# * input from the mesh is driven
   //# by a diferent block
   //##################################

   /* e16_mesh_interface AUTO_TEMPLATE (
                                    .clk               (cclk),
                                    .clk_en            (cclk_en),
 				    .access_in	       (1'b0),
				    .write_in	       (1'b0),
				    .datamode_in       (2'b00),
				    .ctrlmode_in       (4'b0000),
				    .data_in	       ({(DW){1'b0}}),
				    .dstaddr_in	       ({(AW){1'b0}}),
				    .srcaddr_in	       ({(AW){1'b0}}),
                                    .wait_int          (1'b0),
				    .emesh_core_wait   (1'b0),
				    .emesh_core_clk_en ({(11){1'b1}}),
				    .emesh_tran_sel    (1'b0),
                                    .wait_in           (mesh_wait_in),
                                    .\(.*\)_reg        (),
                                    .wait_out          (),
                                    .\(.*\)_out        (mesh_\1_out[]),
                                );
    */
   e16_mesh_interface mesh_interface(/*AUTOINST*/
				     // Outputs
				     .wait_out		(),		 // Templated
				     .access_out	(mesh_access_out), // Templated
				     .write_out		(mesh_write_out), // Templated
				     .datamode_out	(mesh_datamode_out[1:0]), // Templated
				     .ctrlmode_out	(mesh_ctrlmode_out[3:0]), // Templated
				     .data_out		(mesh_data_out[DW-1:0]), // Templated
				     .dstaddr_out	(mesh_dstaddr_out[AW-1:0]), // Templated
				     .srcaddr_out	(mesh_srcaddr_out[AW-1:0]), // Templated
				     .access_reg	(),		 // Templated
				     .write_reg		(),		 // Templated
				     .datamode_reg	(),		 // Templated
				     .ctrlmode_reg	(),		 // Templated
				     .data_reg		(),		 // Templated
				     .dstaddr_reg	(),		 // Templated
				     .srcaddr_reg	(),		 // Templated
				     // Inputs
				     .clk		(cclk),		 // Templated
				     .clk_en		(cclk_en),	 // Templated
				     .reset		(reset),
				     .wait_in		(mesh_wait_in),	 // Templated
				     .access_in		(1'b0),		 // Templated
				     .write_in		(1'b0),		 // Templated
				     .datamode_in	(2'b00),	 // Templated
				     .ctrlmode_in	(4'b0000),	 // Templated
				     .data_in		({(DW){1'b0}}),	 // Templated
				     .dstaddr_in	({(AW){1'b0}}),	 // Templated
				     .srcaddr_in	({(AW){1'b0}}),	 // Templated
				     .wait_int		(1'b0),		 // Templated
				     .access		(access),
				     .write		(write),
				     .datamode		(datamode[1:0]),
				     .ctrlmode		(ctrlmode[3:0]),
				     .data		(data[DW-1:0]),
				     .dstaddr		(dstaddr[AW-1:0]),
				     .srcaddr		(srcaddr[AW-1:0]));


endmodule // link_rxi_double_channel

//##############################################################################
//# 
//# This is a FOUR entries (FAD=2) receiver FIFO with the main function of
//# synchronization between RXI link clock domain and core clock domain
//# It seems that for the FIFO to function without "build in" push back
//# we will need at least THREE entries, so choosing FOUR entries puts us
//# in a safer position.
//#
//# * This FIFO will function even with a single entry (with some modifications)
//#   but if the number of entries is not sufficient for the synchronization
//#   the "build in" push back will be driven on every new write control.
//#
//################################################################################
 
module link_rxi_fifo (/*AUTOARG*/
   // Outputs
   fifo_full_rlc, fifo_tran_out, fifo_empty,
   // Inputs
   reset, cclk, cclk_en, rxi_lclk, rxi_assembled_tran_rlc,
   fifo_access_rlc, fifo_read
   );

   parameter LW    = `CFG_LW;//lvds tranceiver pairs per side
   parameter FAD   = 2; // Number of bits to access all the entries 
   localparam MD = 1<<FAD;
   
   //#########
   //# INPUTS
   //#########

   input          reset;   //reset input
   input 	  cclk;    //core clock
   input 	  cclk_en; // clock enable 
   input 	  rxi_lclk;//receiver link clock

   input [14*LW-1:0] rxi_assembled_tran_rlc; // assembled data from the main fifo
   input 	     fifo_access_rlc;        // fifo is accessed
   //# from the launcher
   input 	     fifo_read;
   //##########
   //# OUTPUTS
   //##########

   output 	     fifo_full_rlc;//fifo full push back indicator
   //# to the launcher
   output [14*LW-1:0] fifo_tran_out;
   output 	      fifo_empty;

   //##########
   //# REGS
   //##########

   reg [14*LW-1:0] fifo_mem[MD-1:0];
   reg [FAD:0] 	   wr_binary_pointer_rlc;
   reg [FAD:0] 	   wr_gray_pointer_rlc;
   reg 		   fifo_full_rlc;

   reg [FAD:0] 	   rd_binary_pointer;
   reg [FAD:0] 	   rd_gray_pointer;
   reg 		   fifo_empty;

   //#########
   //# WIRES
   //#########

   wire 	      wr_write_rlc; // FIFO write control
   wire [FAD-1:0]     wr_addr_rlc;
   wire [FAD:0]       wr_binary_next_rlc;
   wire [FAD:0]       wr_gray_next_rlc;
   wire 	      fifo_full_next_rlc;
   wire [FAD:0]       rd_gray_pointer_rlc;

   wire [FAD-1:0]     rd_addr;
   wire [FAD:0]       rd_binary_next;
   wire [FAD:0]       rd_gray_next;
   wire 	      fifo_empty_next;
   wire [FAD:0]       wr_gray_pointer;

   /*AUTOWIRE*/
   /*AUTOINPUT*/
  
   //##################################################################
   //#              Write control generation:
   //#
   //# FIFO is being written according to the state of fifo_access_rlc
   //# control driven by main fifo and independent on the current
   //# state of the FIFO.
   //# We do mask this control with fifo full signal but this mask
   //# is really redundant.
   //# The reason for that is the following:
   //# The FASTEST THROUGHPUT the transaction can be dispatched from
   //# the main fifo here is ONE TRANSACTION IN EVERY FOUR CYCLES.
   //# FIFO full indication is sent back on the first cycle after
   //# receiving the transaction causing the fifo to be full.
   //# This indication is sampled two more times in the main fifo
   //# and then prevents new transaction to be dispatched.
   //# So it takes THREE CYCLES to stop new transaction versus
   //# FOUR CYCLES to dispatch new one and therefore we are save.
   //####################################################################
   
   assign wr_write_rlc = fifo_access_rlc & ~fifo_full_rlc;

   //#################################
   //# FIFO data
   //#################################
 
   //# Write
   always @ (posedge rxi_lclk)
     if (wr_write_rlc)
       fifo_mem[wr_addr_rlc[FAD-1:0]] <= rxi_assembled_tran_rlc[14*LW-1:0];
   
   //# Read (for dispatch)
   assign fifo_tran_out[14*LW-1:0] = fifo_mem[rd_addr[FAD-1:0]];

   //#####################################
   //# FIFO Write State Machine
   //#####################################

   //# While for the actual address calculation we use [FAD-1:0] bits only,
   //# the bit FAD of the counter is needed in order to distinguish
   //# between the fifo entry currently being written and the one
   //# written in the previous "round" (FAD is a carry-out bit and is
   //# switched every "round")
   always @(posedge rxi_lclk or posedge reset)
     if(reset)
       begin
	  wr_binary_pointer_rlc[FAD:0] <= {(FAD+1){1'b0}};
	  wr_gray_pointer_rlc[FAD:0]   <= {(FAD+1){1'b0}};
       end
     else if(wr_write_rlc)
       begin
	  wr_binary_pointer_rlc[FAD:0] <= wr_binary_next_rlc[FAD:0];	  
	  wr_gray_pointer_rlc[FAD:0]   <= wr_gray_next_rlc[FAD:0];	  
       end	  

   assign wr_addr_rlc[FAD-1:0]       = wr_binary_pointer_rlc[FAD-1:0];
   assign wr_binary_next_rlc[FAD:0]  = wr_binary_pointer_rlc[FAD:0] + 
				       {{(FAD){1'b0}},wr_write_rlc};

   //# Gray Pointer Conversion (for more reliable synchronization)!
   assign wr_gray_next_rlc[FAD:0] = {1'b0,wr_binary_next_rlc[FAD:1]} ^ 
				    wr_binary_next_rlc[FAD:0];

   //# FIFO full indication
   assign fifo_full_next_rlc = 
			   (wr_gray_next_rlc[FAD-2:0] == rd_gray_pointer_rlc[FAD-2:0]) &
                           (wr_gray_next_rlc[FAD]     ^  rd_gray_pointer_rlc[FAD])     &
                           (wr_gray_next_rlc[FAD-1]   ^  rd_gray_pointer_rlc[FAD-1]);
			      
   always @ (posedge rxi_lclk or posedge reset)
     if(reset)
       fifo_full_rlc <= 1'b0;
     else 
       fifo_full_rlc <= fifo_full_next_rlc;

   //#############################
   //# FIFO Read State Machine
   //#############################
    
   always @(posedge cclk or posedge reset)
     if(reset)
       begin
	  rd_binary_pointer[FAD:0]  <= {(FAD+1){1'b0}};
	  rd_gray_pointer[FAD:0]    <= {(FAD+1){1'b0}};
       end
     else if(cclk_en)
       if(fifo_read)
	 begin
	    rd_binary_pointer[FAD:0]  <= rd_binary_next[FAD:0];	  
	    rd_gray_pointer[FAD:0]    <= rd_gray_next[FAD:0];	  
	 end

   assign rd_addr[FAD-1:0]       = rd_binary_pointer[FAD-1:0];
   assign rd_binary_next[FAD:0]  = rd_binary_pointer[FAD:0] + {{(FAD){1'b0}},fifo_read};

   //# Gray Pointer Conversion (for more reliable synchronization)!
   assign rd_gray_next[FAD:0]  = {1'b0,rd_binary_next[FAD:1]} ^ rd_binary_next[FAD:0];

   //# FIFO empty indication
   assign fifo_empty_next = (rd_gray_next[FAD:0]==wr_gray_pointer[FAD:0]);

   always @ (posedge cclk or posedge reset)
     if(reset)
       fifo_empty <= 1'b1;
     else if(cclk_en)
       fifo_empty <= fifo_empty_next;

   //####################################################
   //# Synchronization between rd/wr domains
   //####################################################

   e16_synchronizer #(.DW(FAD+1)) sync_rd2wr (.out	 (rd_gray_pointer_rlc[FAD:0]), 
                                          .in	 (rd_gray_pointer[FAD:0]), 
					  .clk	 (rxi_lclk),
					  .reset (reset));
   
   e16_synchronizer #(.DW(FAD+1)) sync_wr2rd (.out	 (wr_gray_pointer[FAD:0]), 
                                          .in	 (wr_gray_pointer_rlc[FAD:0]), 
					  .clk	 (cclk),
					  .reset (reset));
 


endmodule // link_rxi_fifo
module link_rxi_launcher (/*AUTOARG*/
   // Outputs
   fifo_read, emesh_tran, emesh_frame,
   // Inputs
   reset, cclk, cclk_en, fifo_tran_out, fifo_empty, emesh_wait_in
   );

   parameter LW   = `CFG_LW;//lvds tranceiver pairs per side
   
   //#########
   //# INPUTS
   //#########

   input             reset;   // reset input
   input 	     cclk;    // core clock
   input 	     cclk_en; // clock enable 

   //# from the fifo
   input [14*LW-1:0] fifo_tran_out; // transaction out of the fifo
   input 	     fifo_empty;    // fifo is empty
   //# from the emesh
   input 	     emesh_wait_in; // emesh wait indication 
 
   //##########
   //# OUTPUTS
   //##########
   //# to the fifo
   output 	     fifo_read; // read next entry
   //# to the emesh
   output [2*LW-1:0] emesh_tran;  // transaction data
   output 	     emesh_frame; // emesh frame 

   /*AUTOINPUT*/
   /*AUTOWIRE*/

   // #########
   // # REGS
   // #########

   reg [2:0]  launch_pointer;

   // #########
   // # WIRES
   // #########

   wire       last_tran;
   wire [2:0] launch_pointer_incr;
   wire [6:0] launch_sel;

   //################################
   //# next transaction read control
   //################################

   assign fifo_read = last_tran & ~emesh_wait_in;

   //############################################
   //# transaction launcher state machine
   //############################################
   assign last_tran = (launch_pointer[2:0] == 3'b110);
                        
   assign launch_pointer_incr[2:0] = last_tran ? 3'b000 : (launch_pointer[2:0] + 3'b001);

   always @ (posedge cclk or posedge reset)
     if(reset)
       launch_pointer[2:0] <= 3'b000;
     else if(cclk_en)
       if (~(fifo_empty | emesh_wait_in))
	 launch_pointer[2:0] <= launch_pointer_incr[2:0];

   assign launch_sel[0] = (launch_pointer[2:0] == 3'b000);
   assign launch_sel[1] = (launch_pointer[2:0] == 3'b001);
   assign launch_sel[2] = (launch_pointer[2:0] == 3'b010);
   assign launch_sel[3] = (launch_pointer[2:0] == 3'b011);
   assign launch_sel[4] = (launch_pointer[2:0] == 3'b100);
   assign launch_sel[5] = (launch_pointer[2:0] == 3'b101);
   assign launch_sel[6] = (launch_pointer[2:0] == 3'b110);

   //###########################
   //# frame and data selection
   //###########################
   
   assign emesh_frame  =  ~(fifo_empty | last_tran);

   e16_mux7 #(2*LW) mux7(// Outputs
		     .out (emesh_tran[2*LW-1:0]),
		     // Inputs
		     .in0 (fifo_tran_out[2*LW-1:0]),      .sel0 (launch_sel[0]),
		     .in1 (fifo_tran_out[4*LW-1:2*LW]),   .sel1 (launch_sel[1]),
		     .in2 (fifo_tran_out[6*LW-1:4*LW]),   .sel2 (launch_sel[2]),
		     .in3 (fifo_tran_out[8*LW-1:6*LW]),   .sel3 (launch_sel[3]),
		     .in4 (fifo_tran_out[10*LW-1:8*LW]),  .sel4 (launch_sel[4]),
		     .in5 (fifo_tran_out[12*LW-1:10*LW]), .sel5 (launch_sel[5]),
		     .in6 (fifo_tran_out[14*LW-1:12*LW]), .sel6 (launch_sel[6]));

endmodule // link_rxi_launcher
module link_rxi_mesh_launcher (/*AUTOARG*/
   // Outputs
   mesh_fifo_read, emesh_tran_dis, access, write, datamode, ctrlmode,
   data, dstaddr, srcaddr,
   // Inputs
   ext_yid_k, ext_xid_k, who_am_i, cfg_extcomp_dis, fifo_tran_out,
   fifo_empty, mesh_wait_in
   );

   parameter AW   = `CFG_AW  ;//address width
   parameter DW   = `CFG_DW  ;//data width  
   parameter LW   = `CFG_LW  ;//lvds tranceiver pairs per side

   //#########
   //# INPUTS
   //#########

   input [3:0] 	     ext_yid_k;//external y-id 
   input [3:0] 	     ext_xid_k;//external x-id
   input [3:0] 	     who_am_i;// specifies what link is that (north,east,south,west)
   input 	     cfg_extcomp_dis;// Disable external coordinates comparison
                                     // Every input transaction is received by the chip
   //# from the fifo
   input [14*LW-1:0] fifo_tran_out; // transaction out of the fifo
   input 	     fifo_empty;    // fifo is empty
   //# from the mesh
   input 	     mesh_wait_in; // wait indication from mesh

   //##########
   //# OUTPUTS
   //##########
   //# to the fifo
   output 	     mesh_fifo_read; // read next entry
   //# to prevent emesh launch
   output 	     emesh_tran_dis;
   //# to the mesh
   output 	     access;
   output 	     write;
   output [1:0]      datamode;
   output [3:0]      ctrlmode;   		    
   output [DW-1:0]   data;
   output [AW-1:0]   dstaddr;
   output [AW-1:0]   srcaddr;   

   /*AUTOINPUT*/
   /*AUTOWIRE*/

   // #########
   // # WIRES
   // #########
   wire [AW-1:0] srcaddr_int;
   wire [AW-1:0] srcaddr_multicast;
   wire 	 access_int;
   wire 	 multicast_match;

   wire [1:0] 	 srcaddr_int_ycoord;
   wire [1:0] 	 srcaddr_int_xcoord;

   wire [1:0] 	 north_srcaddr_int_ycoord;
   wire [1:0] 	 north_srcaddr_int_xcoord;
   wire [1:0] 	 east_srcaddr_int_ycoord;
   wire [1:0] 	 east_srcaddr_int_xcoord;
   wire [1:0] 	 south_srcaddr_int_ycoord;
   wire [1:0] 	 south_srcaddr_int_xcoord;
   wire [1:0] 	 west_srcaddr_int_ycoord;
   wire [1:0] 	 west_srcaddr_int_xcoord;

   wire [3:0] 	 dst_y_k;
   wire [3:0] 	 dst_x_k;
   wire 	 west_east_corner_tran;
   wire 	 north_south_corner_tran;
   wire [3:0] 	 corner_tran;
   wire 	 corner_tran_match;
   wire 	 mesh_tran_match;

   //# If valid mesh transaction is detected we should prevent the launch
   //# of this transaction on the emesh
   assign emesh_tran_dis = access;

   //# Valid mesh (multicast or not) transaction
   assign access = ~fifo_empty & access_int & 
		   (corner_tran_match | multicast_match | mesh_tran_match);

   //# Read next entry
   assign mesh_fifo_read = access & ~mesh_wait_in;

   //# Mesh transaction fields extraction
   assign ctrlmode[3:0]   =  fifo_tran_out[2*LW-1:2*LW-4];

   assign dstaddr[AW-1:0] = {fifo_tran_out[2*LW-5:0],
                             fifo_tran_out[4*LW-1:2*LW],
                             fifo_tran_out[6*LW-1:6*LW-4]};

   assign datamode[1:0]   =  fifo_tran_out[6*LW-5:6*LW-6];
   assign write           =  fifo_tran_out[6*LW-7]; 
   assign access_int      =  fifo_tran_out[5*LW]; 

   assign data[DW-1:0]    = {fifo_tran_out[5*LW-1:4*LW],
                             fifo_tran_out[8*LW-1:6*LW],
                             fifo_tran_out[10*LW-1:9*LW]};

   assign srcaddr_int[AW-1:0] = {fifo_tran_out[9*LW-1:8*LW],
                                 fifo_tran_out[12*LW-1:10*LW],
                                 fifo_tran_out[14*LW-1:13*LW]};

   //# Multicast transaction (there is no multicast transaction when no external compare)
   assign multicast_match = write & ~cfg_extcomp_dis &
			    (ctrlmode[1:0]==2'b11) & ~(datamode[1:0] == 2'b11);

   //# We rewrite the internal coordinates of every multicast transaction
   //# in the way it will propagate through all the scores in the system
   //# The new internal coordinates will be those of the attached to the
   //# current link score and are constant and different for every link
   //# !!! Since the transaction will propagate in all directions out of the
   //# !!! attached score, it will try to get out of the chip on the same
   //# !!! link, but it won't happen due to the external coordinate comparison
   //# !!! of the link transmitter.

   assign north_srcaddr_int_ycoord[1:0] = 2'b00;
   assign east_srcaddr_int_ycoord[1:0]  = 2'b00;
   assign south_srcaddr_int_ycoord[1:0] = 2'b11;
   assign west_srcaddr_int_ycoord[1:0]  = 2'b00;

   assign north_srcaddr_int_xcoord[1:0] = 2'b00;
   assign east_srcaddr_int_xcoord[1:0]  = 2'b11;
   assign south_srcaddr_int_xcoord[1:0] = 2'b00;
   assign west_srcaddr_int_xcoord[1:0]  = 2'b00;

   assign srcaddr_int_ycoord[1:0] = {(2){who_am_i[3]}} & north_srcaddr_int_ycoord[1:0]|
				    {(2){who_am_i[2]}} & east_srcaddr_int_ycoord[1:0] |
				    {(2){who_am_i[1]}} & south_srcaddr_int_ycoord[1:0]|
				    {(2){who_am_i[0]}} & west_srcaddr_int_ycoord[1:0];

   assign srcaddr_int_xcoord[1:0] = {(2){who_am_i[3]}} & north_srcaddr_int_xcoord[1:0]|
				    {(2){who_am_i[2]}} & east_srcaddr_int_xcoord[1:0] |
				    {(2){who_am_i[1]}} & south_srcaddr_int_xcoord[1:0]|
				    {(2){who_am_i[0]}} & west_srcaddr_int_xcoord[1:0];

   //# Modified source address
   //assign srcaddr_multicast[AW-1:0] = {srcaddr_int[31:26],1'b0,srcaddr_int_ycoord[1:0],
   //				                1'b0,srcaddr_int_xcoord[1:0],
   //                                    srcaddr_int[19:0]};

   assign srcaddr_multicast[AW-1:0] = {srcaddr_int[31:28],srcaddr_int_ycoord[1:0],
             		               srcaddr_int[25:22],srcaddr_int_xcoord[1:0],
                                       srcaddr_int[19:0]};

   assign srcaddr[AW-1:0] = multicast_match ? srcaddr_multicast[AW-1:0] : 
			                      srcaddr_int[AW-1:0];

   //# Mesh transaction for external corners detection
//   assign dst_y_k[2:0] = dstaddr[31:29];
//   assign dst_x_k[2:0] = dstaddr[28:26];
   assign dst_y_k[3:0] = dstaddr[31:28];
   assign dst_x_k[3:0] = dstaddr[25:22];

   assign west_east_corner_tran = ((dst_x_k[3:0] == ext_xid_k[3:0]) &
				  ~(dst_y_k[3:0] == ext_yid_k[3:0]));

   assign north_south_corner_tran = (~(dst_x_k[3:0] == ext_xid_k[3:0]) &
				      (dst_y_k[3:0] == ext_yid_k[3:0]));

   assign corner_tran[3:0] = {north_south_corner_tran, west_east_corner_tran,
                              north_south_corner_tran, west_east_corner_tran};

   assign corner_tran_match = ~cfg_extcomp_dis & (|(corner_tran[3:0] & who_am_i[3:0]));
   //# Regular Mesh transaction
   assign mesh_tran_match = cfg_extcomp_dis | 
			    (~multicast_match & ((dst_x_k[3:0] == ext_xid_k[3:0]) &
			                         (dst_y_k[3:0] == ext_yid_k[3:0])));

endmodule // link_rxi_mesh_launcher
//#############################################################
//# This block is a receiver of the read transactions only
//# Read transactions will enter the chip on rdmesh only
//#############################################################
module link_rxi_rd (/*AUTOARG*/
   // Outputs
   rxi_rd_wait, c0_rdmesh_frame_out, c0_rdmesh_tran_out,
   c1_rdmesh_frame_out, c1_rdmesh_tran_out, c2_rdmesh_frame_out,
   c2_rdmesh_tran_out, c3_rdmesh_frame_out, c3_rdmesh_tran_out,
   // Inputs
   reset, ext_yid_k, ext_xid_k, vertical_k, who_am_i, cfg_extcomp_dis,
   rxi_data, rxi_lclk, rxi_frame, c0_clk_in, c1_clk_in, c2_clk_in,
   c3_clk_in, c0_rdmesh_wait_in, c1_rdmesh_wait_in, c2_rdmesh_wait_in,
   c3_rdmesh_wait_in, c0_fifo_full_rlc, c1_fifo_full_rlc,
   c2_fifo_full_rlc, c3_fifo_full_rlc
   );

   parameter LW   = `CFG_LW;//lvds tranceiver pairs per side
		     
   // #########
   // # Inputs
   // #########

   input             reset;     // reset input
   input [3:0] 	     ext_yid_k; // external y-id 
   input [3:0] 	     ext_xid_k; // external x-id
   input             vertical_k;// specifies if block is vertical or horizontal
   input [3:0] 	     who_am_i;  // specifies what link is that (north,east,south,west)
   input 	     cfg_extcomp_dis;// Disable external coordinates comparison
                                     // Every input transaction is received by the chip
  
   input [LW-1:0]    rxi_data;  // Byte word
   input             rxi_lclk;  // receive clock (adjusted to the frame/data)
   input             rxi_frame; // indicates new transmission

   // # Sync clocks
   input             c0_clk_in; // clock of the core
   input             c1_clk_in; // clock of the core
   input             c2_clk_in; // clock of the core
   input             c3_clk_in; // clock of the core

   // # Wait indicators
   input             c0_rdmesh_wait_in; // wait
   input             c1_rdmesh_wait_in; // wait
   input             c2_rdmesh_wait_in; // wait
   input             c3_rdmesh_wait_in; // wait

   // ##########
   // # Outputs
   // ##########

   output 	     rxi_rd_wait;  //wait indicator for read transactions 

   // # RDMESH (any read transaction)
   output            c0_rdmesh_frame_out; // transaction frame
   output [2*LW-1:0] c0_rdmesh_tran_out;  // serialized transaction
   output            c1_rdmesh_frame_out; // transaction frame
   output [2*LW-1:0] c1_rdmesh_tran_out;  // serialized transaction
   output            c2_rdmesh_frame_out; // transaction frame
   output [2*LW-1:0] c2_rdmesh_tran_out;  // serialized transaction
   output            c3_rdmesh_frame_out; // transaction frame
   output [2*LW-1:0] c3_rdmesh_tran_out;  // serialized transaction

   /*AUTOINPUT*/
   // Beginning of automatic inputs (from unused autoinst inputs)
   input		c0_fifo_full_rlc;	// To link_rxi_buffer of link_rxi_buffer.v
   input		c1_fifo_full_rlc;	// To link_rxi_buffer of link_rxi_buffer.v
   input		c2_fifo_full_rlc;	// To link_rxi_buffer of link_rxi_buffer.v
   input		c3_fifo_full_rlc;	// To link_rxi_buffer of link_rxi_buffer.v
   // End of automatics
   /*AUTOWIRE*/
   // Beginning of automatic wires (for undeclared instantiated-module outputs)
   wire			c0_fifo_access_rlc;	// From link_rxi_buffer of link_rxi_buffer.v
   wire			c1_fifo_access_rlc;	// From link_rxi_buffer of link_rxi_buffer.v
   wire			c2_fifo_access_rlc;	// From link_rxi_buffer of link_rxi_buffer.v
   wire			c3_fifo_access_rlc;	// From link_rxi_buffer of link_rxi_buffer.v
   wire [14*LW-1:0]	rxi_assembled_tran_rlc;	// From link_rxi_buffer of link_rxi_buffer.v
   // End of automatics

   // ################################
   // # Receiver buffer instantiation
   // ################################

   /*link_rxi_buffer AUTO_TEMPLATE (.rxi_rd             (1'b1),
                                    .rxi_wait		(rxi_rd_wait),
                                    .reset		(reset),
                                    .vertical_k		(vertical_k),
                                    .ext_yid_k		(ext_yid_k[3:0]),
                                    .ext_xid_k		(ext_xid_k[3:0]),
                                    .rxi_data		(rxi_data[LW-1:0]),
				    .rxi_lclk		(rxi_lclk),
				    .rxi_frame		(rxi_frame),
                                    .rxi_\(.*\)_access  (\1_fifo_access_rlc),
                                    .\(.*\)             (\1_rlc[]),
				    .cfg_extcomp_dis	(cfg_extcomp_dis), 
                                        );
    */
   link_rxi_buffer link_rxi_buffer(/*AUTOINST*/
				   // Outputs
				   .rxi_wait		(rxi_rd_wait),	 // Templated
				   .rxi_assembled_tran	(rxi_assembled_tran_rlc[14*LW-1:0]), // Templated
				   .rxi_c0_access	(c0_fifo_access_rlc), // Templated
				   .rxi_c1_access	(c1_fifo_access_rlc), // Templated
				   .rxi_c2_access	(c2_fifo_access_rlc), // Templated
				   .rxi_c3_access	(c3_fifo_access_rlc), // Templated
				   // Inputs
				   .reset		(reset),	 // Templated
				   .vertical_k		(vertical_k),	 // Templated
				   .ext_yid_k		(ext_yid_k[3:0]), // Templated
				   .ext_xid_k		(ext_xid_k[3:0]), // Templated
				   .rxi_data		(rxi_data[LW-1:0]), // Templated
				   .rxi_lclk		(rxi_lclk),	 // Templated
				   .rxi_frame		(rxi_frame),	 // Templated
				   .rxi_rd		(1'b1),		 // Templated
				   .cfg_extcomp_dis	(cfg_extcomp_dis), // Templated
				   .c0_fifo_full	(c0_fifo_full_rlc), // Templated
				   .c1_fifo_full	(c1_fifo_full_rlc), // Templated
				   .c2_fifo_full	(c2_fifo_full_rlc), // Templated
				   .c3_fifo_full	(c3_fifo_full_rlc)); // Templated


endmodule // link_rxi_rd
module link_rxi_router (/*AUTOARG*/
   // Outputs
   fifo_read_cvre, read_out, write_out, dst_addr_out, src_addr_out,
   data_out, datamode_out, ctrlmode_out,
   // Inputs
   fifo_data_out_cvre, fifo_empty_cvre, wait_in
   );

   parameter AW  = 32;
   parameter MDW = 32;
   parameter FW  = 112;
   parameter XW  = 6;
   parameter YW  = 6;
   parameter ZW  = 6;
   parameter IAW = 20;//internal address width=20 bits=1MB
   
   /********************************************/
   /*FIFO Interface                            */
   /********************************************/
   input [FW-1:0]   fifo_data_out_cvre;
   input            fifo_empty_cvre;
   output           fifo_read_cvre;     //depends on empty and grants
   
   /********************************************/
   /*Transaction                               */
   /********************************************/
   //Mesh wait indicators
   input             wait_in;
   output            read_out;
   output            write_out;
   output [AW-1:0]   dst_addr_out;
   output [AW-1:0]   src_addr_out;
   output [MDW-1:0]  data_out;    
   output [1:0]      datamode_out;
   output [3:0]      ctrlmode_out;


 
   /********************************************/
   /*Wires                                     */
   /********************************************/
   wire           mesh_write_cvre;
   wire           mesh_read_cvre;
   wire [1:0]     mesh_datamode_cvre;
   wire [3:0]     mesh_ctrlmode_cvre;
   wire [7:0]     mesh_reserved_cvre;
   wire [MDW-1:0] mesh_data_cvre;
   wire [AW-1:0]  mesh_src_addr_cvre;
   wire [AW-1:0]  mesh_dst_addr_cvre;
   wire [1:0]     compare_addr;
   
   wire           request_cvre;
   
   /********************************************/
   /*Splitting Vector Into Components          */
   /********************************************/
   assign mesh_write_cvre           = fifo_data_out_cvre[0];
   assign mesh_read_cvre            = fifo_data_out_cvre[1];
   assign mesh_datamode_cvre[1:0]   = fifo_data_out_cvre[3:2];
   assign mesh_ctrlmode_cvre[3:0]   = fifo_data_out_cvre[7:4];
   assign mesh_reserved_cvre[7:0]   = fifo_data_out_cvre[15:8];
   assign mesh_data_cvre[MDW-1:0]   = fifo_data_out_cvre[47:16];
   assign mesh_dst_addr_cvre[AW-1:0]= fifo_data_out_cvre[79:48];
   assign mesh_src_addr_cvre[AW-1:0]= fifo_data_out_cvre[111:80];


   /********************************************/
   /*Address Decoding                          */
   /********************************************/

   /********************************************/
   /*Address Decoding                          */
   /********************************************/
   //Requests
   //How to 
   assign request_cvre         = ~fifo_empty_cvre;
   
   /********************************************/
   /*Only Doing FIFO read when granted         */
   /********************************************/
   assign fifo_read_cvre       = (request_cvre  & ~wait_in);
   
   
   /********************************************/
   /*DISTRIBUTING TO ALL AGENTS                */
   /********************************************/
   //turn on directions with read/write

   //READ
   assign read_out             = request_cvre & mesh_read_cvre;
   
   //WRITE
   assign write_out            = request_cvre & mesh_write_cvre;
   
   //Mesh transaction
   assign dst_addr_out[AW-1:0] = mesh_dst_addr_cvre[AW-1:0];
   assign src_addr_out[AW-1:0] = mesh_src_addr_cvre[AW-1:0];
   assign data_out[MDW-1:0]    = mesh_data_cvre[MDW-1:0];   
   assign datamode_out[1:0]    = mesh_datamode_cvre[1:0];
   assign ctrlmode_out[3:0]    = mesh_ctrlmode_cvre[3:0];


endmodule // link_rxi_router

     //#############################################################
//# This block is a receiver of the write transactions only
//# Write transactions will enter the chip on emesh and mesh
//# only but not on the rdmesh
//#############################################################
module link_rxi_wr(/*AUTOARG*/
   // Outputs
   rxi_wr_wait, c0_emesh_frame_out, c0_emesh_tran_out,
   c3_emesh_frame_out, c3_emesh_tran_out, c0_mesh_access_out,
   c0_mesh_write_out, c0_mesh_dstaddr_out, c0_mesh_srcaddr_out,
   c0_mesh_data_out, c0_mesh_datamode_out, c0_mesh_ctrlmode_out,
   c3_mesh_access_out, c3_mesh_write_out, c3_mesh_dstaddr_out,
   c3_mesh_srcaddr_out, c3_mesh_data_out, c3_mesh_datamode_out,
   c3_mesh_ctrlmode_out,
   // Inputs
   reset, ext_yid_k, ext_xid_k, vertical_k, who_am_i, cfg_extcomp_dis,
   rxi_data, rxi_lclk, rxi_frame, c0_clk_in, c3_clk_in,
   c0_emesh_wait_in, c3_emesh_wait_in, c0_mesh_wait_in,
   c3_mesh_wait_in
   );

   parameter LW   = `CFG_LW;//lvds tranceiver pairs per side
   parameter DW   = `CFG_DW;//data width  
   parameter AW   = `CFG_AW;//address width
		     
   // #########
   // # Inputs
   // #########

   input             reset;     // reset input
   input [3:0] 	     ext_yid_k; // external y-id 
   input [3:0] 	     ext_xid_k; // external x-id
   input             vertical_k;// specifies if block is vertical or horizontal
   input [3:0] 	     who_am_i;  // specifies what link is that (north,east,south,west)
   input 	     cfg_extcomp_dis;// Disable external coordinates comparison
                                     // Every input transaction is received by the chip
   input [LW-1:0]    rxi_data;  // Byte word
   input             rxi_lclk;  // receive clock (adjusted to the frame/data)
   input             rxi_frame; // indicates new transmission

   // # Sync clocks
   input             c0_clk_in; // clock of the core
   input             c3_clk_in; // clock of the core

   // # Wait indicators
   input             c0_emesh_wait_in;  // wait
   input             c3_emesh_wait_in;  // wait
   input 	     c0_mesh_wait_in;   // wait
   input 	     c3_mesh_wait_in;   // wait

   // ##########
   // # Outputs
   // ##########

   output 	     rxi_wr_wait;  //wait indicator for write transactions

   //# EMESH (write transactions with the off chip destination)
   output            c0_emesh_frame_out; // transaction frame
   output [2*LW-1:0] c0_emesh_tran_out;  // serialized transaction
   output            c3_emesh_frame_out; // transaction frame
   output [2*LW-1:0] c3_emesh_tran_out;  // serialized transaction
   // # MESH (write transactions internal and external corners)
   // # core0 
   output 	     c0_mesh_access_out;  // access control to the mesh
   output 	     c0_mesh_write_out;   // write control to the mesh
   output [AW-1:0]   c0_mesh_dstaddr_out; // destination address to the mesh
   output [AW-1:0]   c0_mesh_srcaddr_out; // source address to the mesh
   output [DW-1:0]   c0_mesh_data_out;    // data to the mesh
   output [1:0]      c0_mesh_datamode_out;// data mode to the mesh 
   output [3:0]      c0_mesh_ctrlmode_out;// ctrl mode to the mesh
   // # core3 
   output 	     c3_mesh_access_out;  // access control to the mesh
   output 	     c3_mesh_write_out;   // write control to the mesh
   output [AW-1:0]   c3_mesh_dstaddr_out; // destination address to the mesh
   output [AW-1:0]   c3_mesh_srcaddr_out; // source address to the mesh
   output [DW-1:0]   c3_mesh_data_out;    // data to the mesh
   output [1:0]      c3_mesh_datamode_out;// data mode to the mesh 
   output [3:0]      c3_mesh_ctrlmode_out;// ctrl mode to the mesh

   /*AUTOINPUT*/
   /*AUTOWIRE*/
   // Beginning of automatic wires (for undeclared instantiated-module outputs)
   wire			c0_fifo_access;		// From link_rxi_buffer of link_rxi_buffer.v
   wire			c0_fifo_full_rlc;	// From c0_link_rxi_double_channel of link_rxi_double_channel.v
   wire			c1_fifo_access;		// From link_rxi_buffer of link_rxi_buffer.v
   wire			c2_fifo_access;		// From link_rxi_buffer of link_rxi_buffer.v
   wire			c3_fifo_access;		// From link_rxi_buffer of link_rxi_buffer.v
   wire			c3_fifo_full_rlc;	// From c3_link_rxi_double_channel of link_rxi_double_channel.v
   wire [14*LW-1:0]	rxi_assembled_tran_rlc;	// From link_rxi_buffer of link_rxi_buffer.v
   // End of automatics

   //##########
   //# WIRES
   //##########

   wire    c0_fifo_access_rlc;
   wire    c3_fifo_access_rlc;


   // ################################
   // # Receiver buffer instantiation
   // ################################

   /*link_rxi_buffer AUTO_TEMPLATE (.rxi_rd             (1'b0),
                                    .rxi_wait		(rxi_wr_wait),
                                    .reset		(reset),
                                    .vertical_k		(vertical_k),
                                    .ext_yid_k		(ext_yid_k[3:0]),
                                    .ext_xid_k		(ext_xid_k[3:0]),
                                    .rxi_data		(rxi_data[LW-1:0]),
				    .rxi_lclk		(rxi_lclk),
				    .rxi_frame		(rxi_frame),
                                    .rxi_\(.*\)_access  (\1_fifo_access),
                                    .\(.*\)             (\1_rlc[]),
				    .cfg_extcomp_dis	(cfg_extcomp_dis), 
				    .c1_fifo_full	(1'b0), 
				    .c2_fifo_full	(1'b0), 
                                        );
    */
   link_rxi_buffer link_rxi_buffer(/*AUTOINST*/
				   // Outputs
				   .rxi_wait		(rxi_wr_wait),	 // Templated
				   .rxi_assembled_tran	(rxi_assembled_tran_rlc[14*LW-1:0]), // Templated
				   .rxi_c0_access	(c0_fifo_access), // Templated
				   .rxi_c1_access	(c1_fifo_access), // Templated
				   .rxi_c2_access	(c2_fifo_access), // Templated
				   .rxi_c3_access	(c3_fifo_access), // Templated
				   // Inputs
				   .reset		(reset),	 // Templated
				   .vertical_k		(vertical_k),	 // Templated
				   .ext_yid_k		(ext_yid_k[3:0]), // Templated
				   .ext_xid_k		(ext_xid_k[3:0]), // Templated
				   .rxi_data		(rxi_data[LW-1:0]), // Templated
				   .rxi_lclk		(rxi_lclk),	 // Templated
				   .rxi_frame		(rxi_frame),	 // Templated
				   .rxi_rd		(1'b0),		 // Templated
				   .cfg_extcomp_dis	(cfg_extcomp_dis), // Templated
				   .c0_fifo_full	(c0_fifo_full_rlc), // Templated
				   .c1_fifo_full	(1'b0),		 // Templated
				   .c2_fifo_full	(1'b0),		 // Templated
				   .c3_fifo_full	(c3_fifo_full_rlc)); // Templated

   // ################################################
   // # Receiver channels instantiation  
   // ################################################

   //# All the received transactions will be issued on channel0 or channel3 only
   assign c0_fifo_access_rlc = c0_fifo_access | c1_fifo_access;
   assign c3_fifo_access_rlc = c2_fifo_access | c3_fifo_access;

   /*link_rxi_double_channel AUTO_TEMPLATE (
                       .fifo_full_rlc   (@"(substring vl-cell-name 0 2)"_fifo_full_rlc),
                       .\(.*\)_out      (@"(substring vl-cell-name 0 2)"_\1_out[]),
                       .emesh_wait_in   (@"(substring vl-cell-name 0 2)"_emesh_wait_in),
                       .mesh_\(.*\)     (@"(substring vl-cell-name 0 2)"_mesh_\1[]),
		       .cclk	        (@"(substring vl-cell-name 0 2)"_clk_in),
                       .cclk_en         (1'b1),
                       .fifo_access_rlc (@"(substring vl-cell-name 0 2)"_fifo_access_rlc),
                       .mesh_fifo_access_rlc (mesh_fifo_access_rlc),
                                   );
    */

   //# channel 0 (emesh + mesh + mesh for multicast)
   link_rxi_double_channel c0_link_rxi_double_channel(/*AUTOINST*/
						      // Outputs
						      .fifo_full_rlc	(c0_fifo_full_rlc), // Templated
						      .emesh_tran_out	(c0_emesh_tran_out[2*LW-1:0]), // Templated
						      .emesh_frame_out	(c0_emesh_frame_out), // Templated
						      .mesh_access_out	(c0_mesh_access_out), // Templated
						      .mesh_write_out	(c0_mesh_write_out), // Templated
						      .mesh_dstaddr_out	(c0_mesh_dstaddr_out[AW-1:0]), // Templated
						      .mesh_srcaddr_out	(c0_mesh_srcaddr_out[AW-1:0]), // Templated
						      .mesh_data_out	(c0_mesh_data_out[DW-1:0]), // Templated
						      .mesh_datamode_out(c0_mesh_datamode_out[1:0]), // Templated
						      .mesh_ctrlmode_out(c0_mesh_ctrlmode_out[3:0]), // Templated
						      // Inputs
						      .reset		(reset),
						      .cclk		(c0_clk_in),	 // Templated
						      .cclk_en		(1'b1),		 // Templated
						      .ext_yid_k	(ext_yid_k[3:0]),
						      .ext_xid_k	(ext_xid_k[3:0]),
						      .rxi_lclk		(rxi_lclk),
						      .who_am_i		(who_am_i[3:0]),
						      .cfg_extcomp_dis	(cfg_extcomp_dis),
						      .rxi_assembled_tran_rlc(rxi_assembled_tran_rlc[14*LW-1:0]),
						      .fifo_access_rlc	(c0_fifo_access_rlc), // Templated
						      .emesh_wait_in	(c0_emesh_wait_in), // Templated
						      .mesh_wait_in	(c0_mesh_wait_in)); // Templated

   //# channel 3 (emesh + mesh)
   link_rxi_double_channel c3_link_rxi_double_channel(/*AUTOINST*/
						      // Outputs
						      .fifo_full_rlc	(c3_fifo_full_rlc), // Templated
						      .emesh_tran_out	(c3_emesh_tran_out[2*LW-1:0]), // Templated
						      .emesh_frame_out	(c3_emesh_frame_out), // Templated
						      .mesh_access_out	(c3_mesh_access_out), // Templated
						      .mesh_write_out	(c3_mesh_write_out), // Templated
						      .mesh_dstaddr_out	(c3_mesh_dstaddr_out[AW-1:0]), // Templated
						      .mesh_srcaddr_out	(c3_mesh_srcaddr_out[AW-1:0]), // Templated
						      .mesh_data_out	(c3_mesh_data_out[DW-1:0]), // Templated
						      .mesh_datamode_out(c3_mesh_datamode_out[1:0]), // Templated
						      .mesh_ctrlmode_out(c3_mesh_ctrlmode_out[3:0]), // Templated
						      // Inputs
						      .reset		(reset),
						      .cclk		(c3_clk_in),	 // Templated
						      .cclk_en		(1'b1),		 // Templated
						      .ext_yid_k	(ext_yid_k[3:0]),
						      .ext_xid_k	(ext_xid_k[3:0]),
						      .rxi_lclk		(rxi_lclk),
						      .who_am_i		(who_am_i[3:0]),
						      .cfg_extcomp_dis	(cfg_extcomp_dis),
						      .rxi_assembled_tran_rlc(rxi_assembled_tran_rlc[14*LW-1:0]),
						      .fifo_access_rlc	(c3_fifo_access_rlc), // Templated
						      .emesh_wait_in	(c3_emesh_wait_in), // Templated
						      .mesh_wait_in	(c3_mesh_wait_in)); // Templated
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
