aolofsson/oh/(commit log)

2014-11-06 Create combined reset (hw+sw) Added data select output for axi_slave mux Signal cleanup (gpio_data)
    [ecfg.v]
2014-11-19 eCfg: Renamed reset input to hw_reset, OR'd into ecfg_reset output. eCfg IP updated to match.
    [ecfg.v]
2014-11-24 Minor fixes for implementation.
    [eclock.v]
2014-12-12 Renamed file Converted all signals to lower case
2014-12-15 Verious silly compilation fixes, nothing to see here..
    [emmu.v, erx.v, erx_io.v, etx.v, etx_arbiter.v]
2014-12-15 Verilator inspired bug fixes -address width in elink -bus widths in ecfg -command file more generic
    [ecfg.v, elink.v]
2014-12-15 Wrong bus width (just cleanup..)
    [erx_protocol.v]
2014-12-15 Fixed renaming bug in e_tx_ack signal. (thanks verilator)
    [etx_arbiter.v]
2015-03-25 Massive checkin... -this may break already broken projects -creates a Verilog top level (instead of using Vivado block level design) -integrates mmy and mailbox (not completely integrated) -compiles.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
    [ecfg.v, eclock.v, elink.v, emaxi.v, emmu.v, erx.v, erx_disty.v, erx_io.v]
2015-03-25 Refactoring and fixing bugs... -back and forth with emmu, memory is now inside (for good) -renamed clocks in etx to clarify -updated logic in protocol and disty -updated clock module ...one more revi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
    [ecfg.v, eclock.v, elink.v, emmu.v, erx.v, erx_disty.v, etx.v, etx_arbiter.v]
2015-04-08 Fixing bus issue with datain/dataout signal Found in Vivado... Needed to connect up the wait signals properly on dataout/datain registers
    [ecfg.v, elink.v, erx.v, erx_io.v, etx.v, etx_io.v, etx_protocol.v]
2015-04-08 Fixing file permissions Verilog text files should not have execute permissions!
    [eclock.v, emaxi.v, esaxi.v, etx_io.v]
2015-04-09 Vivado run through -missed connections -mismatched bus widths -missing IP blocks -cleanup -proper DV starts tomorrow
    [ecfg.v, eclock.v, elink.v, emaxi.v, emmu.v, erx.v, erx_io.v, erx_protocol.v]
2015-04-11 Major cleanup, refactoring, and feature completion -adding clock bypass mode for esystx[12] -removing monitor feature on erx -remove loopback support from doc -add clock bypass mode for esysclk -shor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
    Now co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
    [ecfg.v, eclock.v, elink.v, emmu.v, erx.v, erx_disty.v, erx_io.v, esaxi.v]
2015-04-14 Fixed renaming bug..axi ready signal not working (would have been caught by verilator, time to lint...)
    [esaxi.v]
2015-04-14 Verilator lint cleanup ~10 real bugs -mostly name mismatches and bit range mistakes
    [ecfg.v, emaxi.v, emmu.v, erx.v, erx_io.v, erx_protocol.v, esaxi.v, etx.v]
2015-04-15 AXI bug fixes -First bug was a typo. Cursing AXI for making every signal look exactly the same at first glance. Not good use practice -Second bug was sloppy. (removed pipeline stage on write data by 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
    [emaxi.v, esaxi.v]
2015-04-15 Silly bug in access logic Looks like I was interrupt while coding..
    [etx_arbiter.v]
2015-04-15 Continued work to create clean design: -pll bypass for clocks (customer request) -adding dividers on all clocks (tx/cclk) -adding reset block (clearer) -using commong clock_divider block -need to cle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
    [clock_divider.v, ecfg.v, elink.v, esaxi.v, etx.v, etx_io.v]
2015-04-15 Fixed clock divider circuit -changed ecfg clock default values, elink default is now the PLL clock/128 coming out of reset -should work in any implementation? -still have to implement the Xilinx spec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
    [clock_divider.v, ecfg.v, eclock.v]
2015-04-15 Fixing startup issues in transmit path: -adding reset signals to synchronizer to solve startup issues -setting config in test bench for speedup, default reg config now correct -fix (my) stupid bug in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
    [clock_divider.v, ecfg.v, etx_arbiter.v]
2015-04-16 Adding experimental OSERDESE2 model Experimental model, dirty design Bits are coming out and frame looks good.. Will continue with RX and debugging tomorrow
2015-04-17 Added serial to parallel circuit + Xilinx BUFR
2015-04-17 Changing ESYSCLK definition (again.....) old implementation felt too "cutsy" this makes for a cleaner usage model (simple shift with param) also splitting out enable but, not making the CTIMER mistak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
    [clock_divider.v, ecfg.v, erx_io.v]
2015-04-17 Fixed testbench bug (copy paste, RX not enabled)...
    [emmu.v, erx.v, erx_io.v]
2015-04-17 Fixed odd/even copy past bug on DDR sampler
2015-04-18 Cleaning up licenses for consistency -All files still GPLv3 -Placed at the bottom of the file (I am tired of looking at them!)
2015-04-18 Clock divider fixup -changed to latest and hopefully final register config -fixed functional bugs (was broken..) -added xor for sensing change of clock frequency
    [clock_divider.v]
2015-04-18 ESAXI cleanup -widen address bus to 32 bits -blocking access to elink on ecfg access -fixing decoding for embox
    [esaxi.v]
2015-04-18 Fixed to fit with new register map
    [ecfg.v]
2015-04-21 Wrong port direction on output
    [memory_sp.v]
2015-04-21 Bug fix, missing "data hold" stage Hadn't realized that the data needed to be held Need to look at this logic again! For now going back to old logic
    [etx_arbiter.v]
2015-04-21 Bug fix, missing pipeline stage on read response -Apparantly old FIFO was not pipelined (IE data comes back same cycle). -Not knowing the Xilinx logic, I made it a regular one cycle pipeline memory b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
    [emaxi.v]
2015-04-22 Adding emesh to packet converters -getting tired of all the typing after all....
2015-04-23 Adding an emesh DMA
2015-04-23 Major upgrade -Adding DMA, EMMU, CFG -Removing redundant signals -Changing to packet interface
2015-04-23 Fixing enable/reset: -Removing enable from ISERDES, not healthy -Moving all logic to protocol block. (this is an IO block) -Removing tow redundant pipeline stages (check this??)
    [erx_io.v]
2015-04-23 Adding DMA source and changing interface -DMA added as a master driving out transactions (this is going to be great!!) -Changing to packet interface
2015-04-23 Major RX change: -renamed interfaces to rxwr,rxrd,rxrr (much simpler to remember for me) -packet interface change -removed wait signals from dataout field -added dma, emmu, mailbox, config register -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
2015-04-23 Adding DMA register to regmap
2015-04-24 Fixed floating net bug
    [erx_protocol.v]
2015-04-24 Adding reset to critical signals in pipe
    [erx_disty.v]
2015-04-24 Fifo read bug -fifo should be read when it's not empty and there is no wait pushback
    [erx.v]
2015-04-24 Fixed elink missind ID parameter
    [ecfg_if.v, elink.v]
2015-04-24 Bug fix, adding reset signal This will blocking when there is no clock at startup.
    [erx_protocol.v]
2015-04-24 MILESTONE: Design once again passes test New features: DMA MAILBOX directly in RX path TXMMU
2015-04-24 Adding RX/TX address remapping The MMU is a monster and may be too much Adding simple remapping modules Covers todays feature and then some 1.) Static remapping 2.) Addresss compression
    [erx_remap.v, etx_remap.v]
2015-04-25 Register write bug for new map -Need to block access if [15] is one (reserved for emmurx)
    [ecfg_rx.v]
2015-04-26 Fixing etx pipeline -Fixed one bug inserted during edits, causing double transactions -Added pipeline stall logic to all units
    [etx.v, etx_arbiter.v, etx_protocol.v]
2015-04-26 Bug fix: erx pipeline misalignment -access signal happens one signal after empty goes low to compensate for fifo data latency -verify that this is how the Xilinx FIFO works as well.
    [erx.v]
2015-04-27 Adding monitor for ememory in dv_elink.v -Dumps into emem.trace
2015-04-27 RX address remap bug fix -Used the wrong sub vector... (silly mistake)
    [erx_remap.v]
2015-04-27 MMU mi_write bug fix MMU should only be written when [15] of address is set (shares address space with other registers in TX/RX)
    [emmu.v]
2015-04-27 Bug fix. Fifo read delay not accounted for -Added valid signal to fifo
    [erx.v, etx.v, etx_arbiter.v]
2015-04-27 Added read watchdog timer -A read on transmit side initiates timer -Timer is reset when read request comes back (assumption last read requests starts timer..last return stops it)
    [ecfg_rx.v, elink.v, erx.v, erx_disty.v, etx.v, etx_arbiter.v]
2015-04-27 Added "timeout" to elink interface -Use as error interrupt? -Is there another method for checking error?
    [elink.v, erx.v, erx_disty.v]
2015-04-27 Adding timeout circuit
2015-04-27 Adding reset to synchronizer (cause there may not be a clock...)
    [emmu.v, etx.v, etx_arbiter.v, etx_protocol.v]
2015-04-28 Adding 2nd elink to dv env -The single link env wasn't giving enough coverage -This is also preparing for inserting the chip reference model...
2015-04-28 Removing filter for rxwr_access -Needed to enable simple mi_write interface on RX
2015-04-28 Fixing bug on 64 bit register write
    [ecfg_if.v]
2015-05-01 Adding Epiphany16 elink RTL implementation as reference This is pretty big, wonder if anybody will notice?
    Why am I doing this?
    Because the elink has been haunting us for years. This way we will finally have a "golden reference" simulator model for those who insist on designing their own elink protocol (aginst my recommendation). This is equivalent to having a "bfm-bus functional model" for AXI. The spec is nice, but it's always up for interpretation. We have had some issues with documenting the protocol corretly. While we will fix the documentation, please note that the source code and design verification environment will always be the golden version. This is after all "the silicon".
    For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
    [elink_e16_model.v]
2015-05-01 Updated register map and interface -Changed DMA descriptor locations -Changed colid/rowid -->chipd[11:0] (more consistant) -Added access column (R/W)
2015-05-01 Changed DMA interface to "packet style" -Packet format is really compact, a huge deal after all.. -Also commenting out content for now
2015-05-01 Added testmode to transmitter -pin driven testmode driven..b/c fpga designers often don't like software -and because it's really convenient, press a push button and see a pattern appear -removed prot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
    [etx_protocol.v]
2015-05-01 Created unified one clock modular confi for RX/TX -Solves clock domain crossing uglyness -Very nice and clean!! -Only compromise is that the RESET and CLOCK registers aren't readable
    [ecfg_if.v]
2015-05-01 Complete redesign of configuration register file -There is now only one clock domain crossing involved with the reg files/ All clock domain crossings use the same 104 bit wide async fifo! If it's bro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
    [ecfg_rx.v, ecfg_tx.v, elink.v, emmu.v, erx.v, etx.v, etx_arbiter.v]
2015-05-03 E16 model cleanup -fixing false error message -removed emesh_interface isntance (not needed..) -set floating inputs to zero
    [elink_e16_model.v]
2015-05-03 Fixing ecfg_clocks -Was missing clock connection -Adding ID to match only to the right transcations
    [elink.v]
2015-05-03 Clock/reset fixes -Making reset async -lclk_div4 always on (makes reset safer, not a big loss) -filtering non-matching transactions
2015-05-03 Fixed verilog syntax issue -Not sure what parameter couldn't be used directly here? -Works fine when parameter is assigned to wire.
    [ecfg_if.v]
2015-05-03 Cleanup -setting DMA access to zero for now -taking away wait for elink2 (messes up the access pattern) -fixing typo in register mape ERX
    [edma.v, etx_arbiter.v]
2015-05-04 Adding simple priority arbiter Yes it's simple, but youl should never have to rewrite this code For larger arbiters, too much risk of making a mistake... Arbitration mistakes aver nasty to find and n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
    [arbiter_priority.v]
2015-05-04 Clocks on during reset -Otherwise we can't do sync reset anywhere -glitch on exit from reset? Do we care? Everything is static -Need to check this again!
    [clock_divider.v]
2015-05-04 Making dma quiet until implemented
2015-05-04 Complete redesign -Following access,wait, packet pipeline format -Use a priority arbiter
    [etx_arbiter.v]
2015-05-04 Organization changes -dma with packet format -using the fifo_cdc block
2015-05-04 Filter the txwr access We don't want reset/clock transaction to propagate through etx!
2015-05-04 Separating rd/wr wait for pipeline stall
    [emmu.v]
2015-05-04 Separate rd/wr stalls
2015-05-04 Baking in the IO wait signal into rd/wr wait -Separate waits for rd/wr wait -Adding wait to protocol block as well -io_wait always goes through -using active frame signal to select/clear data for out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
2015-05-04 MILESTONE: Read/write works back and forth -Pipeline looks good, now need to test clk1>>clk2 and clk2>clk1 -Still not completely happy with reset (using async for now)
    [ecfg_if.v, ecfg_rx.v, ecfg_tx.v, elink.v, emailbox.v, erx.v, erx_disty.v, erx_io.v]
2015-05-06 Adding basic emehs transaction generator -Replace with DMA...
2015-05-11 Adding etx/erx core modules -Single clock domain -Super-light... -Need to be able to remove internal feature as well -(MMU/DMA should be optional but on by default..)
2015-05-12 Reorg cleanup -renamed disty for consistency (there is an arbiter there now) -adding missing ID to etx/erx -New org working!
    [erx.v, erx_arbiter.v, erx_core.v, etx.v]
2015-05-14 Complete redesign of erx -Giving up on ISERDES. No freaking proper documentaion and no open source simulation model. -Rewriting io module with primitives. -Looks like most of the logic disappears... 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
    [etx_io.v]
2015-05-14 Complete redesign of erx io logic -Building from primitives -Work in progress, not quite complete
    [erx_io.v]
2015-05-14 Complete redesign -junking the old logic -not needed with new IO approach
    [erx_protocol.v]
2015-05-14 Complete redesign -Communication with IO is with "packet format" -No need to invent a 64 bit format just for stupid OSERDES
    [etx_protocol.v]
2015-05-14 MILESTONE: read/write works with all new RX/TX IO logic! -Fixes issue with back to back transactions! -Read/writes work!! -Needs more verification/analysis...
    [etx_io.v]
2015-05-15 Adding reset hardware state machine -concept developed by Gunnar Hillerstrom (VHDL) -takes the driver out of the picture -some people will run this bare metal -more deterministic -cuts down on hw/sw 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
2015-05-15 Clock and reset integration -moving clock and reset outside basic elink -adding idelay reference clock -separate and synchronized reset for each domain -adding proper reset to fifo_cdc (per domain, n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
    [elink.v]
2015-05-15 Reset and clock cleanup -In the default mode we now have 7 input clocks to basic elink -This is too many, need to simplify, not reasonable! -But with all the knobs on the MMCM, performance will be gr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
    [erx.v, erx_fifo.v, erx_io.v, erx_protocol.v, etx.v, etx_fifo.v, etx_io.v, etx_protocol.v]
2015-05-15 Adding pulse_stretcher circuit -simple but powerful for syncing from fast to slow clock domains
2015-05-15 Adding reset to both sides of fifo
    [fifo_cdc.v]
2015-05-18 Converting to synchronous reset
    [ecfg_elink.v, ecfg_if.v, erx_cfg.v, erx_remap.v, etx_cfg.v, etx_io.v, etx_protocol.v]
2015-05-18 MILESTONE: Bursts working!!! -Fairly clean minimalist design -Complete redesign -Need to do random read/write testing to make sure -Speed?
    [erx_io.v, erx_protocol.v, etx_io.v, etx_protocol.v]
2015-05-20 Clean axi_elink module -Clocks included inside for easy integration -Another version might have the clocks and reset as inputs instead
    [axi_elink.v]
2015-05-20 Adding filtering to ecfg_if -Avoids garbage writing coming back to esaxi
    [ecfg_if.v]
2015-05-20 Adding readback on axi_elink -Another cludgy memory -Note that current esaxi doesn't support pushback so we have to hack the test to avoid read/write contention on this port.
2015-05-20 Fixing read response address -using `define from elink_regmap (ie 'D')
    [emaxi.v, esaxi.v, etx_arbiter.v]
2015-05-24 Making reset sync in emmu
    [edma.v, emmu.v]
2015-07-02 Fifo cleanup -Adding model (one source..) -generate for 104x32 for xilinx -making prog_full the default full indicator -bringing out almost_full for future use -fixing interface change in all modules
    [emailbox.v, fifo_cdc.v]
2015-08-07 README changes and various fixes
    [emmu.v]
2015-08-07 Removing DMA from transmit * Seems like a useless feature. Why autogenerate the transactions at the transmit side. This should always be done at the receive side to minimize bits moving across the li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
2015-08-07 Updating docs -clarifications -removing TX DMA
2015-08-14 Fixing mutual exclusive bug on receiver -When a read response is detected, there should be no spurious transactions to the RD/WR request fifos. -Move the "filter" backt to the erx_protocol block -Rem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
    [erx_arbiter.v, erx_core.v, erx_io.v, erx_protocol.v, erx_remap.v, etx_arbiter.v]
2015-08-14 Fixing wait issue -Removing the wait signal from the pipeline -Assumption is that the prog_full is used on fifo, allowing two entries to be captured in fifo. -May revisit this at some time...
    [erx_core.v, erx_remap.v, etx_protocol.v]
2015-08-24 Changing the receiver to use both frame signals
2015-09-11 Fixing Icarus compile error -multi dimensional parameters not working -trying with regs
    [erx_io.v]
2015-09-11 Adding sim parameter -lenth of reset pulse should be driven from sim environment
    [erx_io.v]
2015-09-15 DV cleanup -Set VCO_MULT to 1 for PLL. Dirty hack to allow the RX clk to phase align with the input. Otherwise, if you multiply the VCO clock and then divide, you get a random phase alignment the way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
2015-09-15 Returned erx_io to old format! -Burst works again! -There was definitely a bug on the frame signal, need to pay close attention to all the clock signals, let's review!
    [erx_io.v]
2015-09-25 Hard coding for ephycard, may need to fix back later...
    [axi_elink.v, elink.v, erx.v, erx_io.v, etx.v]
2015-09-25 fixing cut off line
2015-09-30 Addding phase delay tracking - As a dirty a model hack as they come, using positive and negative edge of CLKIN to sample the signal and phase align the clock output. - Will only work with div 2/4/8 e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
2015-10-07 Making reset async - making ecfg_elink reset only depend on por (otherwise chicken and egg) -
    [axi_elink.v, ecfg_elink.v, elink.v, emaxi.v, erx_io.v, erx_protocol.v, esaxi.v]
2015-10-07 Cleaning up TX reset - sync on logic - async on ODDR logic - moving sync logic to clock block
    [etx_io.v]
2015-10-07 RX reset/clocking cleanup - Making all resets async since we cannot guarantee that we have a clock coming in from RX. This is needed due to the way we use a PLL for alignment. If we would have used a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
    [erx.v, erx_cfg.v, erx_core.v, erx_io.v, erx_protocol.v, erx_remap.v]
2015-10-07 TX clock and reset cleanup - more modular - two bits cominng from sys_clk elink config domain - drives the tx and rx from top level elink - from software you would probably write 2'b11 to reset both 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
    [axi_elink.v, ecfg_elink.v, ecfg_if.v, elink.v, etx.v]
2015-10-07 Moving back to async reset
    [edma.v, emailbox.v, emmu.v, fifo_cdc.v]
2015-10-08 Fixing RX reset (again!) -async assert -sync deassert
    [erx.v, erx_cfg.v, erx_clocks.v, erx_core.v, erx_io.v]
2015-10-08 Fixing PLL feedback path
    [erx_clocks.v]
2015-10-08 Reset timing optimization - holding rx in reset state until tx is done - removing reset from all pipeline registers - removing reset from oddr/iddr - the idea is to keep things quiet not to block in 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
    [ecfg_if.v, elink.v, erx.v, erx_clocks.v, erx_core.v, erx_io.v, erx_protocol.v, erx_remap.v]
2015-10-08 Separating rd/wr reset signals (proper)
    [emailbox.v]
2015-10-08 Removing reset from pipeline
    [emmu.v]
2015-10-19 Fixing pushback bug in emmu - reset was broken! - need to account for wait - merging read/write wait for simplicity, otherwise you would need to reset the packets to figure out if it's a read or writ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
    [emmu.v, erx_core.v, erx_io.v, etx_core.v]
2015-11-02 Link cleanup - Using new packet interface - Adding active signal, indicating that link is ready. This way you don't need to guess when the link is ready (no magic constants) - Removed register on por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
    [ecfg_elink.v, ecfg_if.v, elink.v, erx.v, erx_clocks.v, etx.v, etx_clocks.v, etx_io.v]
2015-11-02 Adding new emesh format files * Adding an improved monitor file * Adding mesh interface (avoids crud logic at top level) * A emesh packet memory module
    [emesh_if.v, emesh_monitor.v]
2015-11-02 Fixing include files for emailbox - All "folders" should be independent
    [emailbox.v]
2015-11-02 Fixing pushback bug * Fixed pushback bug at fifo (DUH!) * Need to verify random pushback at all tx/rx ports
    [fifo_cdc.v]
2015-11-04 "Fixing" wait signal - Giving a wait on every ack just doesn't make sense on the read port with a fifo there?? - Makes for a nasty combinatorial loop during integration. - Test passes (but need to lo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
    [emaxi.v, esaxi.v]
2015-11-04 Stimulus end of test issue - Still not 100% on this...but test passes - Teset was hanging even though stim_done went high. Ticks not advancing, pointing towards comb loop, but what is different at en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
    [clock_divider.v, stimulus.v]
2015-11-04 Testbench bug fix - can't connect a 64 bit interface to a 32bit one... - (abuse of emaxi..)
    [dut_axi_elink.v]
2015-11-04 Added filters for all the Xilinx junk - git should have only .tcl files really...
2015-11-05 Filtering more Xilinx junk files
2015-11-06 Filtering more Xilinx crud
2015-11-06 Adding standard modules for reset and data sync
    [dsync.v, rsync.v]
2015-11-06 Moving to active low reset - Because this is the right thing to do for chips - Not going to tell you why...
    [axi_elink.v, dut_axi_elink.v, dut_elink.v, edma.v, elink.v, elink_cfg.v, emailbox.v, erx.v]
2015-11-09 Solving critical paths for TX/RX - Using the BUFIO makes another clock domain....FPGAs apparently hate clock domain crossings, avoid them at all cost. - Now moving back to having on high speed clock 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
    [erx_clocks.v, erx_io.v, etx.v, etx_clocks.v, etx_core.v, etx_io.v, etx_protocol.v]
2015-11-09 Adding attributes to sync logic - Otherwise tool was throwing away logic and timing incorretly. - This is why you HAVE to isolate this logic! Solve the problem once for all logic and for everyone.
    [dsync.v, rsync.v]
2015-11-09 Fixing synchronization reset speed path - This seems silly, why even have a syncrhonizer - Safe to set speed path?
    [erx_clocks.v]
2015-11-09 Cleaning up fifo interface - removing redundant signals - configuring to put synchronizer inside fifo - one reset only (not two)
    [emailbox.v, etx_fifo.v, fifo_cdc.v]
2015-11-09 Fix 0 day bug... - this shows why it's so important to read the warnings. (circuit was broken!)
    [dsync.v, rsync.v]
2015-11-09 Cleaning up warnings from FGPA tools - removing unconnected ports - only one rst input for async_fifo - synchronizing the reset input toe emaxi fifo
    [elink.v, elink_cfg.v, emaxi.v, erx.v, erx_cfg.v, erx_clocks.v, erx_core.v, erx_fifo.v]
2015-11-09 Final Vivado fixups: - reduced frame fanout, removed clock gater in erx_io (improves speed path) - driving constants on "wid signals" (proper) - making lock signal 1 bit wide to remove warning - move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
    [axi_elink.v, emaxi.v, erx_clocks.v, erx_io.v, esaxi.v, parallella_base.v]
2015-11-10 Fixed bug with packet decode - mailbox write now working
    [emailbox.v]
2015-11-10 Fixed readback bug - there were hard coded magic number in code, bad practice! - now works!
    [ecfg_if.v, etx_cfg.v]
2015-11-10 Fixed packet reformatting bug
    [erx_arbiter.v]
2015-11-10 Fixing wait bug on config write (2 bugs) - missing reset on wait signal - missing wait on cfg
    [ecfg_if.v, erx_arbiter.v]
2015-11-10 Speedpath fix for rx io - reduce fanout on IDDR block
    [erx_io.v]
2015-11-10 Lint fixes for icarus/verilator
    [dut_elink.v, elink.v, elink_cfg.v, emailbox.v, emesh_monitor.v, erx_clocks.v, erx_core.v, etx.v]
2015-11-10 Fixing reset bug - There is a register reset by out_clk reset on fifo_cdc - This means the config path needs to us rx synched reset to be clean
    [elink.v]
2015-11-11 Added missing init() routine - Version 0 is the one currently in production, works!!! - Now starting to debug the new linke (verion 1)
2015-11-11 Fixed ctrlmode bug - Found this by trying to toggle the LED in hardware!! - So freaking close!!
    [etx_arbiter.v]
2015-11-11 Removing reset sequence from access utility - Responsibility of application - Makes no sense resettting device after each write/read..
2015-11-11 Adding toggle led test
2015-11-11 Build script fixup + gitignore - Filtering "src" wasn't such a good idea... - Fixing script for bitstream, bootgen doesn't overwrite existing bit stream files (thanks Xilinx, cost me an hour of anxie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
2015-11-11 Bug fix. Adding missing ID parameter. - would only show up at different ID - better to always make defauly nonsense - sneaky...
    [axi_elink.v, parallella_base.v]
2015-11-11 Fixing half/byte zero-out bug - Interrupted mid coding apparently.. - Upper bits need to be zeroed out for 8/16 bit read responses
    [emaxi.v]
2015-11-11 Defparam typo - Not caught by iverilog!! (file bug??) - Caught by Vivado.
    [parallella_base.v]
2015-11-12 Adding proper test or bursting - Need to at a minimum try to fill the fios - Need to add a wait circuit at the back end of fifo to test pipe
2015-11-12 Fixing burst transmit bug - The burst should be interrupted as soon as there is a wait signal. When the wait stops, a new frame naturally starts.
    [etx_io.v, etx_protocol.v]
2015-11-12 Adding wait circuit for axi/elink
2015-11-12 Adding proper read alignment for ememory model -Byte/shorts now work
    [emesh_rdalign.v]
2015-11-13 Fixing wait circuit in emmu - need to consider read/write - fixing packet parsing, write bit was moved o [0]
    [emmu.v]
2015-11-13 Fixing memory model for emesh - Moving random wait generator into module - Fixing wait circuit
    [emesh_monitor.v]
2015-11-13 Fixing wait circuit in dut (randome wait gen was removed from top)
    [dut_elink.v]
2015-11-13 Various wait cleanups in RX - using rx reset, safer as this stays in reset longer, until the clock has hade time to clean up the rest
    [erx.v, erx_arbiter.v, erx_core.v, erx_fifo.v]
2015-11-13 fixing packet reshuffling bug
    [etx_arbiter.v]
2015-11-13 fixing packet format for remap block
    [etx_remap.v]
2015-11-13 Redesign of elink transmitter - Old design was not workable with bursting and long waits. The wait signal needs to be very carfully handled since it's asynchronous to the clock. -The TX needs to be s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
    [etx_core.v, etx_io.v, etx_protocol.v]
2015-11-13 Two more wait bugs for burst - The burst signal needs to be pipelined like everything else (0th order..) - Don't look at write signal when pushing back wait...WILL GO BACK AND REVISIT THIS ONE LATER.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
    [etx_io.v, etx_protocol.v, etx_remap.v]
2015-11-15 Adding edge align circuit
2015-11-15 Fixing edge align circuit - duh error - making output positive edge aligned, the negedge nastyness should be maintained within module...
    [edgealign.v]
2015-11-15 Re-re-fixing the wait on RX - (fixing a temporary bad commit)
    [erx_arbiter.v]
2015-11-15 Simplifying TX logic!!!! - The logic was a mess, causing me to go around in circles for days. In the end, by adding a missing sync circuit (duh!) between the fast and slow clock to align the edges an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
    [etx.v, etx_core.v, etx_io.v, etx_protocol.v]
2015-11-15 Fixing burst logic speed path - The burst signal was going fro lclk_div4 domain straight into the io high speed domain. There is quite a bit of logic on this signal. Instead of starting with false pa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
    [etx_io.v, etx_protocol.v]
2015-11-16 Burst works (really this time!!!) -Solved a speed path in synchronizing the wait signal, had to use the first edge signal fo the IO and the lclk_div4 for the core logic. It seems that the FPGA has a 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
    [etx_io.v, etx_protocol.v]
2015-11-17 Added missing burst bit for legacy elink... - This is a pain in the ass and should never have been implemented in the first place! - Burst information is contained in two places, once in the first by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
    [etx_io.v]
2015-11-17 Random test failure bug fixes - Adding transaction counter to speed up debugging - Clearing access signal on wait ("bubble") - Adding back special propagation when there is a wait after io_wait.
    [etx_io.v, etx_protocol.v]
2015-11-17 Fixed burst tail bug - Clearing the "done" register with tx_burst. Kind of makes sense logically since while we are in burst mode we are not done. - Still not 100% happy with this circuit, but there 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
    [erx_clocks.v, etx_clocks.v, etx_io.v, etx_protocol.v]
2015-11-18 Fixing README TOC links
    hrefs should be done in all lower case for in documents links
2015-11-19 Adding stub files for axi master and slave - Got tired of tying off constants, too many useless bugs to debug... - Easier to to autoinst...
    [aximaster_stub.v, axislave_stub.v]
2015-11-19 Improving the elink_axi environment - Turns out there was a bug hidden in the emaxi that can only be found by properly driving a master device with reads. This could not happen in the old environment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
    [dut_axi_elink.v, dut_elink.v]
2015-11-24 Adding pushback circuit to stimulus
2015-11-24 Added wait generator for fifo (experimental) - found it very difficult to get to some of the hard to reach scenarios - the wait circuit helps generate fifo full - off by default!
2015-11-24 Adding environment for chip reference model - Turns out I had a nasty bug that was masked by using my own RX to loopback the TX. Since the new RX is very benign with a programmable fifo full flag the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
    [dut_e16ref.v]
2015-11-24 Complete redesign of the TX - After finding the bug in the reference model and wasting countless hours going back and forth with FPGA timing optimization and bug tweaks, I realized that the design wa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
    [emaxi.v, erx_clocks.v, erx_fifo.v, esaxi.v, etx.v, etx_clocks.v, etx_core.v, etx_io.v]
2015-11-24 Fixing DUT - Adding read response pushback - Adding random WAIT generation on memory
    [dut_axi_elink.v, dut_elink.v]
2015-11-26 Fixing clock transfer speedpath - Better to do shift register than a wide or pulse
    [erx_io.v]
2015-11-26 Filtering out short wait-low pulses from legacy elink -Feels safer, should not be any short wait glitches
    [etx_io.v]
2015-11-26 Filtering register write transactions -They were going out on the elink (not safe)
2015-11-26 Fixing bug for readback?? - There was definitely a bug there, that has been fixed - But now the interface seems completely broken... - Passes in simulation and "should work"...
    [emaxi.v]
2015-11-26 Solved read response bug. MATMUL WORKS!!!! - Turns out I was debugging ghosts for ~1 day today. Everything was working in simulation but nothing works in the FPGA. Since I was only changing small log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
    [emaxi.v]
2015-11-29 Test cleanup - added lint script using verilator - adding verilator filter commands for fifo behavioral - Longer pushbacks in ememory
2015-11-29 Fixing readback from mailbox
    [emailbox.v, erx_core.v]
2015-11-29 Fixed mailbox bug on remap - Bypassing remap on write to RX registers - Otherwise the write to mailbox gets dropped since 810 gets remapped to 310
    [erx_remap.v]
2015-11-29 Working mailbox! - Gating mailbox_not empty with irq_en. bit [28] of RXCFG - Changing elink output interrupt to "or" of not_empty and full - Adding mailbox status register (mostly for debug) - Moving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
    [axi_elink.v, dut_axi_elink.v, dut_e16ref.v, dut_elink.v, elink.v, emailbox.v, erx.v, erx_cfg.v]
2015-11-29 Fixing system_bd interface for "mailbox_irq" signal
    [parallella_base.v]
2015-11-30 Fixed typo on MMU lookup. -MMU now seems to work...
    [emmu.v]
2015-11-30 Fixing up issues with database reorg - Not sure where the prog_full issue popped up from. (sign of disorganized databsae) -
    [elink.v, emailbox.v, erx_fifo.v, etx_fifo.v, parallella_base.v]
2015-12-03 Adding datagate power saving module
2015-12-04 Fixing priority on etx_arbiter - don't do a combinatorial loopback on wait in a primitive cell, just bad practice... - changed priority to give readback priority over read, safer?
    [etx_arbiter.v]
2015-12-04 Fixed unconnected wires in standby circuit
2015-12-05 Fixing unconnected wire bug
2015-12-17 Reuse refactoring -Made AW primary parameter to make reuse possible with other design -Insert TARGET_SIM ifdef to make design synthesizable
2015-12-17 Adding memory to driver -More modular, foudn myself adding memories in a lot of places
2015-12-19 Filter for mailbox accesses - ecfg_if mi_dout_mux must only have one active input on mi_cfg_en
2016-01-11 Error message in one hot mux
    [dv_driver.v]
2016-01-11 Cleaning up register interface - Removed the cfgif block, too confusing. There is a good lesson here. Probably the n'th time I that I have been overzealous about reuse. When you end up adding a param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
    [edma.v, emailbox.v, emesh_monitor.v, emesh_rdalign.v, emmu.v, erx_arbiter.v, erx_cfg.v, erx_core.v]
2016-01-12 Adding reset to pipeline - More conservative (only 2 more flops)
    [emmu.v, etx_remap.v]
2016-01-12 Fixing write to TX register bug - The write transaction was incorrectly piped through to axi slave
    [erx_cfg.v, erx_core.v, etx_core.v]
2016-01-12 Adding reset signal to burst
    [erx_io.v]
2016-01-12 Fixing MMU write access - MMU was being written when it shouldn't
    [erx_cfg.v, erx_core.v, etx_cfg.v, etx_core.v]
2016-01-13 Changing timeout - Test being cut off too early. - Really need to implement end of test indication already!!!
2016-01-13 Adding support for 64core board
2016-01-14 axi/hdl/emaxi: Fix signal names
    [emaxi.v]
2016-01-15 Fixing warning/cleanup - port widths don't match for ctrlmode
    [emaxi.v]
2016-01-18 Fixing silly compiler errors
    [oh_8b10b_encoder.v]
2016-01-19 Changing to sync fifo - The response time for async fifo was not fast enough due to synchronization, was causing problems when connecting memory/reg directly to output. - Was found in testbench, but 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
    [emaxi.v]
2016-01-19 Changing timeout value -timeout was hit in sim, 8bits is too short -refactoring to simplify names, rx/tx was confusing
    [esaxi.v]
2016-01-19 Fixing read response logic - Should only pass back read response EGROUP_RR - Otherwise there would be a match on writing to MAILBOX
    [erx_arbiter.v]
2016-01-19 Simplifying axi_elink testbench - Too much junk in there, couldn't understand my own logic 4 weeks later... - emesh_if is a disaster, I have yet to find a way to write code that lets me remember the 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
    [dut_axi_elink.v]
2016-01-19 Removing filter logic for ID match (bug fix) - This was moved to arbiter block
    [etx_protocol.v]
2016-01-19 Hold hack.. -This needs to be resolved! Currently there is a simulation problem with the PLL and IDDR circuit, likely due to the clock divider. Amazingly enough the circuit works in sim and FPGA, but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
2016-01-19 Cleaned up the falling edge of frame -The current testbench has a big pause between frames, whereas the chip might push out back to back frames with only a single cycle pause between frames. It seems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
    [erx_io.v]
2016-01-20 Add burst test
    Add test for writes to same address. Apparently consecutive 64-bit
    writes to the same address can turn into burst writes.
    From:
    https://github.com/parallella/oh/issues/37
    Andreas:
    > Remembered that we have a long forgotten mode in the epiphany chip elink
    > (not impemented in the fpga elink) that creates bursts when you write
    > doubles to the same address. (F**K!)
    > So the writes were likely coming in as bursts.
    > Looks like the mailbox works fine when you write in "int"s (I tested it on
    > the board with consecutive)
    > (see "mailbox_test" in elink/sw0)
2016-01-20 Adding rd_count, prog_full to interface - status now 32 bit register - block writing on full - block reading on empty - route prog_full to wait pushback circuit
2016-01-20 Fix mailbox interrupt
    Use IRQ_F2P for interrupts, this is what other designs seem to do.
    Use interrupt pin 11 (maps to IRQ=87 devicetree-IRQ=55 (87-32)).
    Disable CORE0_FIQ_INTR as we no longer use it.
    Add concat ip, apparently needed:
    http://www.xilinx.com/support/answers/58942.html
    Add constant_zero, and constant_one outputs to parallella_base module.
    Tie all unused (by PL) interrupts on the F2P port to 0.
    [parallella_base.v]
2016-01-20 Fixing various small bugs -sandbox accelerator working in simulation! -t0+6 hrs wall time (lost 2 hours due to travel)
    [dut_axi_accelerator.v, emaxi.v]
2016-01-21 Fixing weird Vivado error -Seems vivado doesn't like the "|=" operation??
    [emesh_mux.v]
2016-01-21 Add kernel mailbox interface test
    Kernel code here, will be included in official 'parallella-linux'
    when API:s have stabilized...
    https://github.com/olajep/parallella-linux/tree/wip-mailbox
    ```
    Testing blocking wait with interrupts
    i: 00 from: 0x00000000 data: 0x00000000
    i: 01 from: 0x00000000 data: 0x00000001
    i: 02 from: 0x00000000 data: 0x00000002
    i: 03 from: 0x00000000 data: 0x00000003
    i: 04 from: 0x00000000 data: 0x00000004
    i: 05 from: 0x00000000 data: 0x00000005
    i: 06 from: 0x00000000 data: 0x00000006
    i: 07 from: 0x00000000 data: 0x00000007
    i: 08 from: 0x00000000 data: 0x00000008
    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
2016-01-23 Adding gpio circuit -work in progress -compiles and read/write to some registers work
2016-01-25 Adding SPI module -Work in progress!
2016-01-25 Adding gpio and spi paths
2016-01-27 elink: etx_cfg: Fix transmit mode bits typo
    [etx_cfg.v]
2016-02-12 Contributing nested interrupt controller
2016-02-12 Fixing warning messages in chip synthesis tool - Don't fight the tools - No way to remove these warnings and I don't want to have to tell everyone to include maging "don't output this kind of warning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
    [emesh_mux.v, oh_arbiter.v]
2016-02-15 mailbox: Update software example
    Switch to kernel devel branch compatible IOCTL's.
2016-02-15 Initial commit of generic synthesis flow
2016-02-16 Reorg to remove common - Easier to navigate (shallow is good) - "common" is kind of like "misc"...superfluous in this case
2016-02-19 Added the definition of priority encoder
2016-02-23 Adding debouncer circuit
2016-02-23 Fixing new ddr circuits
2016-02-23 Adding experimental fifo circuit -not debugged
2016-02-24 Adding 2nd clock to interface - Randomizeing clock frequencies - Phase and frequency randomization a must for catching first order sync problems (and debunking really stupid ideas...) - Don't be clev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
    [dv_driver.v]
2016-02-27 Simplifying module -Interrupt should be kept separate from GPIO (use PIC)
2016-03-05 Fixing up GPIO - adding support for 64 bits - implementing global edge detect - implementing most of the features - (not debugged yet)
    [dut_gpio.v, gpio.v]
2016-03-05 Cleanup GPIO logic -various bringup bug fixes -name simplication -now works in simulation
    [gpio.v]
2016-03-08 Implemented parametrized spi slave module - Compiles, but not debugged yet! (needs cleanup) - Next up : implement master, testbench
2016-03-08 Filtering out
2016-03-09 Adding SPI master -code compiles, but still needs debugging -small parts not implemented
2016-03-09 Spi slave name changes -to be consistant with interface for emesh/core
2016-03-09 Adding combined master/slave spi top level
2016-03-10 Expanding par2ser functionality -module now works for multi bit shifts -has been used in spi master module -versatile load and shift bits
2016-03-10 Debugged most of SPI -Changed to FIFO on TX path (cleaner) -No good solution on RX with CDC since clock can stop, so you can't use an async fifo. -Slave needs cleanup, rethink... -Using commong par2s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
2016-03-10 Simplifying clockdiv -tested in spi block -more generic, simpler
2016-03-10 Refactoring to maximize code reuse -using common clock divider, ser2par block -starting the readbkack circuit + auto transfer
2016-03-10 Adding SPI documentation
2016-03-10 Simplifying spi slave - Clock sync made easier by detecting rising edge of ss - Piping data into slave regs - State machine simplified
2016-03-10 Adding command reg to spi master - Makes the emode more efficient, only setup command once
2016-03-10 Fixing SPI pushback contention bug (typo)
    [dut_spi.v, spi.v]
2016-03-10 Fixing SPI bugs - Now working with byte addresses - Wait should be on prog_full
    [spi_master_fifo.v]
2016-03-10 Changin SPI slave parameter - More natural to work with UREGS
2016-03-10 Fixing SPI slave write register bug - Writes working
    [spi_slave_io.v]
2016-03-10 SPI debug cleanup
2016-03-10 Fixing serializer bug - SPI now working...
2016-03-10 Fixed serializer bug - ..hopefully last one - incorrect stall signal made transactions get lost
2016-03-10 Changing SPI command structure - Read/write commands should be at MSBs (7:6) - Fixed fifo read race..need to look at this again
    [spi_master_io.v, spi_slave_io.v]
2016-03-11 Completed basic SPI test - configure master - write to tx fifo - read from remote slave - read from local master register
2016-03-11 Completed readback circuit on master
2016-03-11 SPI working! -changed register file sampling to falling edge of sclk...ran out of edges -fixed the register map for readback -fixed status register -fixed user register decode
    [spi_slave_io.v, spi_slave_regs.v]
2016-03-11 Fixing SPI header file inclusion issue
2016-03-13 Adding emesh readback circuit
2016-03-13 Implementing GPIO readback circuit -added test, looks good -reduced decoder width to 16 regs (seems reasonable for gpio)
2016-03-21 Fixing mtx io logic - adding support for single data rate - removing wait logic from io registers, should only go to fifo
    [mtx_io.v]
2016-03-21 SPI compilation cleanup - due to changes in par2ser and clock divider - disadvantage of using common modules that change...
2016-03-21 Fixing par2ser bugs -access out signal was broken (may need to fix again for spi) -lsbfirst mode was broken -made datasize 8 bits at interface
2016-03-21 Cleaning up GPIO - AW parameter was missing in p2e - Blocking input data with input enable (alsom done at io pad)
    [gpio.v]
2016-03-21 MIO cleanup -adding target parameter to fifo -fixing rx protocol bugs -adding defaults to register file, usually these should be set to zero and -don't clock gate the DDR TX, just causes output to to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
    [dut_mio.v, mio_dp.v, mio_regs.v, mrx.v, mrx_protocol.v, mtx.v, mtx_io.v]
2016-03-21 Changing transmit order for mtx_io -Making msbfirst the defaualt (looks cleaner on scope) -Swapping bytes on msbfirst and ddr mode -Implementing sdr mode on RX
    [mrx_io.v, mtx_io.v]
2016-03-21 MIO debug - fixing msbfirst packet mode bug - fixing lsbfirst packet mode bug - fixing clkphase writing bug - changing default to msb first - making a single DEF_CFG and DEF_CLK parameters (it was ge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
    [mio.v, mio_if.v, mio_regs.v, mrx.v, mrx_protocol.v, mtx.v]
2016-03-21 Fixing fifo status for mtx (signals were unconnected)
    [mio_dp.v, mio_regs.v, mtx.v]
2016-03-21 Stressing pushback by removing the training wheels -Checks block with full throttle and with waits (for debug)
2016-03-21 Fixing basic par2ser stall bug - don't start new transfer until current transfer is done
2016-03-22 Fixing basic spi test to fit new clock divider
2016-03-22 Looping back master spi access/packet to driver/stimulus
2016-03-22 Resetting slave par2ser with ss (not nreset!) - Shifting out on positive edge of sclk
    [spi_slave_io.v]
2016-03-22 Fixed readback bug - Only readback on reads
    [spi_master_regs.v]
2016-03-22 Simplifying state machine on spi master - Divide and conquer, use the par2ser wait signal to hold off on read - Removed the stupid byte done state! Was too complicated.
2016-03-22 Fixed mux bug in spi - copy paste error
    [spi.v, spi_master.v, spi_slave.v]
2016-03-22 elink/sw/idelay: Update for ESDK 2016.3
    - ee_{write,read}_esys removed from e-hal, implement in idelay.
    - Access to FPGA regs restricted by driver.
    Need to pass unsafe_access parameter to module.
    If builtin, add to bootargs:
    epiphany.unsafe_access
    If module:
    sudo rmmod epiphany && sudo modprobe epiphany unsafe_access
2016-03-22 Adding DMA - First draft - Work in progress..
2016-03-23 Implemented DMA state machine - Work in progress
2016-03-23 Integrating DMA control logic
2016-03-23 Adding initial DMA documentation
2016-03-23 Removed mio autoincrement mode -Have this handled in a more capable DMA (no need to duplicate functionality) -Adding frame polarity signal
2016-03-23 Implemented frame polarity in mio -Seems like the place to do this, more advanced framing should be done outside of mio
2016-03-24 Adding missing parameters statements in mio_if
    [mio.v, mio_if.v]
2016-03-25 Initial Commit of 8b10b Encoder and Decoder
2016-03-28 Fixing connection errors for AW=64 in SPI
    [dut_spi.v, spi_master_fifo.v, spi_master_regs.v, spi_slave_regs.v]
2016-03-30 Adding hw_en pin to SPI module - b/c there are times when you need physical control of the pins (can't do it in software, no packets will arrive) - use case examples: security, power gating, reliabil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
2016-03-31 Adding logical buffer with supply modeling - important for multi power supply designs
2016-03-31 Adding power gate switch
2016-04-01 Adding power supply pins to dma (place holder)
2016-04-01 Removing DMA from logic
2016-04-01 Fixing dut_spi interface - adding hw_en - removing mastermode from interface, not needed
    [dut_spi.v]
2016-04-03 Fixing interface for power gate
    [oh_pwr_gate.v]
2016-04-04 Adding design guideline - Circuit level blocks/hacks should be separate from logic with interface
2016-04-04 Changing parameter for emesh_if -Only one to keep track of (AW)
2016-04-05 Fixing power buffer model
2016-04-05 Driving realistic power ramp in startup
2016-04-06 Adding shutdown signal for macro - Needed for proper power management, should not be lumped with config
2016-04-07 Completing test for "epiphany" remote read over spi
2016-04-07 SPI slave fixup - removing emode (was redundant) - fixing user regs issue - adding status bit to poll for returned data on fetch
    [spi_slave_regs.v]
2016-04-07 Fixing epiphany spi fetch - adding a separate serializer for the remote fetch (cleaner) - fixing the load signal to load on all bytes while ss low - removing reset from command register - review sync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
    [spi_slave_io.v]
2016-04-07 Reomving redundant emode feature from spi
2016-04-07 Fixing spi master pushback bug
    [spi_master_fifo.v]
2016-04-07 Launching data on falling edge on default spi mode (as it should be...not sure how I missed this)
    [spi_master_io.v]
2016-04-07 SPI now with working emesh packet transfers working - (see test_basic.emf for example) - basically works by pushing consecutive bytes into FIFO (104 bits) - need to make sure the FIFO does not go emp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
2016-04-07 Adding SPI examples
2016-04-07 Cleanup spi readme
2016-04-07 Cleanin up wait signal -There were some corner case problems when driving non safe interfaces like the SPI...can't always have the luxuary of a fifo
    [stimulus.v]
2016-04-11 Fixing remote fetch spi feature - Added missing reset - Using rising edge of ss (after nreset deasserted) as indicator (and command reg is set to fetch) - Seems like it should be robust across all cl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
    [spi_master_regs.v, spi_slave.v, spi_slave_io.v, spi_slave_regs.v]
2016-04-11 Enhancing GPIO block - implementing interrupt handling - edge/level support - moving to single register for "DIR", avoids confusion - adding ILATCLR for clearing interrupts - changing to N parameter 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
    [dut_gpio.v, gpio.v]
2016-04-11 Removing ce from oddr - Better to turn off clock if you want to save power - The CE was actually increasing the power by N x by making every data signal a clock :-)
2016-04-11 Initial thoughts on a gpio driver
2016-04-11 Fixing gpio initial use case example
    [gpio.h]
2016-04-12 Making interrupt 0 non-maskable.
2016-04-12 Adding nreset to command reg - Not 100% sure on this. Ideally I think you would want the ss signal to be the "reset" of all this logic, but the command register gets too tricky. - Is there an issue i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
    [spi_slave_io.v]
2016-04-13 GPIO: Remove old driver template
2016-04-13 GPIO: Add GPIO driver
2016-04-13 Making all significant GPIO registers readable for now - Would really prefer if this could be handled in the driver..
2016-04-14 Fixing oh_dsync instantiation - to add new reset pin (can be tied to 1'b1 sometimes)
    [edma.v, edma_regs.v, erx_clocks.v, etx_cfg.v, gpio.v, mtx.v, spi_slave_io.v]
2016-04-14 Vivado doesn't like localparam / clog2 combo
    Using parameter instead works.
    [mrx_protocol.v, mtx.v, oh_bin2onehot.v, spi_master_fifo.v]
2016-04-15 Simplifying synthesis flow - Too many steps, some of them were "one line long"
2016-04-16 Shortening flow names - + reorg
2016-04-17 Fixing synthesis compilation warnings - Could supress warning printout, but you can't control people's synthesis scripts. Better to fix once than N times...
2016-04-17 Fixing more synthesis warnings
    [edma_ctrl.v, edma_regs.v, oh_pwr_gate.v]
2016-04-19 Improving standby circuit - removing reset (bad logic) - refactor for simplicity/clarity - interface changes
2016-04-20 Tweaking isolate block - removing power signals for now - adding asic parameter
2016-04-22 GPIO: Add linux kernel driver
2016-04-27 GPIO: Fix hardcoded address width
    Use parameter value (which can be smaller).
    [gpio.v]
2016-04-27 GPIO: Add FPGA project
    Add FPGA project for Vivado.
    It compiles but not tested.
    TODO:
    gpio_in / gpio_out are not connected.
    Interrupt not connected.
2016-04-29 GPIO: Fix access/wait/packet signals in AXI module
    Need mux for rd_access and wr_access.
    [axi_gpio.v]
2016-04-29 GPIO: Add parallella_gpio module
    Parallella board top module.
    Uses pgpio from parallella base.
2016-04-29 GPIO: Update FPGA project to use parallella_gpio as top
    Use parallella_base pin constraints.
2016-05-03 GPIO: parallella_gpio: Fix pin direction
    Connect gpio directly to pgpio.
    The oh_tristate block was never needed.
    [parallella_gpio.v]
2016-05-03 GPIO: Fix pin constraints for FPGA project
2016-05-03 GPIO: Update Linux driver
    Branch with full history here:
    https://github.com/parallella/parallella-linux/tree/oh-gpio
    ChangeLog:
    commit eb190fa4891cf2c2d33f263d51c566ebb15ac9a1
    Author: Ola Jeppsson <ola@adapteva.com>
    Date: Tue May 3 23:27:52 2016 +0200
    gpio: oh: Interrupt detection is disabled for masked interrupts
    The OH GPIO controller disables interrupt detection for masked
    interrupts so we don't need to provide a irq_enable() to protect from
    spurious interrupts.
    Nor do we need to mask ILAT against IMASK to get pending interrupts in
    the interrupt handler.
    commit 366257c1893199d3dba5f3768df8b235d702f56e
    Author: Ola Jeppsson <ola@adapteva.com>
    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
2016-05-04 spi: Add axi_spi module
2016-05-04 spi: Add parallella_spi top module
    Note:
    spi_s_sclk must map to a SRCC/MRCC capable pin.
2016-05-04 spi: Add FPGA project
2016-05-15 Updating spi to new packet format
2016-05-15 Updating dma with new packet format
2016-05-19 gpio: Fix issue with new emesh packet format
    Vivado complains since AW is 32 bits wide but emesh_readback.read_data
    is now 64 bits wide.
    [gpio.v]
2016-05-19 spi: Move out of the way of elink
2016-06-01 mio: driver: Add first hello world test
2016-06-19 Cleaning up chip synthesis errors/warnings
    [mio_dp.v, mio_regs.v, mrx_io.v, mrx_protocol.v, mtx_io.v]
2016-06-19 Cleaning up SPI chip synthesis errors/warnings - Better to clean up than to have every designer setting an "ignore warning" in tool. - Don't fight the tools...
    [spi.v, spi_master.v, spi_master_fifo.v, spi_master_io.v, spi_master_regs.v, spi_slave.v, spi_slave_io.v, spi_slave_regs.v]
2016-06-25 Adding clock "or" circuit
2016-07-10 Synthesis cleanup - adding missing reset on pulse/edge detectors - disconnecting unused signals in spi clockdivider - changin output to input on spi_slave_io for read data
    [spi_master_io.v, spi_master_regs.v, spi_slave_io.v]
2016-08-17 Synthesis: parameter = `CFG_ASIC not accepted in module declaration
    Vivado does not pre-process defines in the module declaration.
    The result is that each module with this type of declaration is AutoDisabled by Vivado
    Moving the top level define to a localparam fixes this problem
    [mtx_io.v, oh_pwr_gate.v]
2016-08-17 TARGET changed back to XILINX from GENERIC
    Commit 3fa5fce "Cleaning up fifos" accidentally changed TARGET from XILINX to GENERIC
    This commit fixes this problem and moved TARGET assignment to the top level
    Fixes CRITICAL WARNING: [Designutils 20-1280] Could not find module 'fifo_async_104x32'.
    [elink.v, emailbox.v, erx.v, erx_core.v, erx_fifo.v, etx.v, etx_fifo.v]
2016-08-21 oh_add: Fix typo in the function description
    Fixes a small typo in the description of the adder-subtractor (two's complement representation).
    [oh_add.v]
2016-08-24 Adding manual control of slave select pin
2016-08-24 Fixing spi controller - Manually merging work from @olajep in PR #85 (too far out of sync) - Fixing issue with lsbfirst logic - Adding logic for manual control of slave select - Fixing status registe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
    [spi.v, spi_master.v, spi_master_io.v, spi_master_regs.v, spi_slave_io.v, spi_slave_regs.v]
2016-08-24 Fixing nasty glitch bug on clock -Created phantom event simulator -Lucky to catch it quickly -Don't know wtf i was thinking with that circuit...
    [spi_master_io.v]
2016-08-25 SPI code cleanup
2016-08-25 Adding new fifos for MIO -In preparation for redesign
    [mrx_fifo.v, mtx_fifo.v]
2016-08-25 Adding missing wait signal to rx
    [mrx_fifo.v]
2016-08-25 Redesigning MIO rx - Standardize on 64bit FIFO interface - Stuff bytes into shifter register before transferring to fifo - Use valid bits per byte to keep track of valid data through pipe - Work in p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
    [mrx_io.v]
2016-08-25 Fixing bugs in transmit logic - Serializer wait was missing - Need to reload on last cycle before emptying to avoid stall, need "next"
    [mtx_io.v]
2016-08-25 Fixing default config for new register file
    [dut_mio.v]
2016-08-25 Fixing various simple MIO receiver IO bugs - Really a nice reverse of TX logic... - Support for partially full transfers when frame goes low
    [mrx_io.v]
2016-08-25 Fixing MIO DDR mode Works!
    [mrx_io.v, mtx_io.v]
2016-08-25 Fixing MIO mode switch bug - Need to look over this circuit again, feels nasty. There is a ever rotating state here, that should probably be reset when there is no transaction, but how?
    [mio.v, mrx_fifo.v]
2016-08-25 Adding missing parameter in MIO
    [mio.v]
2016-08-26 Fixing bug in MIO receiver -nibble wide io now supported in RX
    [mrx_io.v]
2016-08-26 Fixing MIO transmit DDR mode -iowidth refers to the size of a single ended bus -DDR is implicitly half that size
    [mtx_io.v]
2016-08-26 Fixing MIO emesh transaction bug - data should go straight into fifo for first cycle - after that, the data is taken from a temporary buffer
    [mtx_fifo.v]
2016-08-26 SPI synthesis cleanup
2016-08-26 Fixing MIO synthesis errors/warnings
    [mrx_fifo.v, mrx_io.v, mtx_fifo.v, mtx_io.v]
2016-08-27 Adding DV hook into SPI block - Inputting large amount of data through SPI in DV is soooo painfully slow. Added hook to speed up development. 100x speedup in verification time-->100x speed up in desi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
2016-08-28 Fixing reset bug for MIO emode - Shows up when there is no free running clock. Don't assume there is a clock at startup!
    [mrx_fifo.v]
2016-10-24 Adding open source board resource
2016-10-24 Adding Rascal board
2016-10-24 Format change for board record - explicit link - adding docs
2016-11-15 Adding directory of standards -Summary
    [fmc.xlsx]
2016-12-21 Adding planning document for boards -Not CAD accurate, only for visual planning
2017-01-31 ip: fifo_async_104x32: Switch to ultrascale device
2017-02-01 Add zcu102 design
    Work in progress.
    Design looks good.
    Need to add pin and timing constraints.
2017-02-02 zcu102: Add package pins for FMC0 connector
2017-02-03 common/hdl: Fix syntax error when CFG_ASIC is undefined
    Workaround for:
    Recent Vivado (2016.4) synth step seems to have dropped support for
    "-verilog_define CFG_ASIC=0"
    [oh_pwr_gate.v]
2017-02-04 zcu102: Fix constraints
    - Some pin mappings were wrong (don't code when tired).
    - Use 1.8v IO standards.
2017-02-04 zcu102: Add some documentation
    - Carrier board FMC pinout.
    - ZCU102 master XDC file.
    [pinout.xls]
2017-02-04 common/fpga/system_init.tcl: Support board_part variable
2017-02-04 zcu102: Set board part to zcu102 in zcu102_base ip and zcu102 project
    Seems the right FPGA model is:
    xczu9eg-ffvb1156-2-i-es2
    No way to tell for sure (JTAG doesn't give exact model) without removing
    heatsink from board :(
    Should be same package pins though.
2017-02-04 zcu102: hdl: Change IOSTD_ELINK to 1.8v LVDS
2017-02-04 zcu102: Disconnect carrierboard CLKIN_P1 from zcu102_base/cclk
    Fixes synthesis.
    zcu102_base/cclk must be tied to *one* package pin.
    Need to create a separate clock primitive for CLKIN_P1.
    But those pins are for testing, final design should use on-chip
    SG-310 oscillator ("REFA").
2017-02-04 elink: Migrate to Ultrascale+ IO primitives
    Breaks zynq.
    - Should be configurable so we can support both Zynq and zynqplus
    (Ultrascale+).
    - Need to add idelay3 register so we can expose entire tap range for
    ultrascale. 9 bits vs 5 bits for zynq.
    - IDELAYCTRL fails DRC (Vivado bug?)
    - Use .DELAY_FORMAT("TIME") in IDELAYE3. Depends on IDELAYCTRL.
    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
    [erx_clocks.v, erx_io.v, etx_clocks.v, etx_io.v]
2017-02-07 Revert "common/hdl: Fix syntax error when CFG_ASIC is undefined"
    This reverts commit 049a031e47ff2dde7bd12b151649350d56fc2e09.
    [oh_pwr_gate.v]
2017-02-09 zcu102: zcu102: Use Petalinux 2016.4 design as base
    Change partname to:
    xczu9eg-ffvb1156-1-i-es2
    Don't set BOARD_PART.
    Remove si570 pl component.
    Full path:
    petalinux-bsp/xilinx-zcu102-zu9-es2-rev1.0-2016.4/hardware/xilinx-zcu102-zu9-es2-rev1.0-2016.4/
2017-04-01 Changed license copyright
    The Parallella Foundation was resolved. Too much of a headache to maintain. Considering a permanent home in an existing foundation like eclipse, or apache, or other? For now assigning to me. History of code copyright: Adapteva-->Parallella Foundation-->Andreas Olofsson
    1.) Most of code developed while Andreas Olofsson was employed at Adapteva
    2.) 2016: Adapteva board resolution transfered code to Parallella Foundation under leadership of Andreas Olofsson
    3.) 2016: Parallella foundation resolved and code copyright transferred to Andreas Olofsson
    None of this should matter given the MIT nature of the license....
2017-11-22 Fixed elink platform compile errors -Ultrascale changes broke the zynq design -Adding CFG_PLATFORM variable to control compilation target
    [erx_io.v, etx_clocks.v, etx_io.v]
2020-01-28 Changing hierarchy to promote blocks
    [pinout.xls]
2020-01-28 Cleaing up OH repo
    [fmc.xlsx, pinout.xls]
2020-02-05 Adding print to file fuctionality
2020-02-05 Changing stimulus order to avoid on memh
    [stimulus.v]
2020-02-15 Adding script for converting difference trace formats to epiphany Speeds up debugging immensly Goal is to mmake it so that files can be tkdiffed and readable without any extra python scripts to post 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
2020-02-15 Adding register look up table -simulator trace uses abi names, hardware uses raw registers
2020-03-13 Adding synchronous clear signal to fifo -It's not uncommon to want to clear/invalidate all entries int he FIFO -Still need async reset for power-on in absence of clocks
2020-03-28 Rewritten trace script for spike -ovpsim is a dead end, good bye
2020-04-07 Fixing register file -Changing DW to RW (RW not always equal to DW..) -Blocking rd_data on valid -Fixing elemetary bugs based on indices -Simplifying index code -Add configurable pipeline stage?
2020-08-17 Fixing a bunch of synthesis issues -Better to fix to avoid issues across different synthesis platform (even if standard would allow if for verilog2005)
    [oh_bin2onehot.v]
2020-08-19 Fixed nasty testbench problem that snuck in -The pass fail indicator is always tricky to get right -In this case diff/done went high on the same cycle so everything was passing.. -Added check for sam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
2020-09-21 Future proof emesh format with another byte of controls -At 144 bits, it's less than 5% in signals and virtually no power penalty -The goal is to be completely axi feature compliant
2020-09-22 Day zer big???!!! -Can't believe this was missed!!!!! -Clearly for a dual data rate circuit, a stable low signal should be selected with low clock, that's the definition!
2020-09-22 Removing extra pipeline dela in ODDR -Both din1 and din2 needs to be stable low by driver -If the inputs are driven by a reg anyway like in the case of a FIFO output or memory, then we just saved a c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
2020-09-23 Redesining oh_iddr -adding separate clock enables -adding internal clock enable for neg edg sample -combining q1/q2 legacy interfae into a single output
2020-09-26 Simchecker printout fix
2020-09-26 Major change of "wait" to "ready" -This will cause a lot of nasty bugs, but it's the right thing to do to be more consistent with standard buses going forward. -Change is made from access/wait tp val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
    [emesh_if.v, emesh_monitor.v, emesh_mux.v, emesh_readback.v]
2020-12-04 Flattening memory hierarchy!!! -Now completely compatible with FPGA and ASIC flows with a single source
2021-05-25 Adding switch level modeling of nand gate
2021-05-25 Adding nor primitive circuit
2021-05-25 Prototype for driving cell level parameters
2021-05-25 Merging rtl and switch models in one verilog file
2021-06-15 Adding place holder core power pad cell
2021-06-16 Removing depracated file -Power merged with domain
2021-07-06 Fix width of padring 'dout' ports
    [oh_padring.v]
2021-07-26 Adding asic_add block to abs circuit
2021-07-28 Fixing csa cell to be single bit
    [asic_csa32.v]
2021-07-28 Fixing module name issue
    [asic_mux3.v]
2021-07-28 Fixing typo bug in csa32
    [asic_csa32.v]
2021-07-29 Major reorg! -stdcells moved to asiclib, doesn't make sense to be vectorized -common is a stupid name, renamed as stdlib
    [dv_driver.v, dv_stimulus.v, emesh_readback.v, gpio.v, oh_7seg_decode.v, oh_abs.v, oh_add.v, oh_and2.v]
2021-08-05 Fix whitespace in oh_padring
    - Convert tabs to spaces
    - Trim trailing whitespace
    [oh_padring.v]
2021-08-07 Insert missing comma
2021-08-13 Add parameters to disable POC/cut cells
2021-08-18 Add ring port for tech-specific power-ring signals
2021-09-23 Fixing syntax errors found by surelog
    [oh_and2.v, oh_bin2gray.v, oh_bin2onehot.v]
2022-05-28 Moving mathlib into stdlib -Less libraries is better in this case
2022-06-21 Flattening directory tree (again) - Creating an arbitrary 'src' directory really doesn't help much... - Goal is to make each folder self contained - Make meta repos and individual repos have the same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
    [asic_and2.v, asic_and3.v, asic_and4.v, asic_antenna.v, asic_ao21.v, asic_ao211.v, asic_ao22.v, asic_ao221.v]
2022-06-22 Fixing naming error -The directory should contain rtl only. -HDL is too broad a term
    [oh_7seg_decode.v, oh_abs.v, oh_add.v, oh_and2.v, oh_and3.v, oh_and4.v, oh_ao21.v, oh_ao211.v]
2022-06-25 Refactoring simulation control file - Better names (clk1/clk2 was confusing) - Removing supplies (rare special case), handle with ctrl - Remove sting passing parameters for testname, primitive, not u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
2022-06-27 Removing dut feedback loop from simulation control - ...to complicated... - incloding a simple linear test flow for "80%" of foofoo testing -
